Drident/High_Speed_Data/DAILY_REPPORT/TEST_FPGA_succes.jpeg

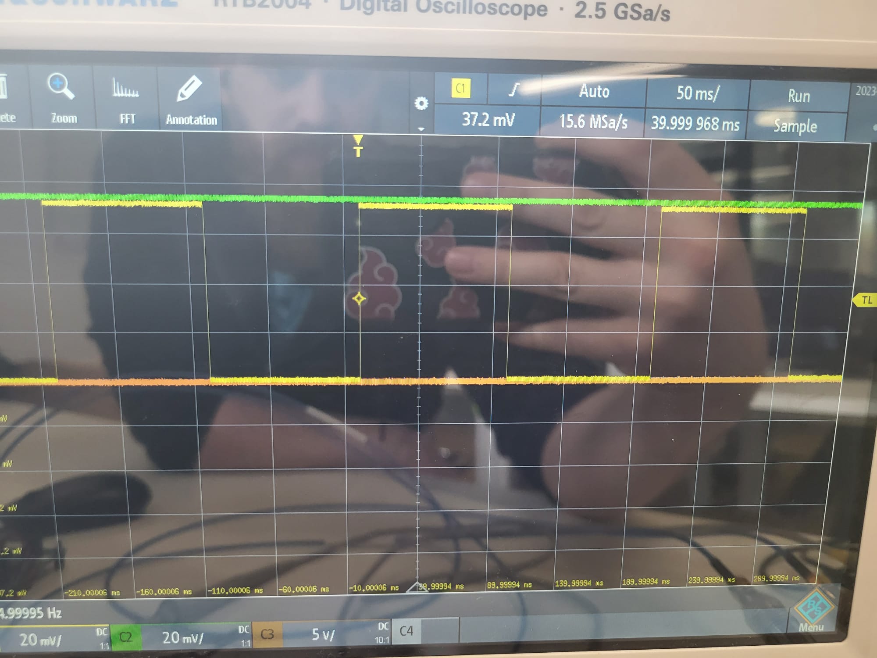
DAILY_REPPORT/TEST_FPGA_succes.jpeg
