Drident/High_Speed_Data/SD_card/README.txt

Channal trigg: put a value between 0 &3 (only in int)
Voltage Trigg(%): put a value between 0 &100 (double)
PreTrigg(%): put a value between 0 &100 (double)
