Drident/High_Speed_Data/TB_2023_Logger/LoggerBlockDiagram.pptx

µP: go_ACQ

64 MHz PCB osc.
Or External Input

FPGA

19-bit roll-over counter

Active?

Meas 1 MHz D=25%

1 MHz / 32MHz

1 MHz D=25%

32 MHz (16 periods)

µP: F-RAM address read-back

µP: SPI CLK

x6

F-RAM SCLK x4

µP: SPI sel

ADC SCLK

ADC: SPI SDO x4

meas SCLK

µP: SPI SDO

x4

F-RAM SDI x4
