Drident/High_Speed_Data/TB_2023_Logger/LoggerFunctionality.docx

## Power-up / idle ??

## Setup / readout

1. Processor read/write ADC registers
  - ADC_nCS control by proc, FRAM_x_nCS high, FPGA_nCS high
  - Proc_SPI ↔ ADC_SPI (SCLK, SDO_0, SDI, ADC_nCS)
2. Processor read/reset FPGA FRAM_ADDR_CNT and write FPGA ACQ_LEN (default 90% 2^19 )
  - ADC_nCS high, FRAM_x_nCS high, FPGA_nCS low
  - Proc_SPI ↔ FPGA_SPI (SCLK, SDO, SDI)
3. Processor read from one of four FRAM
  - ADC_nCS high, FRAM_x_nCS one low others high, FPGA_nCS high
  - Proc_SPI ↔ FRAM_SPI (SCLK, SDO, SDI)
4. Processor write to all four FRAM simultaneously (setup for acquisition)
  - ADC_nCS high, FRAM_x_nCS all low, FPGA_nCS high
  - Proc_SPI ↔ FRAM_SPI (SCLK, SDO, SDI)
  - FRAM_x_nCS stays low on transition to ACQ mode

## ACQ wait for trigger on external signal ACQ_trig

- Should happen after Setup point 4. FRAM_x_nCS must be continuously asserted low
- FPGA generates acquisition clock ACQ_CLK
  - Send to ADC_nCS
- FPGA generates acquisition SPI data clock ACQ_SCLK
  - Send to ADC_SCLK and FRAM_x_SCLK
- FPGA connects ADC_SDOx with FRAM_x_SDI
- FPGA increment FRAM_ADDR_CNT each ACQ_CLK rising edge
- Can only be interrupted by ACQ_trig (and global reset)

## ACQ trigger received on external signal ACQ_trig

- FPGA continues as above for ACQ_LEN additional ACQ_CLK rising edges
  - Then performs offset calibration
    - stops: ACQ_CLK, ACQ_SCLK
    - Change the analogue muxes to GND connection
    - Delay some time
    - starts: ACQ_CLK, ACQ_SCLK, records ~1000 samples
  - Then performs gain calibration
    - stops: ACQ_CLK, ACQ_SCLK
    - Change the analogue muxes to Reference DC voltage connection
    - Delay some time
    - starts: ACQ_CLK, ACQ_SCLK, records ~1000 samples
  - Then stops: ACQ_CLK, ACQ_SCLK, all four FRAM_x_nCS goes high
  - Signal ACQ_DONE to processor
  - Cannot be interrupted (except global reset)

FPGA external connections to other devices. → is input to FPGA, ← is output from FPGA
Proc. Connections | | ADC Connections | | FRAM_x Connections X 4 | | OTHER
→ | PROC_SCLK | ← | ADC_SCLK | ← | FRAM_x_SCLK | → | 64 MHz in
← | PROC_SDI | → | ADC_SDO_0 | → | FRAM_x_SDI | → | ACQ_trig
→ | PROC_SDO | → | ADC_SDO_1 | ← | FRAM_x_SDO? | → | Reset?
→ | PROC_nCS | → | ADC_SDO_2 | → | FRAM_x_nCS
→ | ACQ_pretrig | → | ADC_SDO_3
← | ACQ_DONE | ← | ADC_SDI?
| | ← | ADC_nCS
| 6 + mode control! | | 7 pins | | 16 pins | | 2 pins

- Could connect FRAM_x_SDO directly with PROC_SDI outside FPGA and tristate FPGA SPI bus.
- Could connect ADC_SDI directly with PROC_SDO outside FPGA and tristate FPGA SPI bus
- Can we reset from CRESET_B to redo configuration download from SRAM? Or power cycle reset?
