Drident/High_Speed_Data/TB_2023_Logger/forget_code/fram_h.pdf

1 /*
2 * fram_func.h
3 *
4 * Created on: 6 juil. 2023
5 | * Author: christop.grobety
6 */
7
8 #ifndef INC_FRAM_FUNC_H_
9 #define INC_FRAM_FUNC_H_ 10
11 #define MEMORY_SIZE 524288 12 #include "main.h"
13 #include <stdbool.h>
14 #include <stdio.h>
15
16 /**
17 * @brief Write one or more value in a FRAM
18 * @param State state_: FRAM where to send the value(s)
19 * @param TX_FRAM: Pointer of the table to send
20 * @param data_size: Number of values to send on the FRAM
21 * @param hspi_1 : SPI of the STM32 to use to send the value
22 */
23 void FRAM_write_one(enum State state_, uint8_t*TX_FRAM, uint8_t data_size, SPI_HandleTypeDef hspi_1);
24
25 /**
26 * @brief Write one or more value in all the FRAMs
27 * @param TX_FRAM: Pointer of the table to send
28 * @param data_size: Number of values to send on the FRAMs
29 * @param hspi_1 : SPI of the STM32 to use to send the value
30 */
31 void FRAM_write_all(SPI_HandleTypeDef hspi_1, uint8_t*TX_FRAM, uint8_t data_size); 32
33 /**
34 * @brief Write in all the FRAMs the instruction of receive datas from ADC DEVICE 35 * @param hspi_1 : SPI of the STM32 to use to send the value
36 */
37 void FRAM_write_ADC_to_FRAM(SPI_HandleTypeDef hspi_1);
38
39 /**
40 * @brief Write in all the FRAMs the instruction to set the register for write instruction
41 * @param hspi_1 : SPI of the STM32 to use to send the value
42 */
43 void FRAM_write_reg(SPI_HandleTypeDef hspi_1);
44
45 /**
46 * @brief Write in all the FRAMs the instruction to reset the register 47 * @param hspi_1 : SPI of the STM32 to use to send the value
48 */
49 void FRAM_reset_reg(SPI_HandleTypeDef hspi_1);
50
51 /**
52 * @brief Write in all the FRAMs the instruction to reset the register 53 * @param State state_: FRAM where to read the Register's values
54 * @param hspi_1 : SPI of the STM32 to use to send the value
55 */
56 void FRAM_read_reg(enum State state_, SPI_HandleTypeDef hspi_1); 57
58 /**
59 * @brief Read in a FRAM his Device's value
60 * @param hspi_1 : SPI of the STM32 to use to send the value 61 */
62 void FRAM_device(SPI_HandleTypeDef hspi_1);
63
64 /**
65 * @brief Read in a FRAM his Device's value
66 * @param State state_: FRAM where to read the Register's values
67 * @param add: Location of the first address to start read the value of a FRAM 68 * @param hspi_1 : SPI of the STM32 to use to send the value
69 * @param data_size : size of the address where to read value
70 * @return a pointer of a table with the FRAM's values
71 */

### 72 uint8_t* FRAM_read(enum State state_, uint32_t add,SPI_HandleTypeDef hspi_1, uint8_t

data_size);
73
74 /**
75 * @brief Reset the values of the Selector's pins to send in the FPGA 76 */
77 void PIN_reset();
78
79 /**
80 * @brief Send the value of pretrigger to the FPGA
81 * @param hspi_1 : SPI of the STM32 to use to send the value 82 * @param pretrig : pretrig's value to send to the FPGA
83 */
84 void setPreTrigg(SPI_HandleTypeDef hspi_1, uint8_t pretrig); 85
86 /**
87 * @brief Selection of the channel to trigg
88 * @param chan: value of the channel to use 89 */
90 void setTriggChannel(enum trig_channel chan); 91
92 /**
93 * @brief To turn on a Led
94 * @param color: color of the Led to turn on 95 */
96 void LED_on(enum color_Led color);
97
98 /**
99 * @brief To turn off a Led
100 */
101 void LED_off();
102
103
104 #endif /* INC_FRAM_FUNC_H_ */ 105
