Drident/High_Speed_Data/Bachelor/Board/icecube2/test/test_Implmnt/syntmp/statusReport.html

Project Settings
Project Name | test_syn | Implementation Name | test_Implmnt
Top Module | [auto] | Pipelining | 1
Retiming | 0 | Resource Sharing | 1
Fanout Guide | 10000 | Disable I/O Insertion | 0
Disable Sequential Optimizations | 0 | Clock Conversion | 1

Run Status
Job Name | Status | | | | CPU Time | Real Time | Memory | Date/Time
(compiler) | Complete | 34 | 75 | 0 | - | 00m:00s | - | 28.07.2023 14:09:21
(premap) | Complete | 5 | 2 | 0 | 0m:00s | 0m:00s | 134MB | 28.07.2023 14:09:23
(fpga_mapper) | Complete | 41 | 78 | 0 | 0m:01s | 0m:01s | 137MB | 28.07.2023 14:09:24
Multi-srs Generator | Complete | | | | | | | 28.07.2023 14:09:22

Area Summary
PADS | 35 | FLOPS | 151
RAMS (v_ram) | 0 | CARRYS | 60
LUTS (total_luts) | 212

Timing Summary
Clock Name | Req Freq | Est Freq | Slack
EC5LP|iGCK_clk | 112.8 MHz | 95.9 MHz | -1.564
System | 344.2 MHz | 507.3 MHz | 0.934

Optimizations Summary
Combined Clock Conversion | 1 / 0
