Drident/High_Speed_Data/TB_2023_Logger/forget_code/isrs_c.pdf

1 /*
2 * isrs.c
3 *
4 * Created on: Jun 30, 2023
5 | * Author: christop.grobety
6 */
7
8 #include "stm32l4xx_hal.h"
9 #include "main.h"
10 #include "fram_func.h"
11
12 void HAL_GPIO_EXTI_Callback(uint16_t GPIO_Pin)
13 {
14 if(GPIO_Pin == FPGA_DONE_Pin){
15 //---------------------------------------------------RECEIVE ADD------------------------------------------16 LED_on(BLUE);
17 start = true;
18 HAL_ResumeTick();
19 acqu = false;
20 //sleep_ = 1;
21 }
22 else if(GPIO_Pin == WAKE_UP_Pin ){
23 //---------------------------------------------------START ACQU------------------------------------------24 if(start){
25 HAL_ResumeTick();
26 start = false;
27 }
28 }
29 else if(GPIO_Pin == ARM_BUTTON_Pin){
30 //---------------------------------------------------RESET SYSTEM------------------------------------------31 if(reset){
32 reset = false;
33 HAL_NVIC_SystemReset(); 34 }
35 }
36 }
37
