Drident/High_Speed_Data/TB_2023_Logger/Lattice/iCE40UltraUltraPlusSG48Pinout.xlsx

# SG48 Pin Out For iCE5LP-1K, -2K, -4K & iCE40UP-5K
# Revision 0.3 - Add in UltraPlus Devices
# Revision 1.1 - Fix RGB pins, swapped pins 39 & 41
# Updated March 16, 2018
# Revision 2.0 - IOB_35b_SPI_CSN to IOB_35b_SPI_SS
# Updated Aug 4, 2020
 |  |  |  | iCE5LP-1K | iCE5LP-2K | iCE5LP-4K | iCE40UP-5K
FNC | Pin Type | BANK | Differential Pair | SG48 | SG48 | SG48 | SG48
IOB_0a | DPIO | 2 | TRUE_of_IOB_1b | 46 | 46 | 46 | 46
IOB_2a | DPIO | 2 | TRUE_of_IOB_3b | 47 | 47 | 47 | 47
IOB_3b_G6 | DPIO / GBIN | 2 | COMP_of_IOB_2a | 44 | 44 | 44 | 44
IOB_4a | DPIO | 2 | TRUE_of_IOB_5b | 48 | 48 | 48 | 48
IOB_5b | DPIO | 2 | COMP_of_IOB_4a | 45 | 45 | 45 | 45
IOB_6a | DPIO | 2 | TRUE_of_IOB_7b | 2 | 2 | 2 | 2
IOB_8a | PIO | 2 | TRUE_of_IOB_9b | 4 | 4 | 4 | 4
IOB_9b | PIO | 2 | COMP_of_IOB_8a | 3 | 3 | 3 | 3
creset_b | CONFIG | 1 |  | 8 | 8 | 8 | 8
IOB_13b | PIO | 1 |  | 6 | 6 | 6 | 6
CDONE | CONFIG | 1 |  | 7 | 7 | 7 | 7
IOB_16a | PIO | 1 |  | 9 | 9 | 9 | 9
IOB_18a | PIO | 1 |  | 10 | 10 | 10 | 10
IOB_20a | PIO | 1 |  | 11 | 11 | 11 | 11
IOB_22a | PIO | 1 | TRUE_of_IOB_23b | 12 | 12 | 12 | 12
IOB_23b | PIO | 1 | COMP_of_IOB_22a | 21 | 21 | 21 | 21
IOB_24a | PIO | 1 |  | 13 | 13 | 13 | 13
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
