Drident/High_Speed_Data/DAILY_REPPORT/Board.jpeg

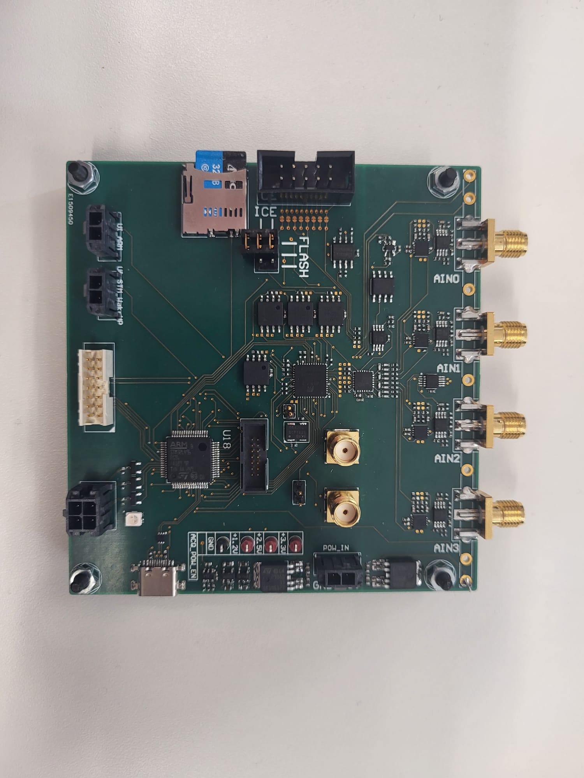
DAILY_REPPORT/Board.jpeg
