Drident/High_Speed_Data/DAILY_REPPORT/FPGA/adc_fram.png

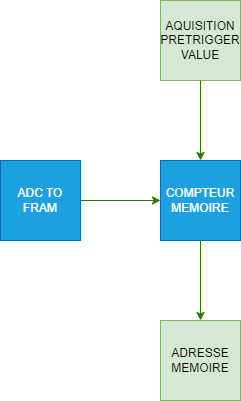
DAILY_REPPORT/FPGA/adc_fram.png
