Drident/High_Speed_Data/DAILY_REPPORT/FPGA/blocks.png

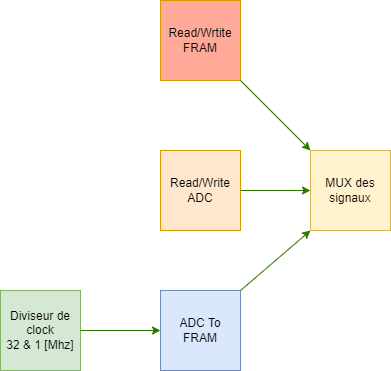
DAILY_REPPORT/FPGA/blocks.png
