Drident/High_Speed_Data/DAILY_REPPORT/FPGA/clock_1_2.png

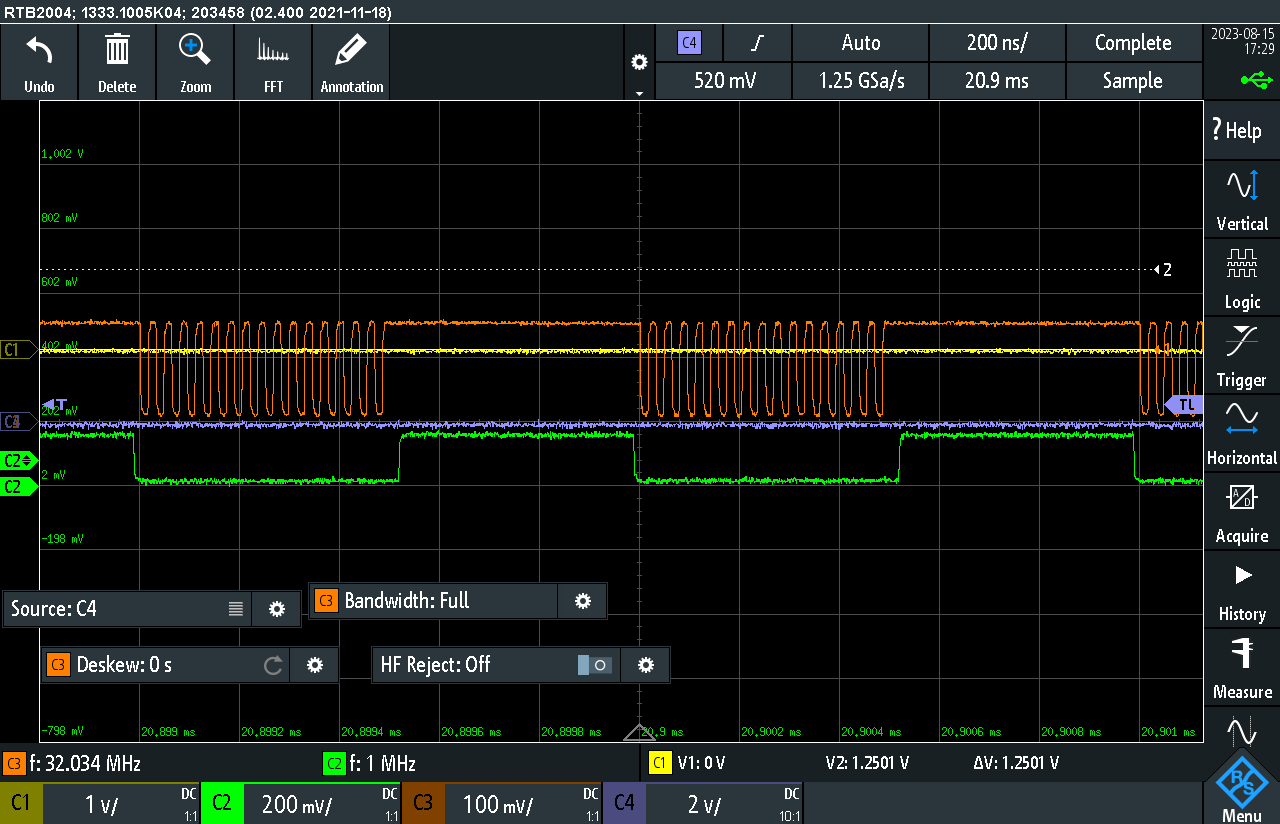
DAILY_REPPORT/FPGA/clock_1_2.png
