Drident/High_Speed_Data/DAILY_REPPORT/FPGA/CRAM.png

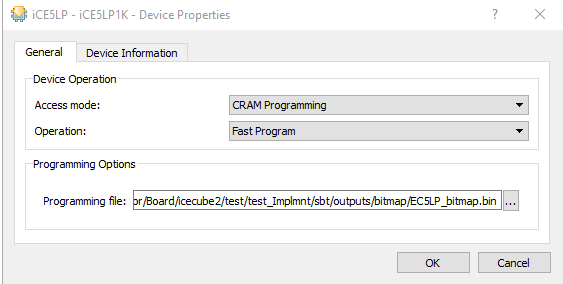
DAILY_REPPORT/FPGA/CRAM.png
