Drident/High_Speed_Data/DAILY_REPPORT/FPGA/delta_t.png

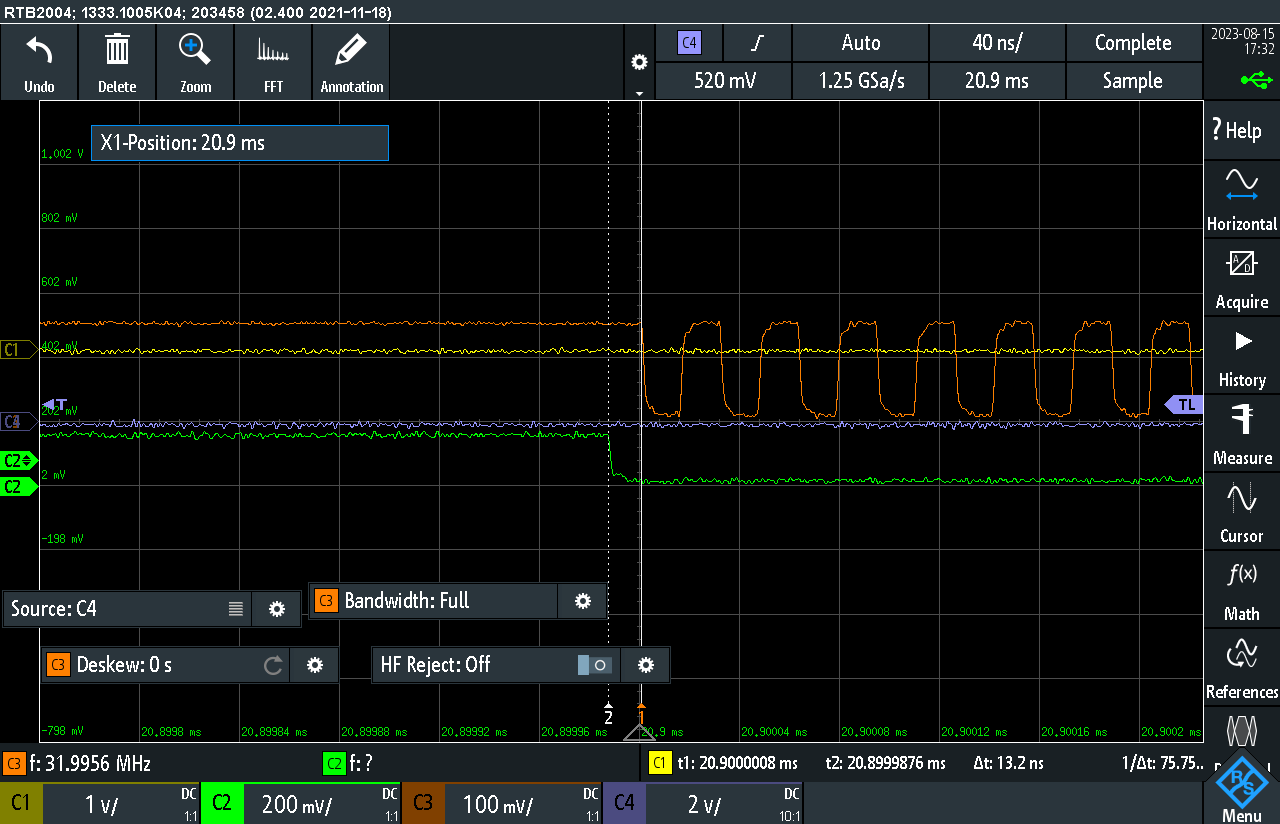
DAILY_REPPORT/FPGA/delta_t.png
