Drident/High_Speed_Data/DAILY_REPPORT/FPGA/file.png

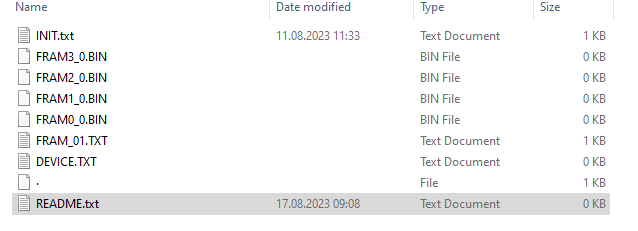
DAILY_REPPORT/FPGA/file.png
