Drident/High_Speed_Data/DAILY_REPPORT/FPGA/PRINCIPAL_BLOC.png

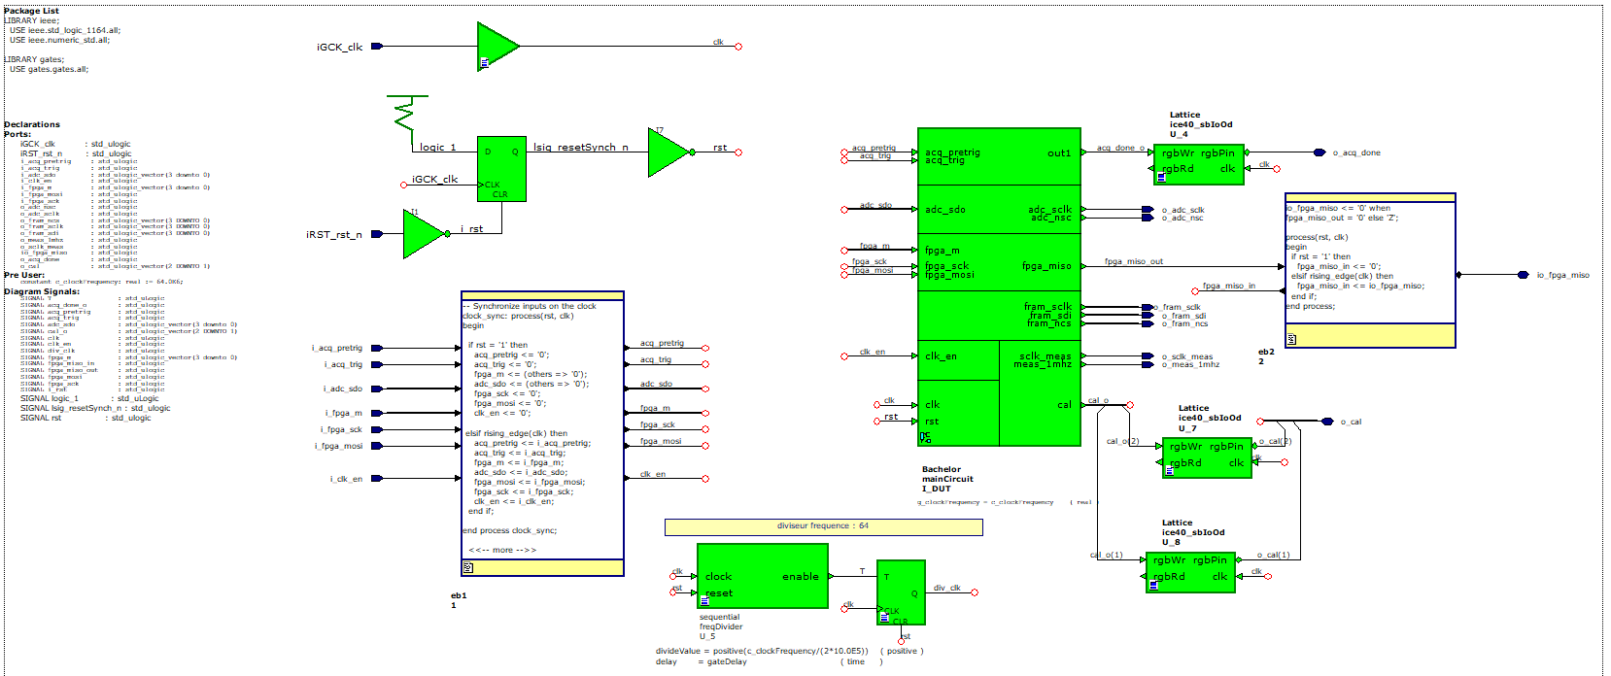
DAILY_REPPORT/FPGA/PRINCIPAL_BLOC.png
