Drident/High_Speed_Data/DAILY_REPPORT/FPGA/SD_CARD.png

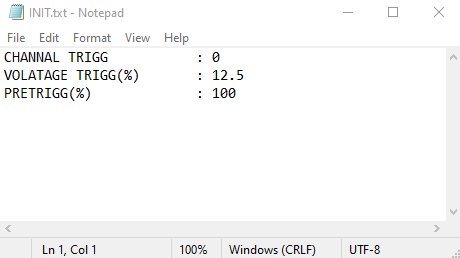
DAILY_REPPORT/FPGA/SD_CARD.png
