Drident/High_Speed_Data/DAILY_REPPORT/FPGA/SECOND_BLOC.png

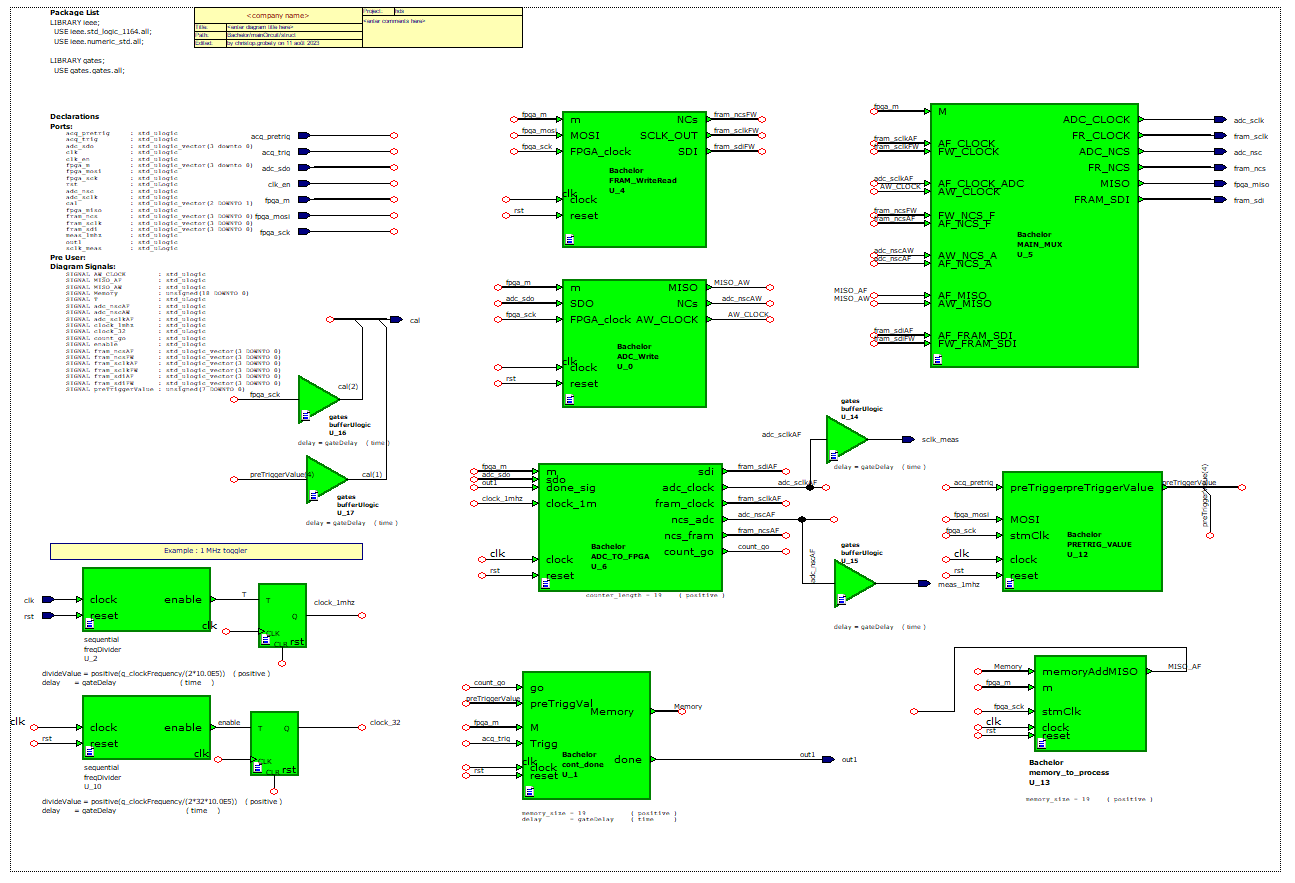
DAILY_REPPORT/FPGA/SECOND_BLOC.png
