Drident/High_Speed_Data/DAILY_REPPORT/FPGA/selector.png

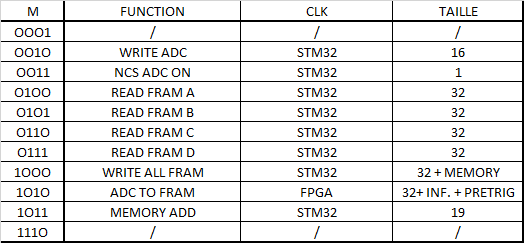
DAILY_REPPORT/FPGA/selector.png
