Drident/High_Speed_Data/DAILY_REPPORT/FPGA/SPI.png

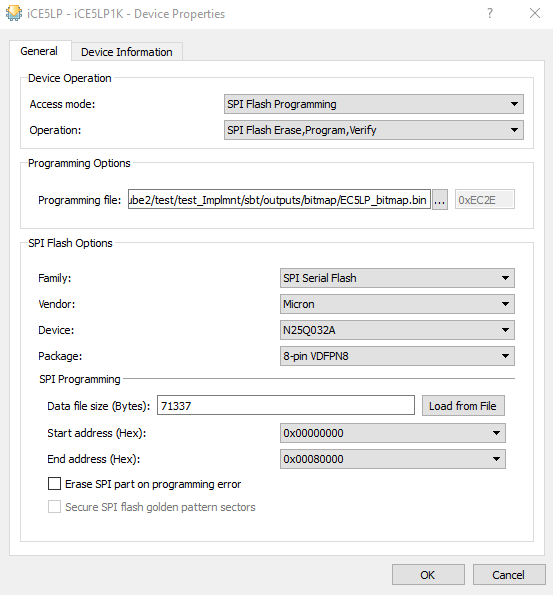
DAILY_REPPORT/FPGA/SPI.png
