Drident/High_Speed_Data/DAILY_REPPORT/FPGA/SPI_SHEMA.png

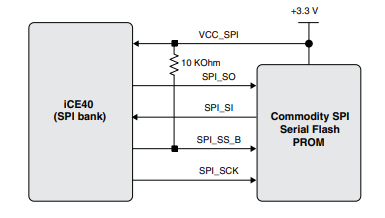
DAILY_REPPORT/FPGA/SPI_SHEMA.png
