Drident/High_Speed_Data/DAILY_REPPORT/image_dataSheet/ADC_TIMING.png

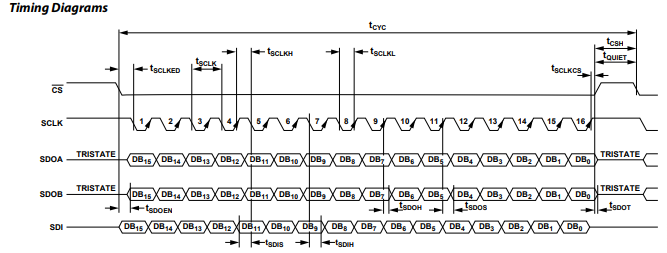
DAILY_REPPORT/image_dataSheet/ADC_TIMING.png
