Drident/High_Speed_Data/DAILY_REPPORT/image_dataSheet/bruit.png

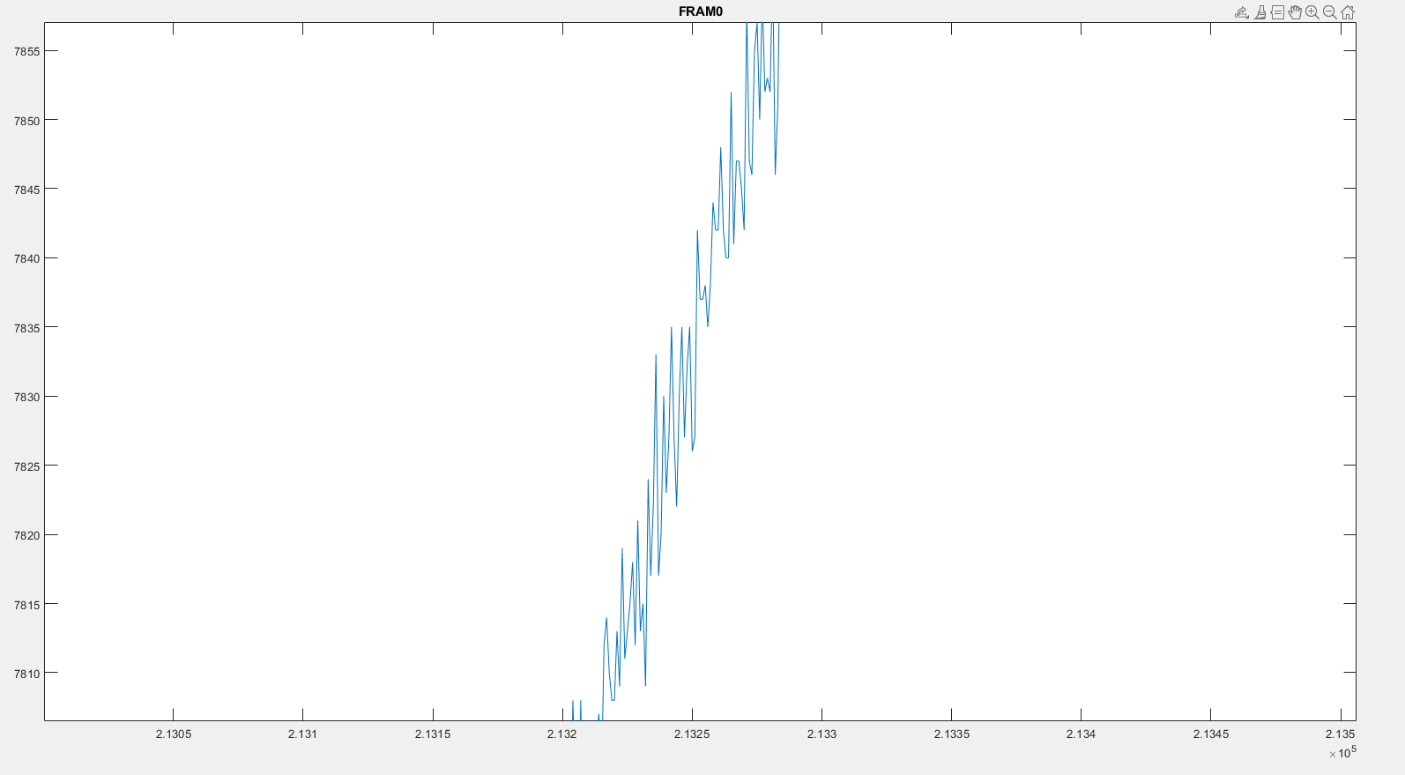
DAILY_REPPORT/image_dataSheet/bruit.png
