Drident/High_Speed_Data/DAILY_REPPORT/image_dataSheet/Capture d’écran 2023-08-11 172444.png

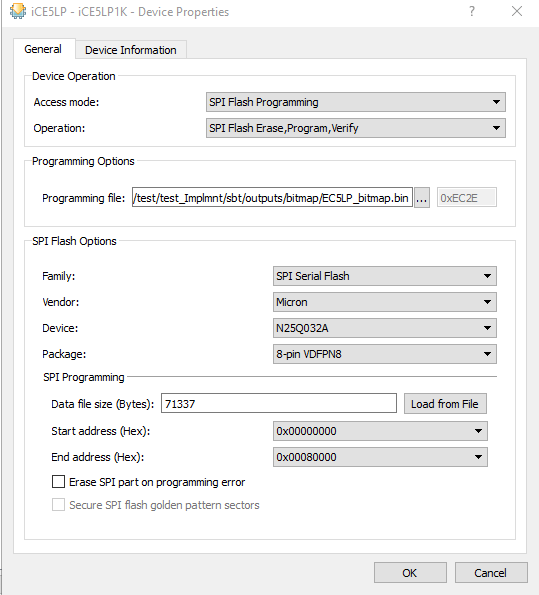
DAILY_REPPORT/image_dataSheet/Capture d’écran 2023-08-11 172444.png
