Drident/High_Speed_Data/DAILY_REPPORT/image_dataSheet/FRAM0_10HZ.png

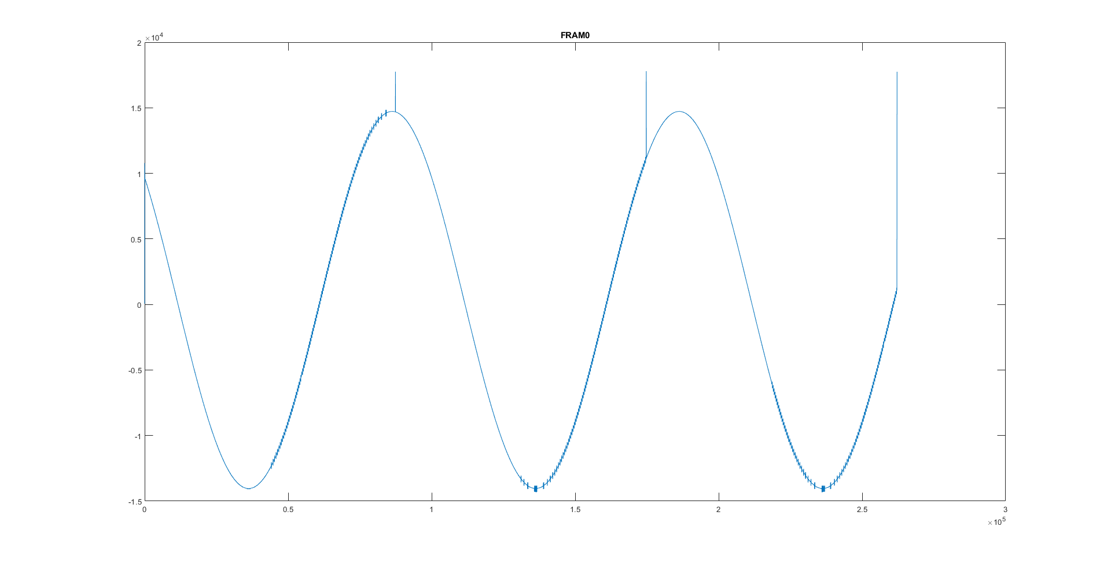
DAILY_REPPORT/image_dataSheet/FRAM0_10HZ.png
