Drident/High_Speed_Data/DAILY_REPPORT/image_dataSheet/FRAM0_70hz_1V_125OFF.png

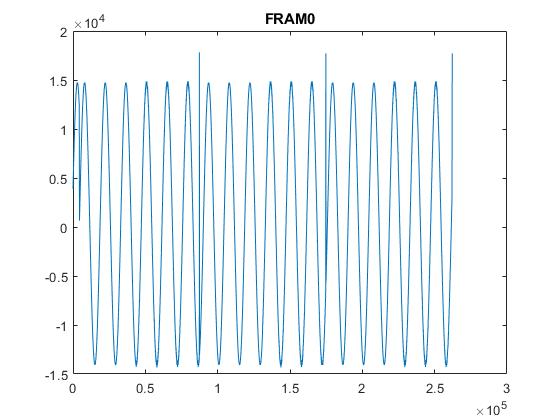
DAILY_REPPORT/image_dataSheet/FRAM0_70hz_1V_125OFF.png
