Drident/High_Speed_Data/DAILY_REPPORT/image_dataSheet/FRAM1_NULL.png

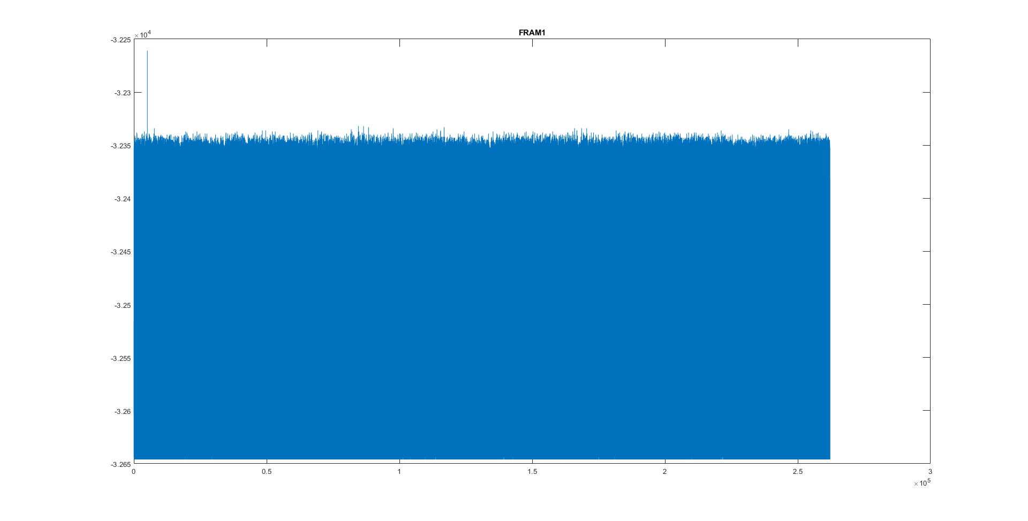
DAILY_REPPORT/image_dataSheet/FRAM1_NULL.png
