Drident/High_Speed_Data/DAILY_REPPORT/image_dataSheet/fram2_60HZ.png

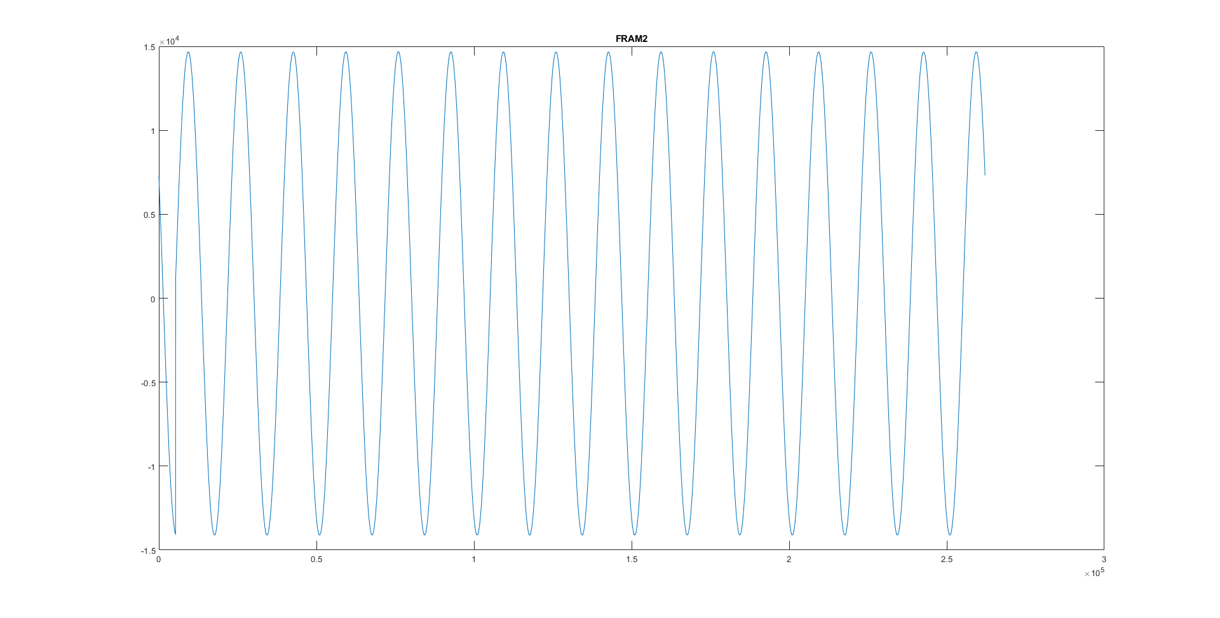
DAILY_REPPORT/image_dataSheet/fram2_60HZ.png
