Drident/High_Speed_Data/DAILY_REPPORT/image_dataSheet/FRAM_READ.png

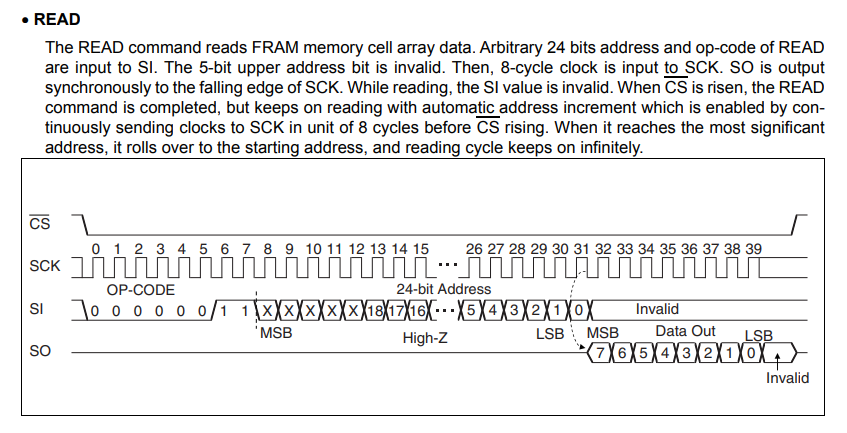
DAILY_REPPORT/image_dataSheet/FRAM_READ.png
