Drident/High_Speed_Data/DAILY_REPPORT/image_dataSheet/perturbation1.png

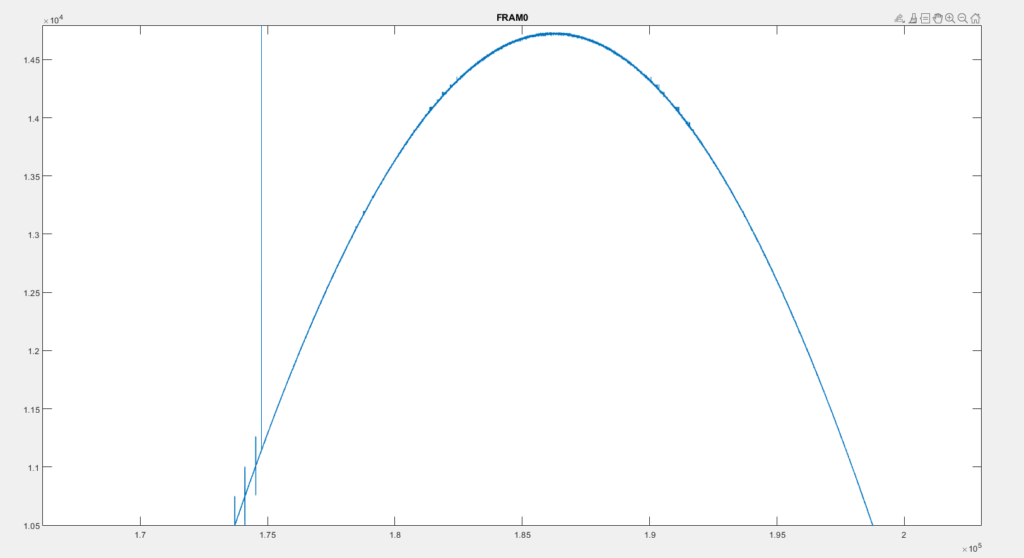
DAILY_REPPORT/image_dataSheet/perturbation1.png
