Drident/High_Speed_Data/DAILY_REPPORT/image_dataSheet/perturbation.png

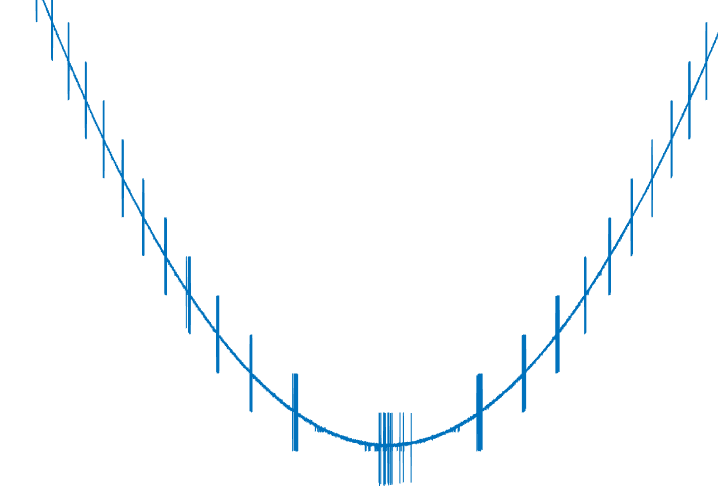
DAILY_REPPORT/image_dataSheet/perturbation.png
