Drident/High_Speed_Data/DAILY_REPPORT/image_dataSheet/perturbation_0.png

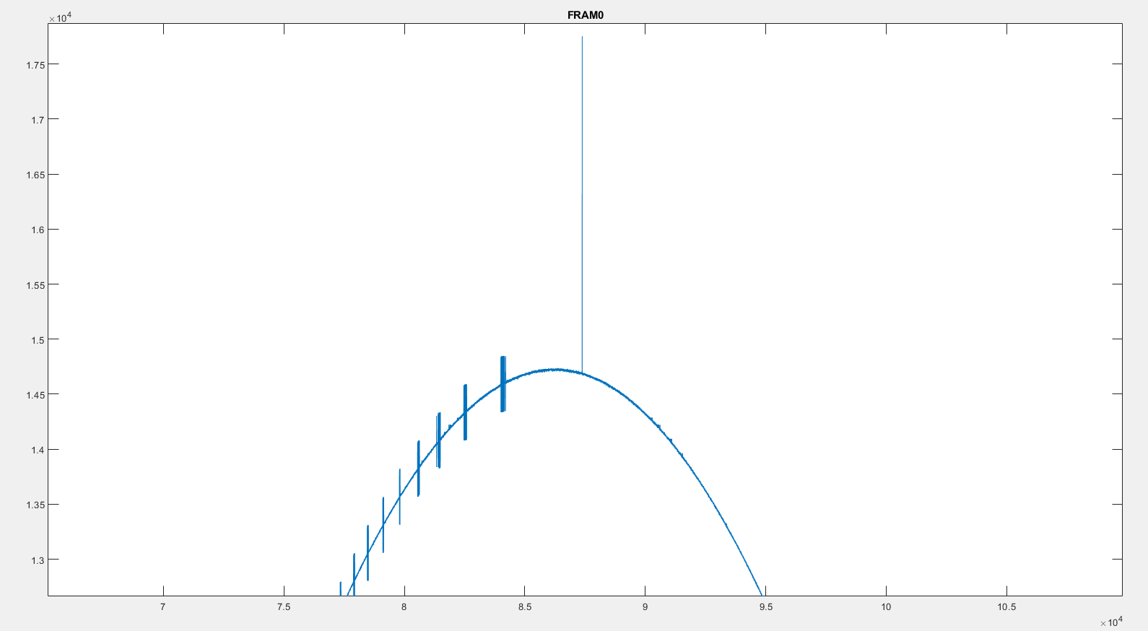
DAILY_REPPORT/image_dataSheet/perturbation_0.png
