Drident/High_Speed_Data/DAILY_REPPORT/image_dataSheet/untitled3.png

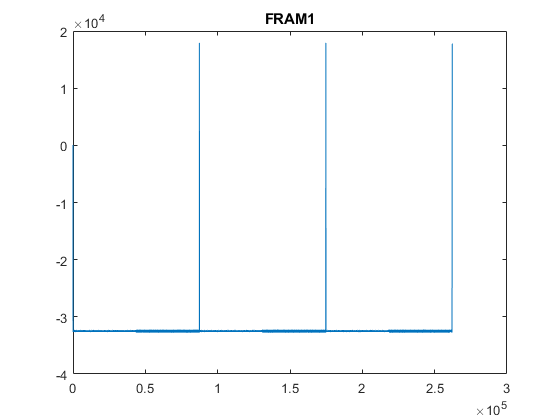
DAILY_REPPORT/image_dataSheet/untitled3.png
