Drident/High_Speed_Data/DAILY_REPPORT/image_simu_fpga/ADC_INIT.png

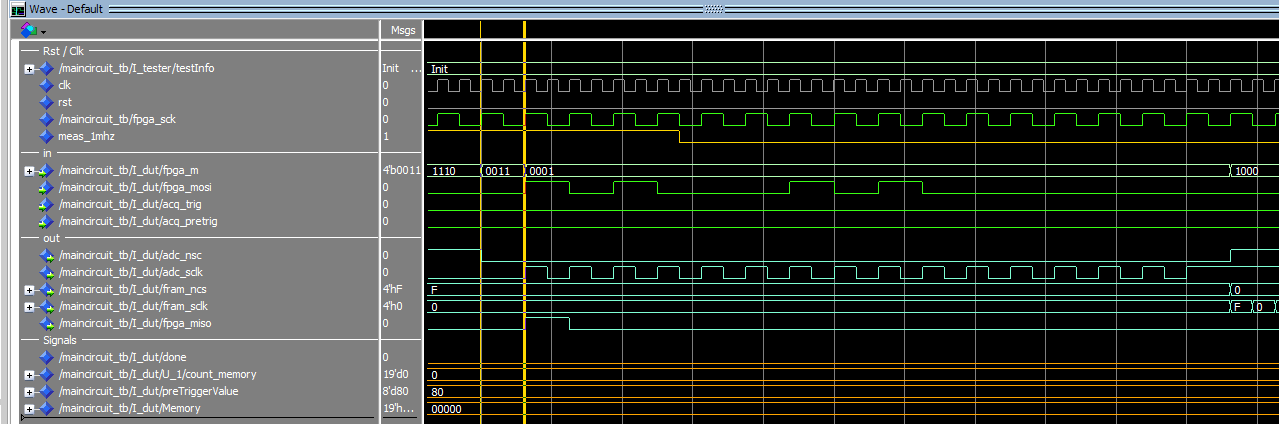
DAILY_REPPORT/image_simu_fpga/ADC_INIT.png
