Drident/High_Speed_Data/DAILY_REPPORT/image_simu_fpga/ADC_TOFRAM_BLOCKS.png

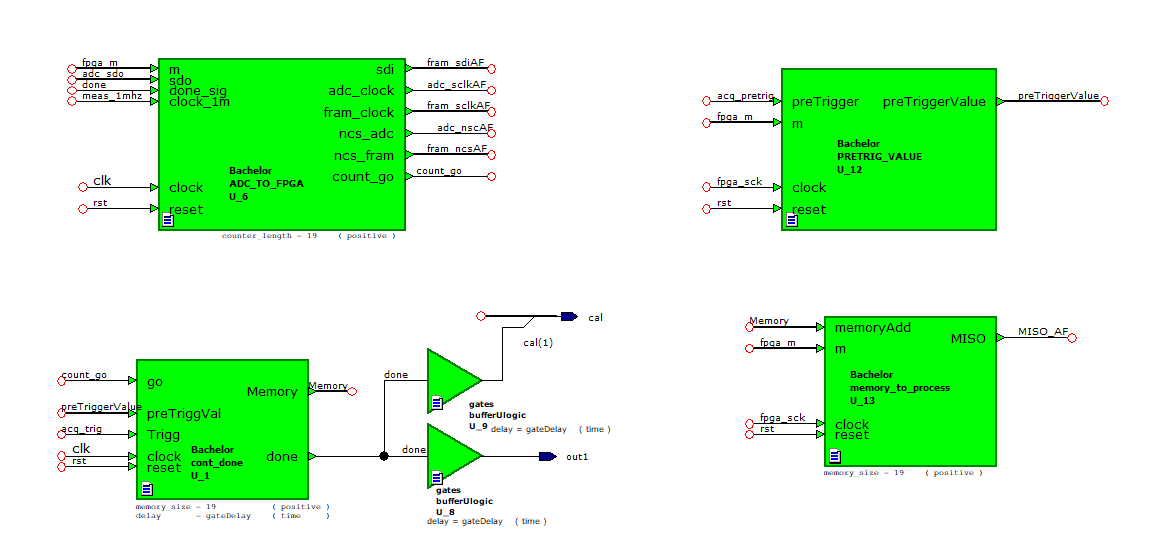
DAILY_REPPORT/image_simu_fpga/ADC_TOFRAM_BLOCKS.png
