Drident/High_Speed_Data/DAILY_REPPORT/image_simu_fpga/DELAY_aDC.png

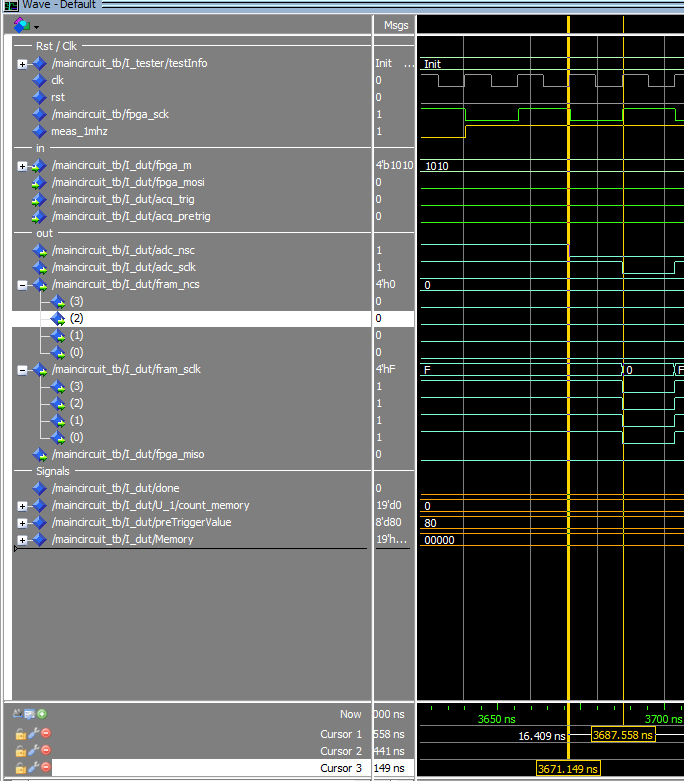
DAILY_REPPORT/image_simu_fpga/DELAY_aDC.png
