Drident/High_Speed_Data/DAILY_REPPORT/image_simu_fpga/FRAM_INIT_WRITE.png

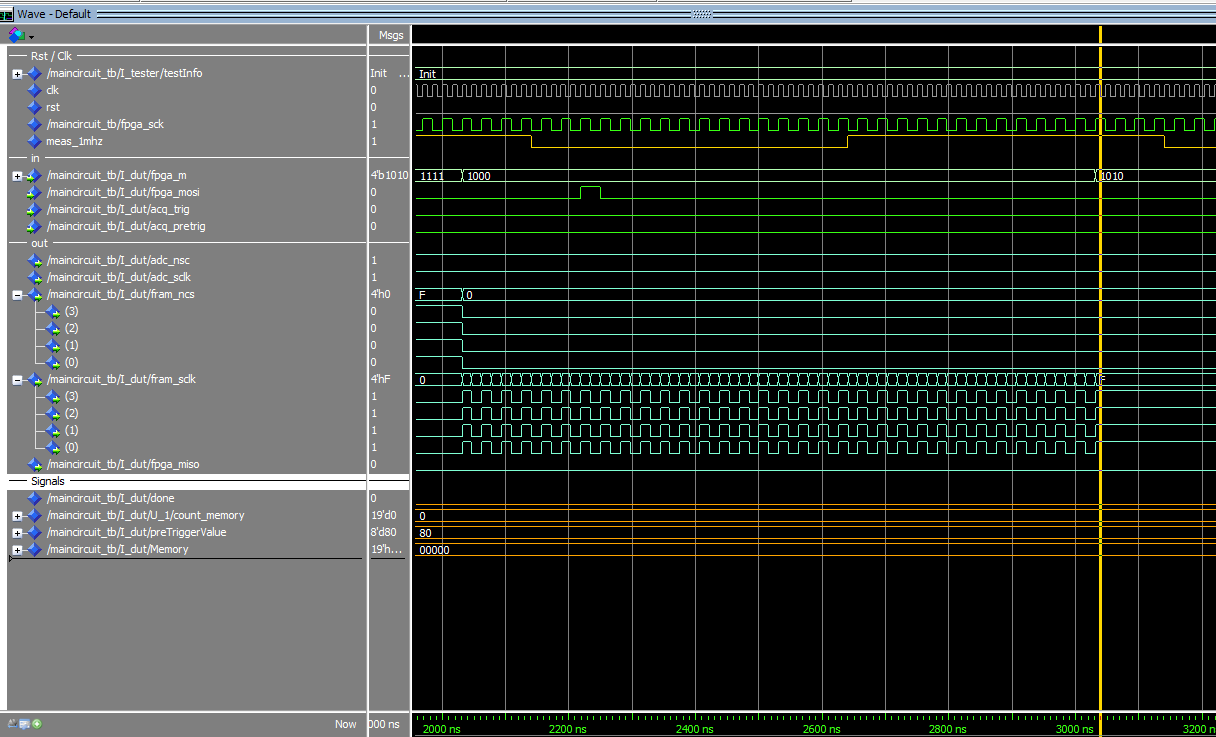
DAILY_REPPORT/image_simu_fpga/FRAM_INIT_WRITE.png
