Drident/High_Speed_Data/DAILY_REPPORT/image_simu_fpga/FRAM_READ_INIT.png

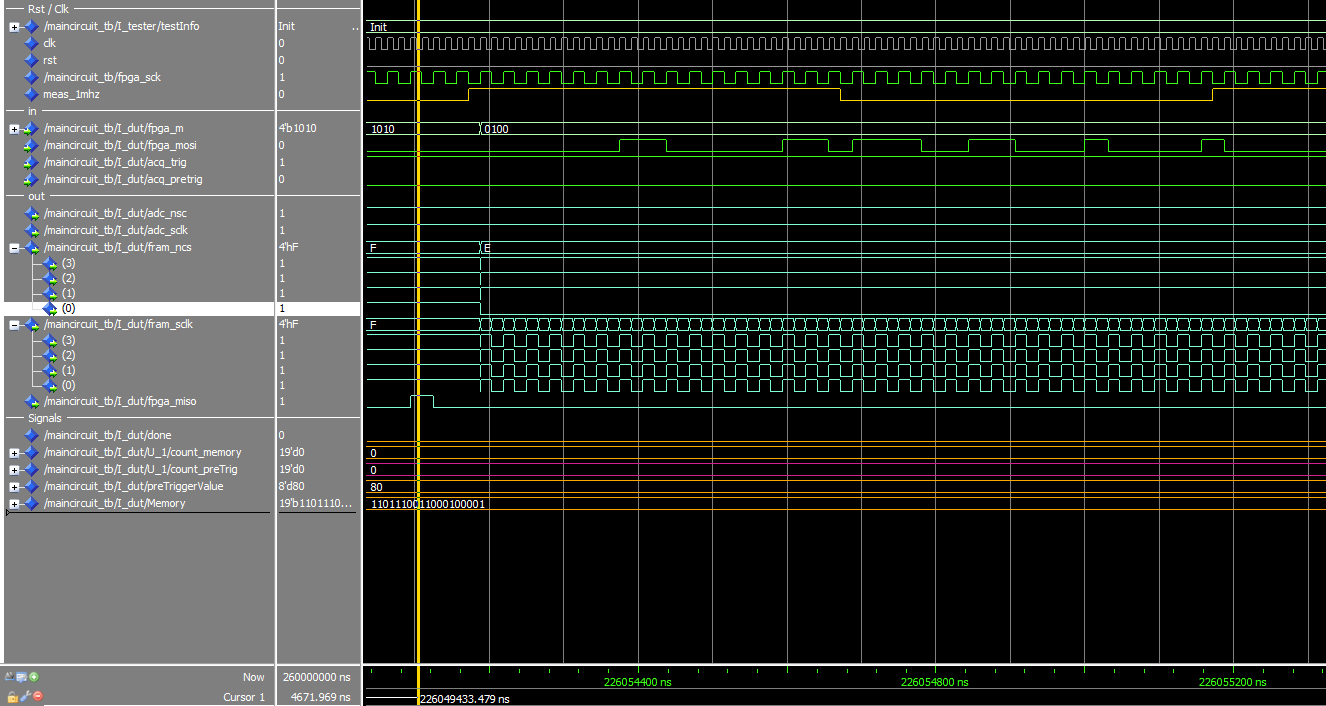
DAILY_REPPORT/image_simu_fpga/FRAM_READ_INIT.png
