Drident/High_Speed_Data/DAILY_REPPORT/image_simu_fpga/FRAM_WRITE_BLOCK.png

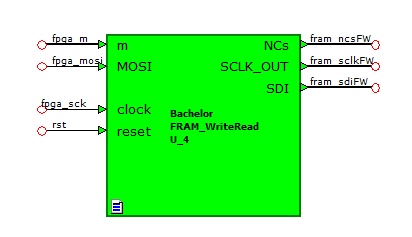
DAILY_REPPORT/image_simu_fpga/FRAM_WRITE_BLOCK.png
