Drident/High_Speed_Data/DAILY_REPPORT/image_simu_fpga/MEMORY_ADD.png

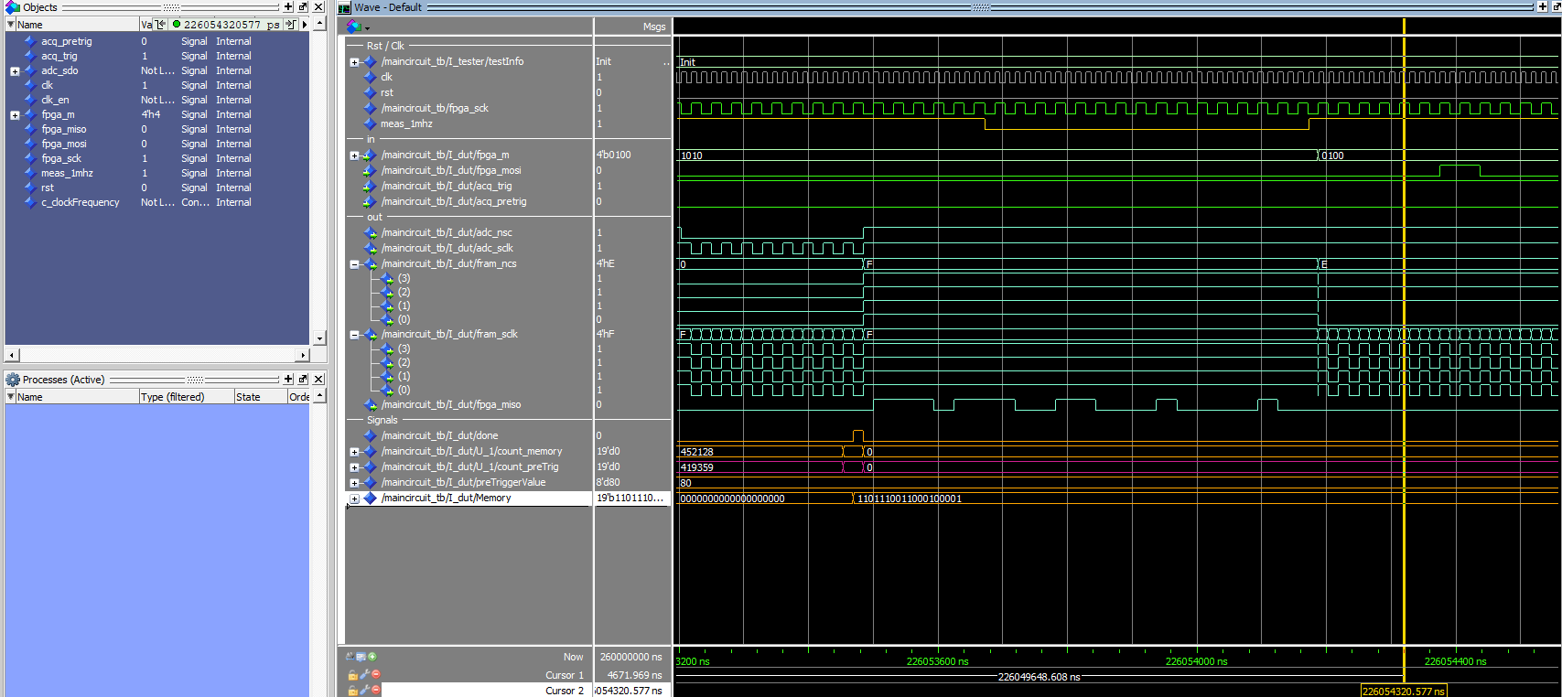
DAILY_REPPORT/image_simu_fpga/MEMORY_ADD.png
