Drident/High_Speed_Data/DAILY_REPPORT/image_simu_fpga/preTrig_INIT2.png

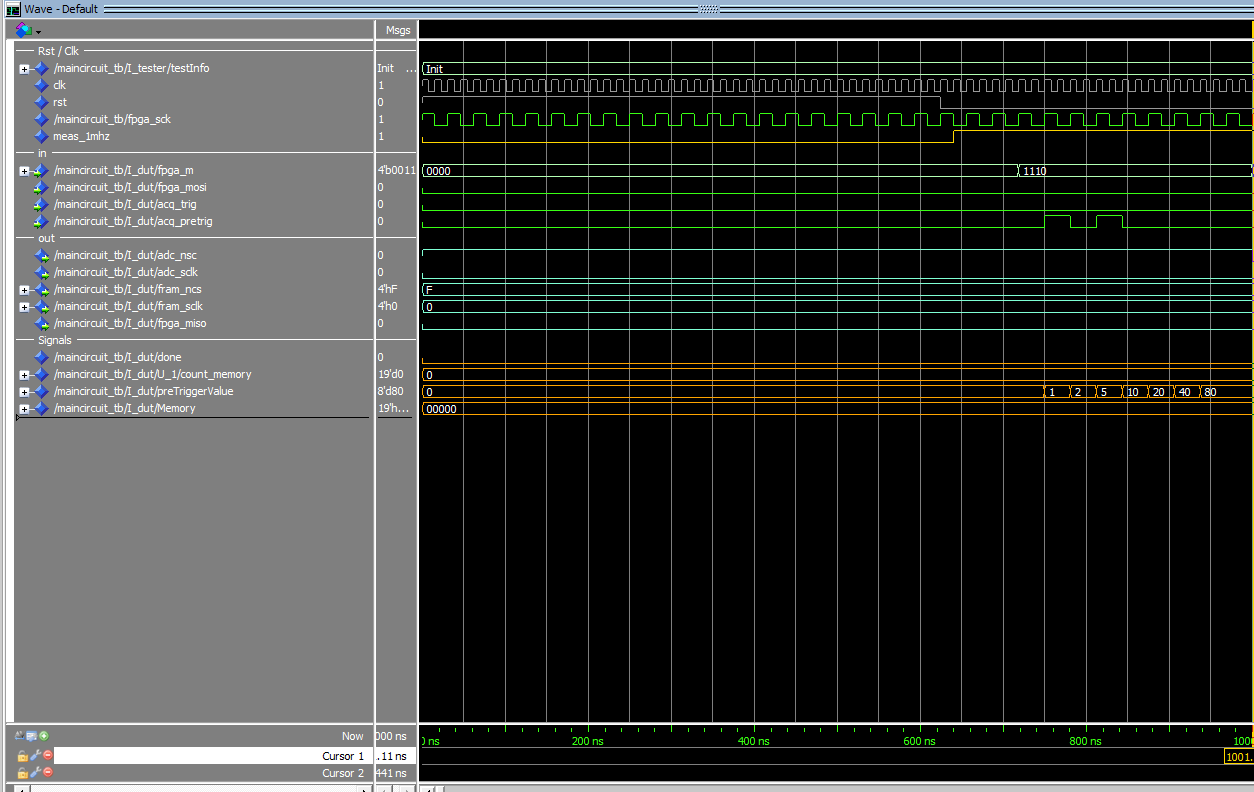
DAILY_REPPORT/image_simu_fpga/preTrig_INIT2.png
