Drident/High_Speed_Data/DAILY_REPPORT/image_simu_fpga/TRIGGER_DONE.png

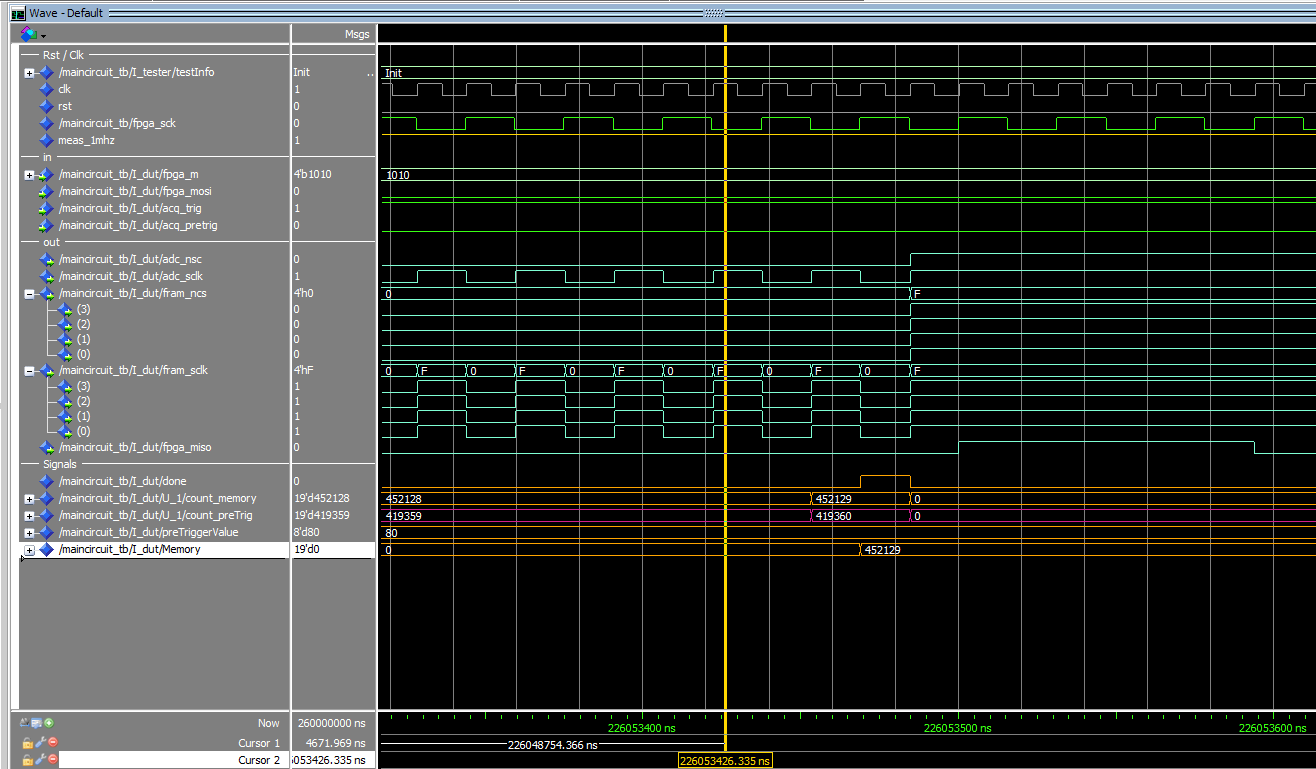
DAILY_REPPORT/image_simu_fpga/TRIGGER_DONE.png
