Drident/High_Speed_Data/DAILY_REPPORT/image_simu_fpga/TRIGGER_START.png

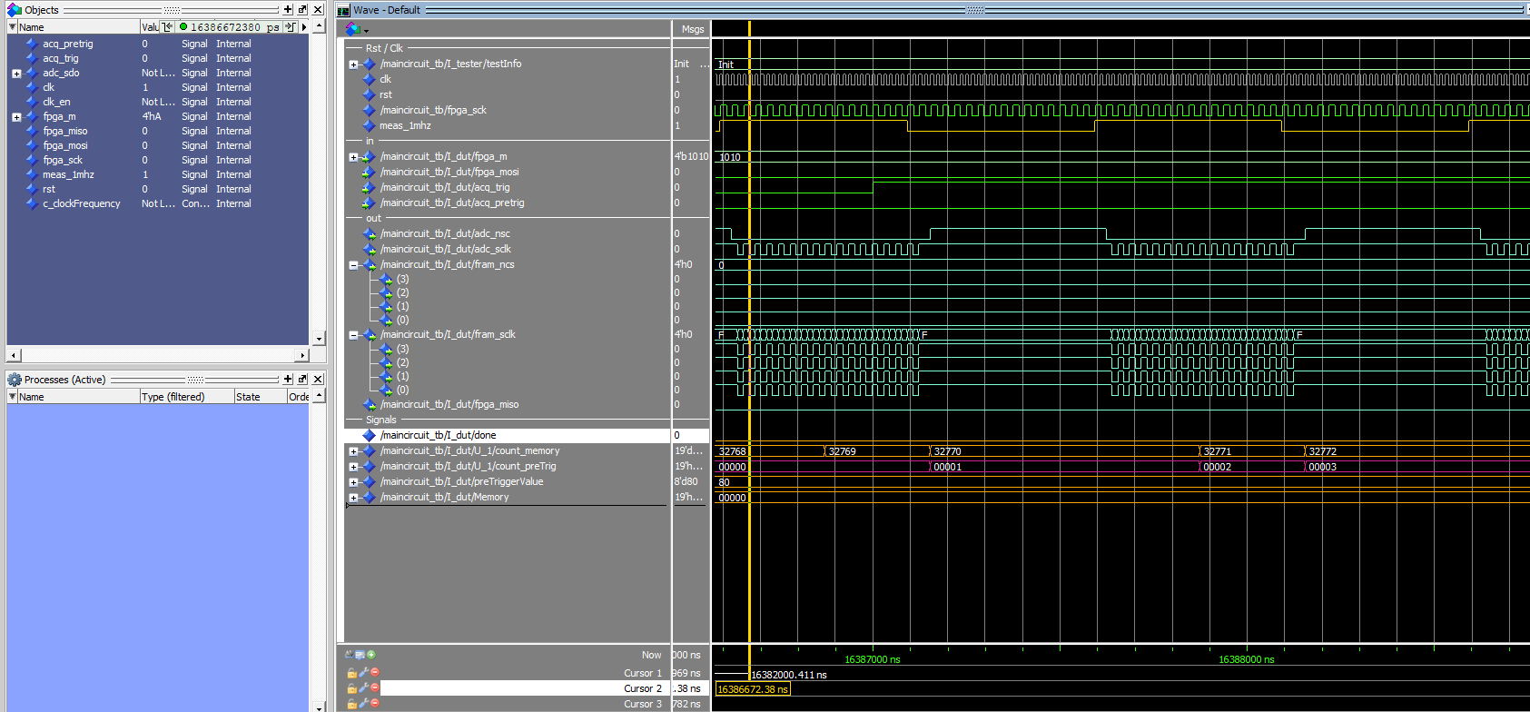
DAILY_REPPORT/image_simu_fpga/TRIGGER_START.png
