Drident/High_Speed_Data/DAILY_REPPORT/LATTICE_connector.jpeg

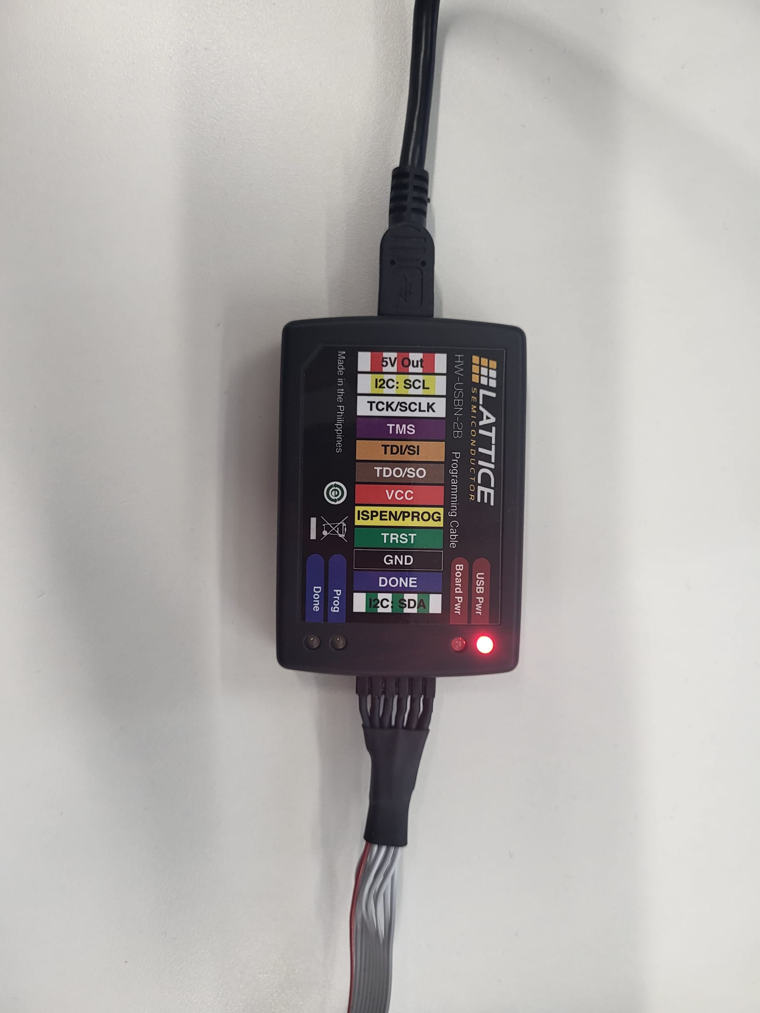
DAILY_REPPORT/LATTICE_connector.jpeg
