Drident/High_Speed_Data/DAILY_REPPORT/SHEMAS_DESIGN_IMAGE/VISUAL SHEMA.png

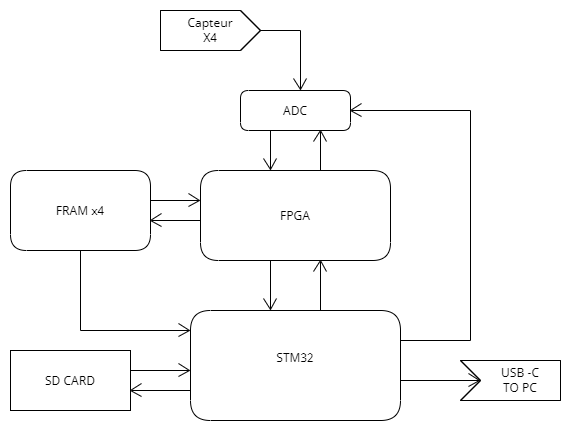
DAILY_REPPORT/SHEMAS_DESIGN_IMAGE/VISUAL SHEMA.png
