Drident/High_Speed_Data/DAILY_REPPORT/stm32/configuration.png

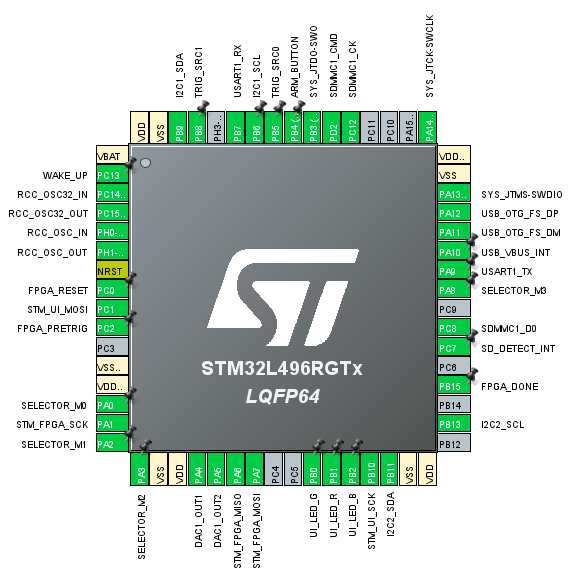
DAILY_REPPORT/stm32/configuration.png
