Drident/High_Speed_Data/DAILY_REPPORT/stm32/NVIC.png

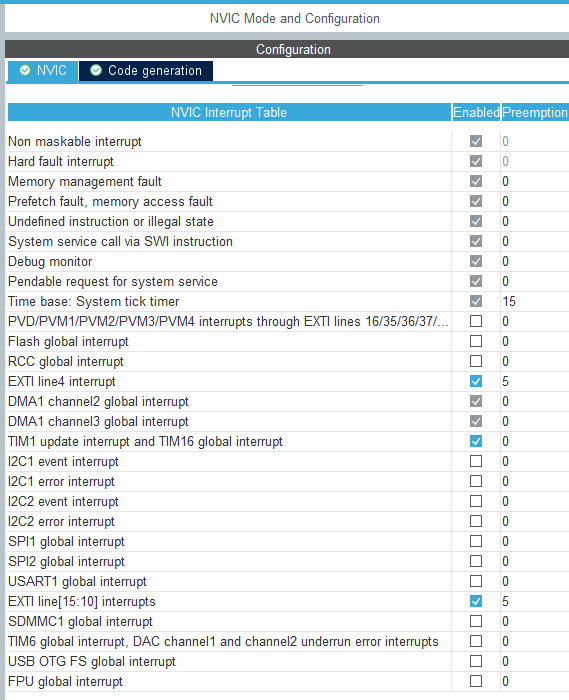
DAILY_REPPORT/stm32/NVIC.png
