Drident/High_Speed_Data/DAILY_REPPORT/stm32/SDMMC1.png

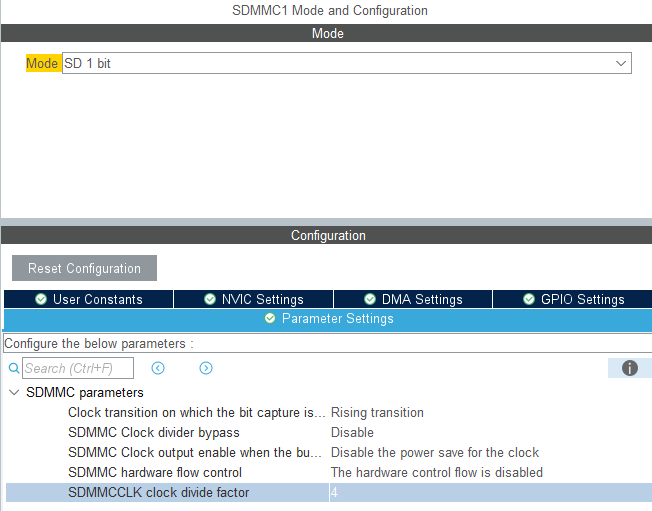
DAILY_REPPORT/stm32/SDMMC1.png
