Drident/High_Speed_Data/DAILY_REPPORT/stm32/SPI.png

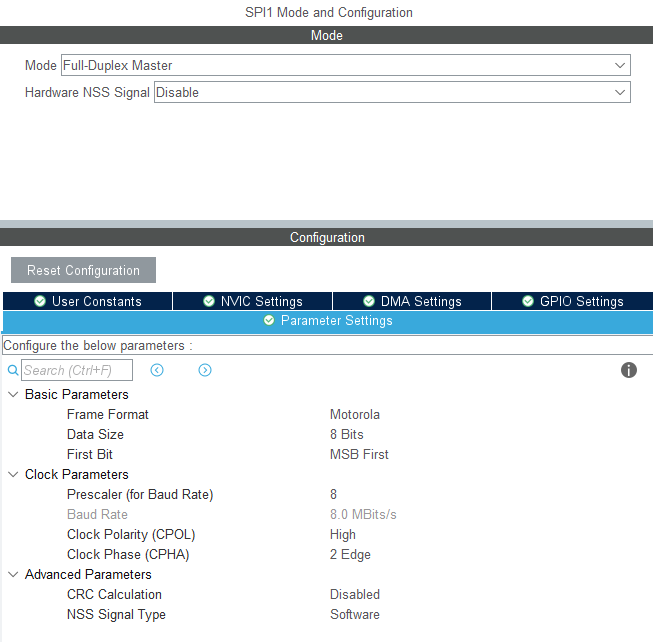
DAILY_REPPORT/stm32/SPI.png
