Drident/High_Speed_Data/DAILY_REPPORT/stm32/Timer.png

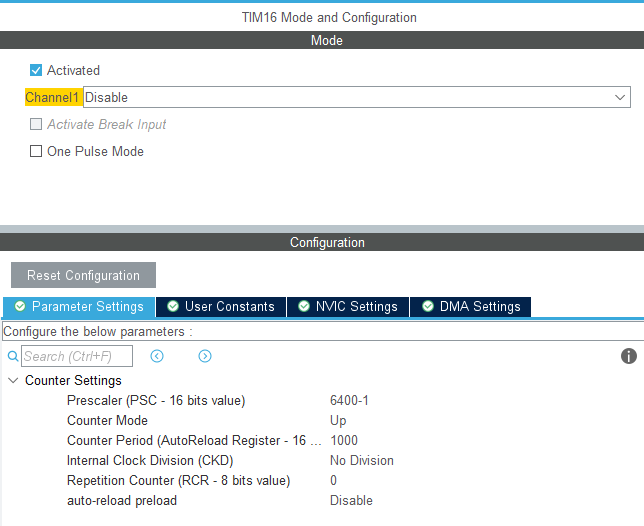
DAILY_REPPORT/stm32/Timer.png
