Drident/High_Speed_Data/DAILY_REPPORT/WhatsApp Image 2023-05-17 at 11.05.38 (1).jpeg

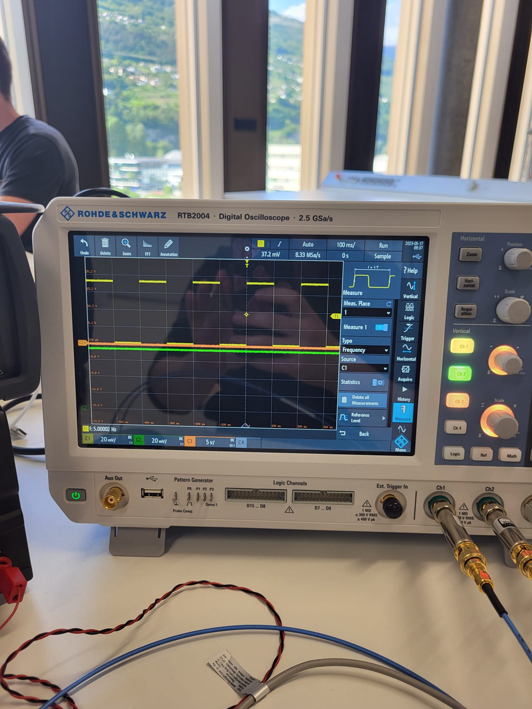
DAILY_REPPORT/WhatsApp Image 2023-05-17 at 11.05.38 (1).jpeg
