Drident/High_Speed_Data/divers/Capture d’écran 2023-05-30 125516.png

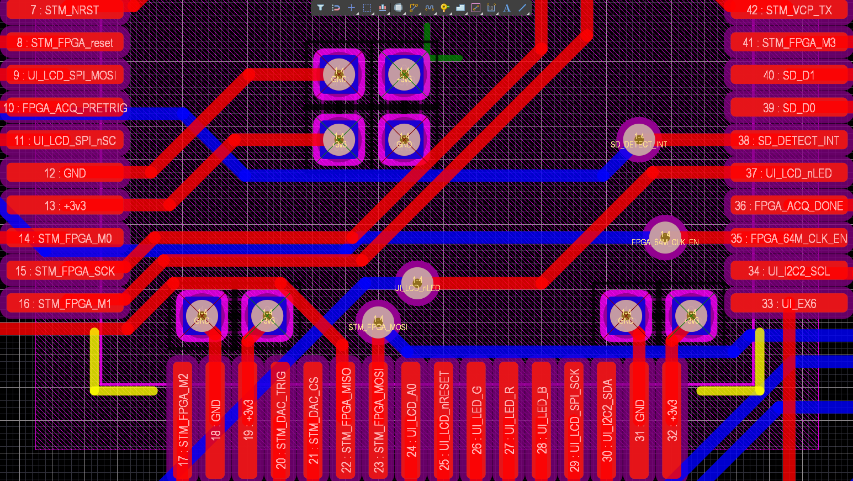
divers/Capture d’écran 2023-05-30 125516.png
