Drident/High_Speed_Data/divers/clock_config.PNG

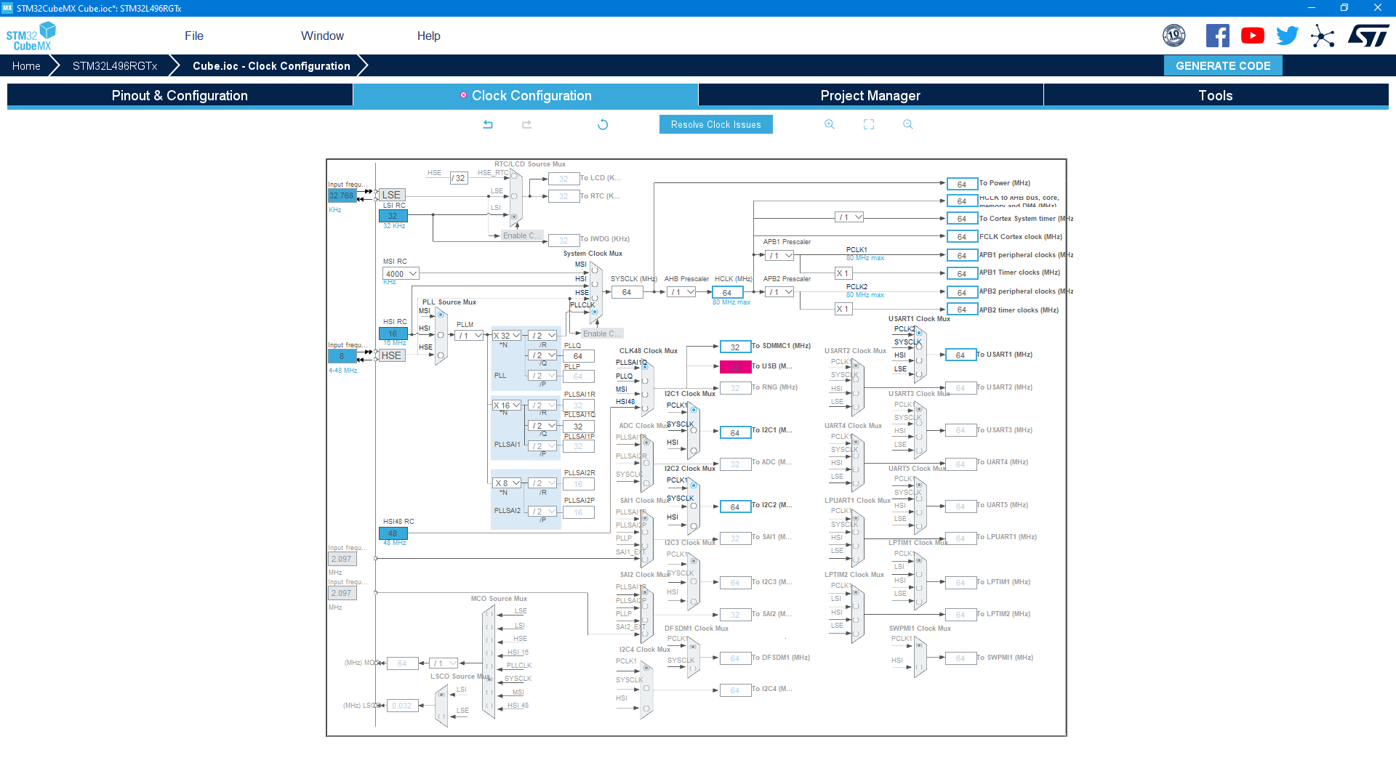
divers/clock_config.PNG
