Drident/High_Speed_Data/divers/Clock_config_2.png

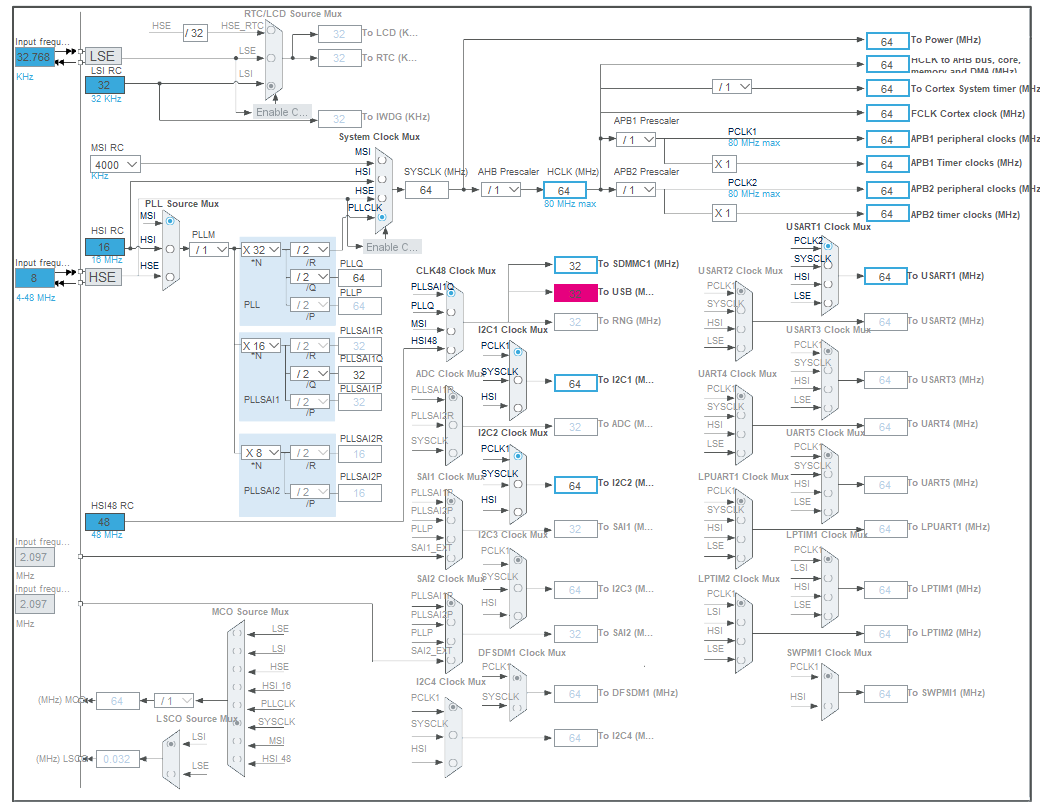
divers/Clock_config_2.png
