Drident/High_Speed_Data/TB_2023_Logger/datasheets/CPOL_CPHA.png

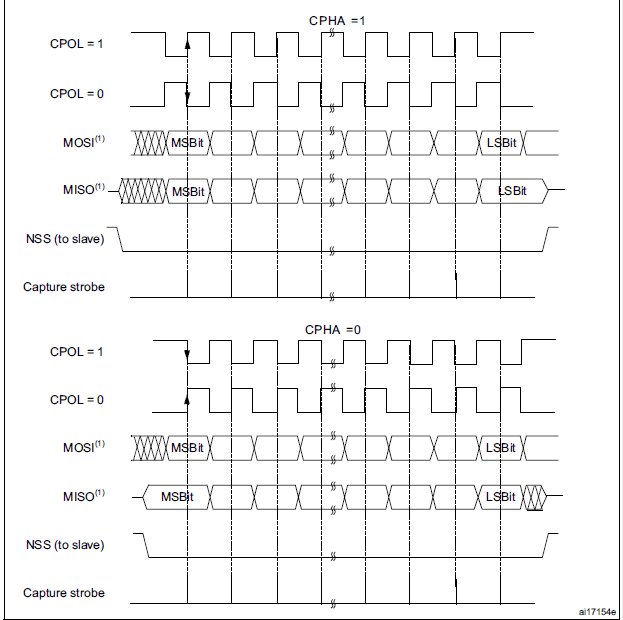
TB_2023_Logger/datasheets/CPOL_CPHA.png
