Drident/High_Speed_Data/TB_2023_Logger/Cube/work/docs/tests/RTOsc-TestCases.xlsx

Realtime Oscilloscpe Test Cases
# | Group | Title |  | Description
 | Signal Aquisition
A1 |  | Check if ADC Signal acquisition is working |  | Is buffer continuously feed with new ADC measures?
A2 |  | Check TIM1 continously trigger the ADC |  | Not software trigger, nor ADC continous conversion mode
A3 |  | Check TIM1 trigger frequency |  | Is TIM1 trigger frequency as expected?
 | Signal Frequencies
 |  | Check Sinus wave can be correctly measured
B1 |  |  | 50 Hz Signal | Is the signal visible
B2 |  |  | 370 Hz Signal | What is your sampling rate
B3 |  |  | 500 Hz Signal | How can you proove the that the frequency of the signal is right
B4 |  |  | 700 Hz Signal | Could you sample sinus with still higher frequencies
 | Maximum Sampling Rate
 |  | Check maximum sampling rate |  | Inidcate if tests were made with or without DMA
C1 |  |  | Sample singnal with 10 k samples/s | Signal sampling with 10 k samples/s working?
C2 |  |  | Sample singnal with 100 k samples/s | Signal sampling with 100 k samples/s working?
C3 |  |  | Sample singnal with 1 M samples/s | Signal sampling with 1 M samples/s working?
 | Signal Display |  |  | Take for every test a picture of the LCD display
 |  | Check if Sinus wave can be correclty visualised |  | Which sample frequency was used?
D1 |  |  | 50 Hz Signal with 500 us/div time base | Is sampling frequency high enough? Are there enough point?
D2 |  |  | 50 Hz Signal with 10 ms/div time base | "
D3 |  |  | 1 kHz Signal with 500 us/div time base | "
D4 |  |  | 1 kHz Signal with 10 ms/div time base | "
 | Display Refresh Rate
 |  | Check maximum display refresh rate
E1 |  |  | Display refresh rate: 50 Hz | Discribe the effects seen on the display
E2 |  |  | Display refresh rate: 66 Hz | "
E3 |  |  | Display refresh rate: 100 Hz | "
 | Time Divisions Display |  |  | Take a 1kHz frequency as input signal
 |  | Check if changes of x-axis scaling take effect on signal view
F1 |  |  | From 500 us/div to 1 ms/div | Does signal view change accordingly?
F2 |  |  | From 1 ms/div to 2 ms/div | "
F3 |  |  | From 2 ms/div to 5 ms/div | "
F4 |  |  | From 5 ms/div to 10 ms/div | "
F5 |  |  | From 10 ms/div back to 5 ms/div | "
F6 |  |  | From 5 ms/div back to 2 ms/div | "
F7 |  |  | From 2 ms/div to 1 ms/div | "
F8 |  |  | From 1 ms/div to 500 us/div | "
 |  |  | OPTIONAL
 | Trigger Signal Display
 |  | Check if when enabling signal triggering, the periodic signal stays still on the display
G1 |  |  | 50 Hz rectangulary signal with 500 us/div time base
G2 |  |  | 50 Hz rectangulary signal with 1 ms/div time base
G3 |  |  | 50 Hz rectangulary signal with 2 ms/div time base
G4 |  |  | 50 Hz rectangulary signal with 5 ms/div time base
G5 |  |  | 50 Hz rectangulary signal with 10 ms/div time base
G6 - G10 |  |  | Same with a triangle signal arround 1kHz on all time bases
G11 - G15 |  |  | Same with a sinusoidal signal arround 1kHz on all time bases
 | Sampling with DMA
 |  | Analyse effects on system when using DMA on the ADC
H1 |  |  | Check the maximum sampling frequency with DMA | Can the sampling frequency now be higher?
H2 |  |  | Check maximum display refresh rate of display | Can the display refresh rate now by higher?
 | Long-Term Tests |  |  | Indicate if tests were made with or without RTOS
 |  | Does the software hang after a while?
L1 |  |  | Check if the system is running without user interaction for about 5 minutes
L2 |  |  | Check if system is running with continuous user interaction for about 5 minutes
L3 |  |  | Check if system is running for more then 6 hours
