Drident/High_Speed_Data/AltiumLibs/SMS-107-02-G-S.stp

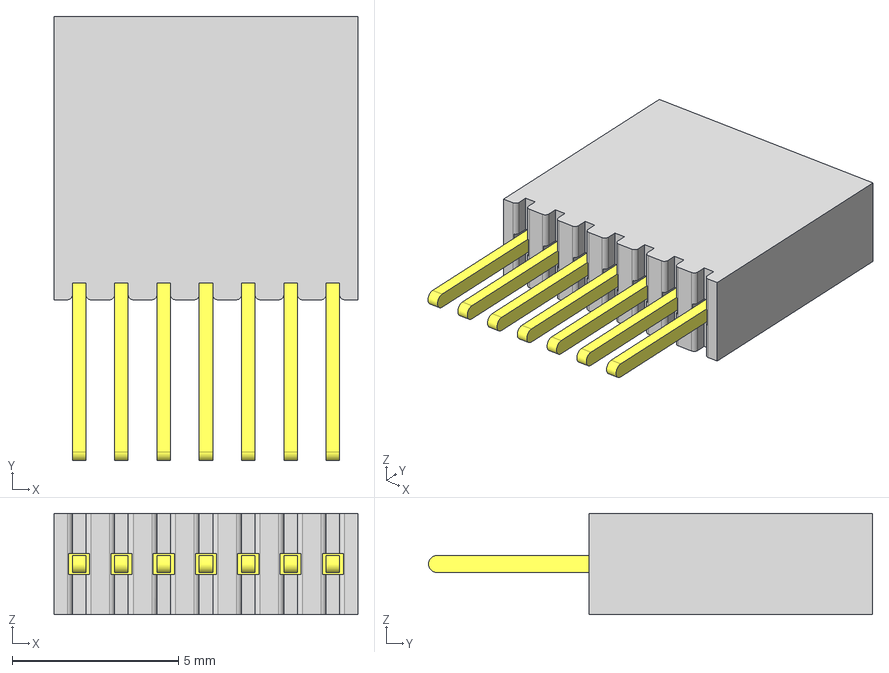
[picture p88: CAD file, 2023-08-17]
AltiumLibs/SMS-107-02-G-S.stp
9.12 x 13.3 x 3.05 mm
C-16-02-07-S
SMS-107-01-S_socket
