Drident/High_Speed_Data/AltiumLibs/SHF-107-01-L-D-TH.stp

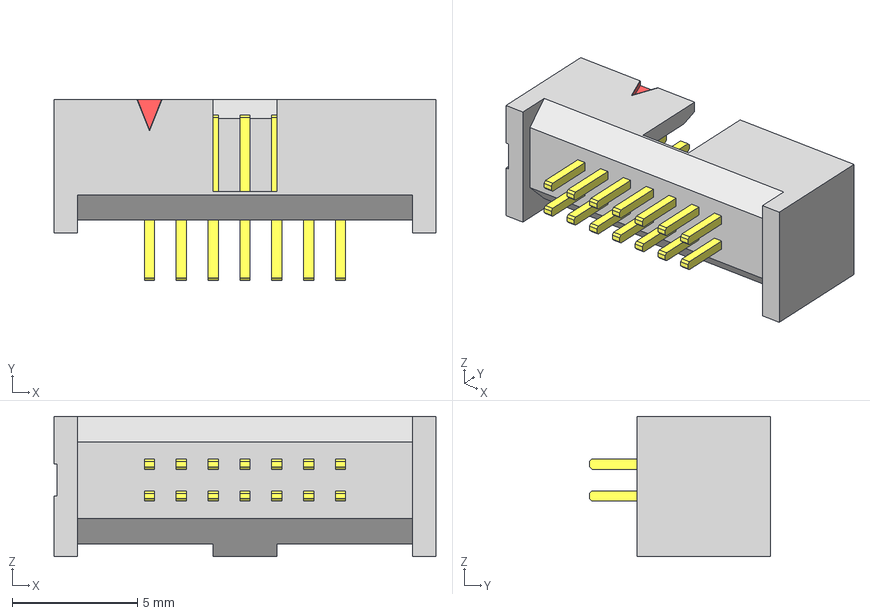
[picture p89: CAD file, 2023-08-17]
AltiumLibs/SHF-107-01-L-D-TH.stp
15.2 x 7.24 x 5.59 mm
T-1S71-02-07-D-TH
SHF-First_Position_Indicator
SHF-107-01-D_header
