Drident/High_Speed_Data/AltiumLibs/MOLEX_430450409.stp

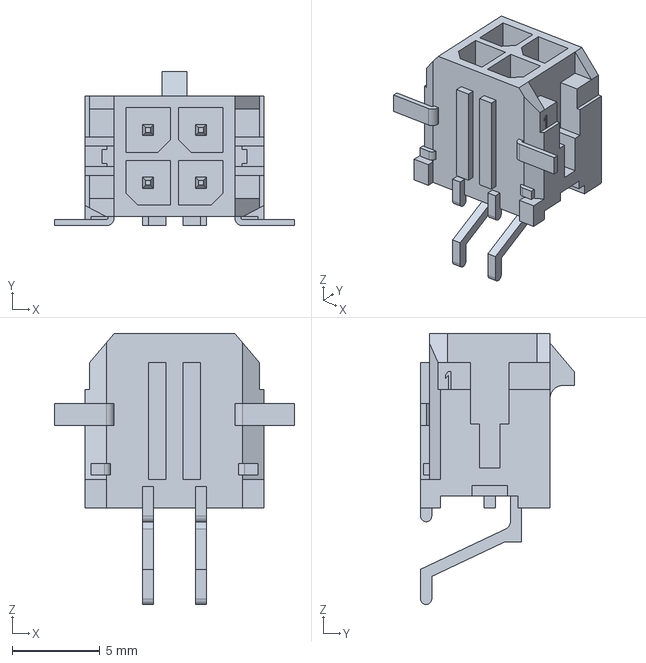
[picture p90: CAD file, 2023-08-17]
AltiumLibs/MOLEX_430450409.stp
13.7 x 8.77 x 15.4 mm
