Drident/High_Speed_Data/AltiumLibs/TMS-107-01-L-S.stp

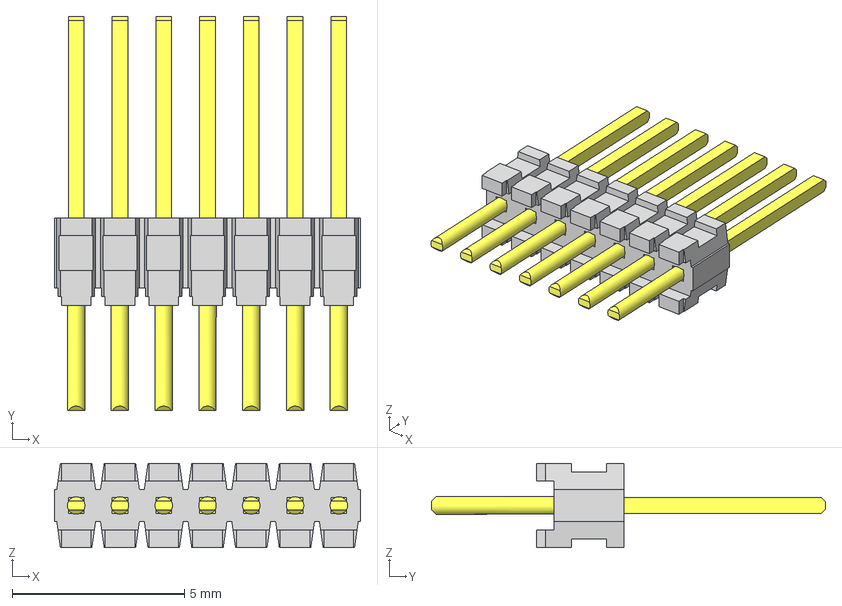
[picture p91: CAD file, 2023-08-17]
AltiumLibs/TMS-107-01-L-S.stp
8.89 x 11.4 x 2.44 mm
T-1M6-07-01-S
TMS-107-S_header
