Drident/High_Speed_Data/AltiumLibs/FTSH-107-01-S-D-K.stp

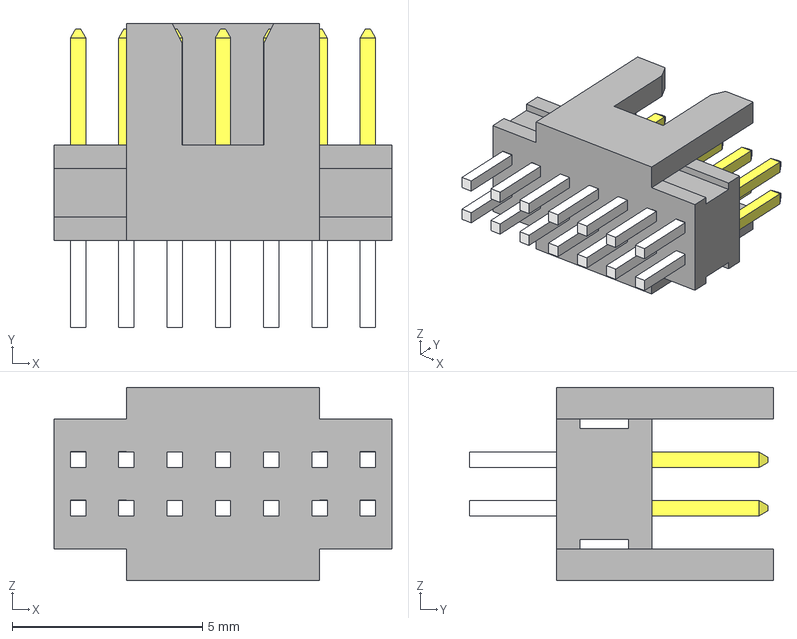
[picture p92: CAD file, 2023-08-17]
AltiumLibs/FTSH-107-01-S-D-K.stp
8.89 x 8.00 x 5.08 mm
FTSH-107-01-S-D-K_pins2
FTSH-107-01-S-D-K_pins1
FTSH-107-01-S-D-K_body
