Drident/High_Speed_Data/AltiumLibs/ELN1_diffamp_MAT14.step

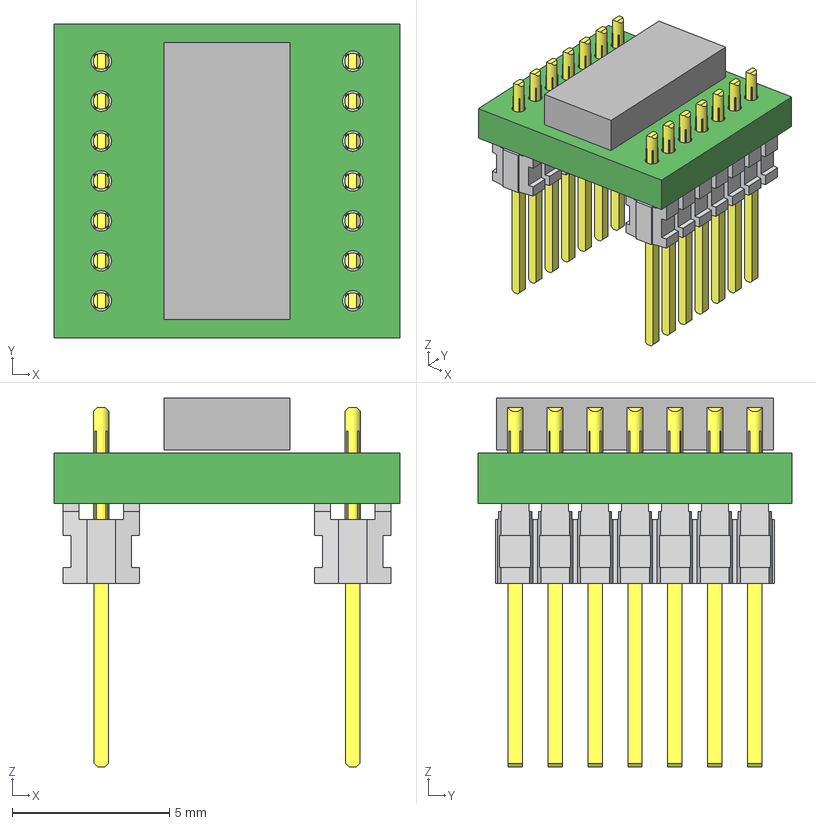
[picture p93: CAD file, 2023-08-17]
AltiumLibs/ELN1_diffamp_MAT14.step
11.0 x 10.0 x 11.7 mm
Extruded x 15
T-1M6-07-01-S x 2
TMS-107-S_header x 2
