Drident/High_Speed_Data/AltiumLibs/SLM-107-01-G-S.stp

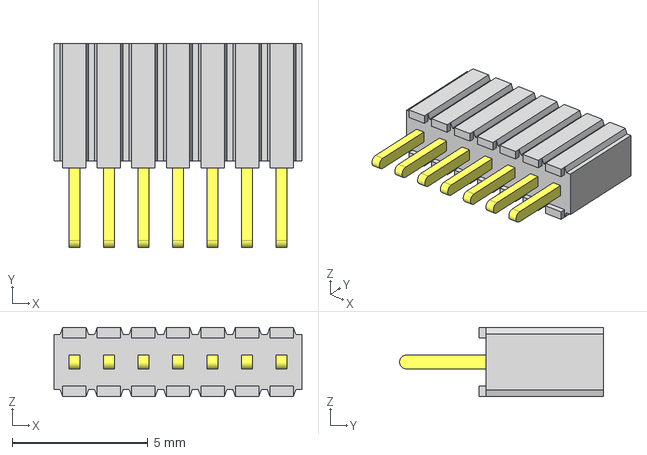
[picture p94: CAD file, 2023-08-17]
AltiumLibs/SLM-107-01-G-S.stp
9.12 x 7.49 x 2.54 mm
C-29-01-07-S
SLM-107-01-S_socket
