Drident/High_Speed_Data/AltiumLibs/10078991-Gx2-08.stp

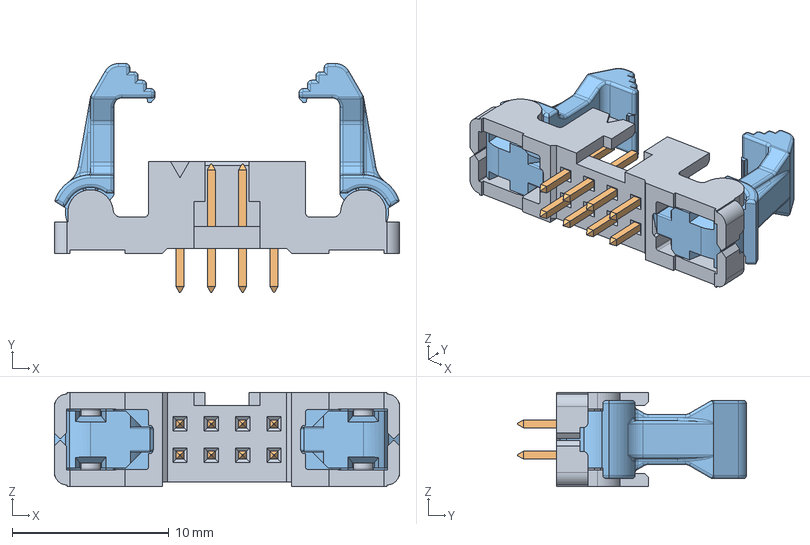
[picture p95: CAD file, 2023-08-17]
AltiumLibs/10078991-Gx2-08.stp
22.0 x 14.6 x 6.00 mm
CONTACT-HEADER_TMT x 8
