Drident/High_Speed_Data/AltiumLibs/89947-708LFc.stp

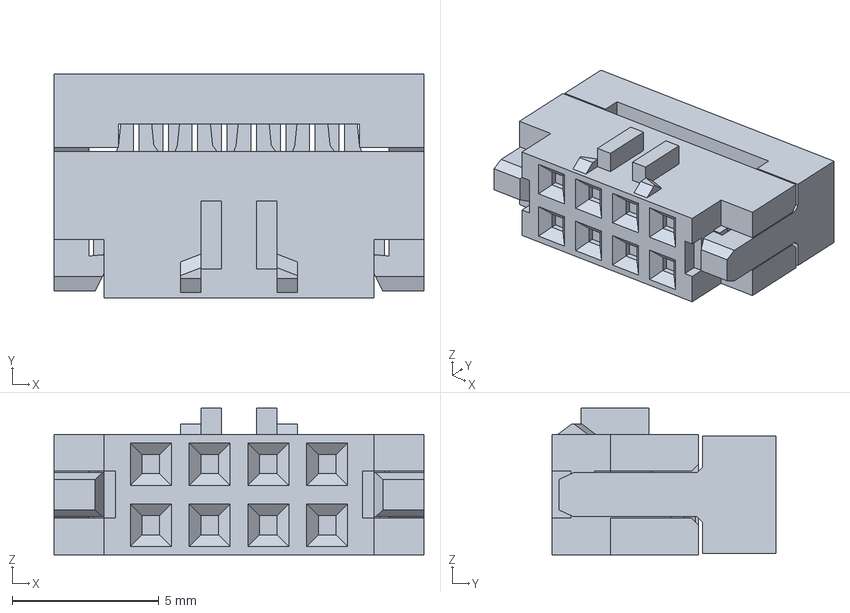
[picture p96: CAD file, 2023-08-17]
AltiumLibs/89947-708LFc.stp
12.6 x 7.64 x 5.00 mm
