Drident/High_Speed_Data/AltiumLibs/s98414-x06-08LF.stp

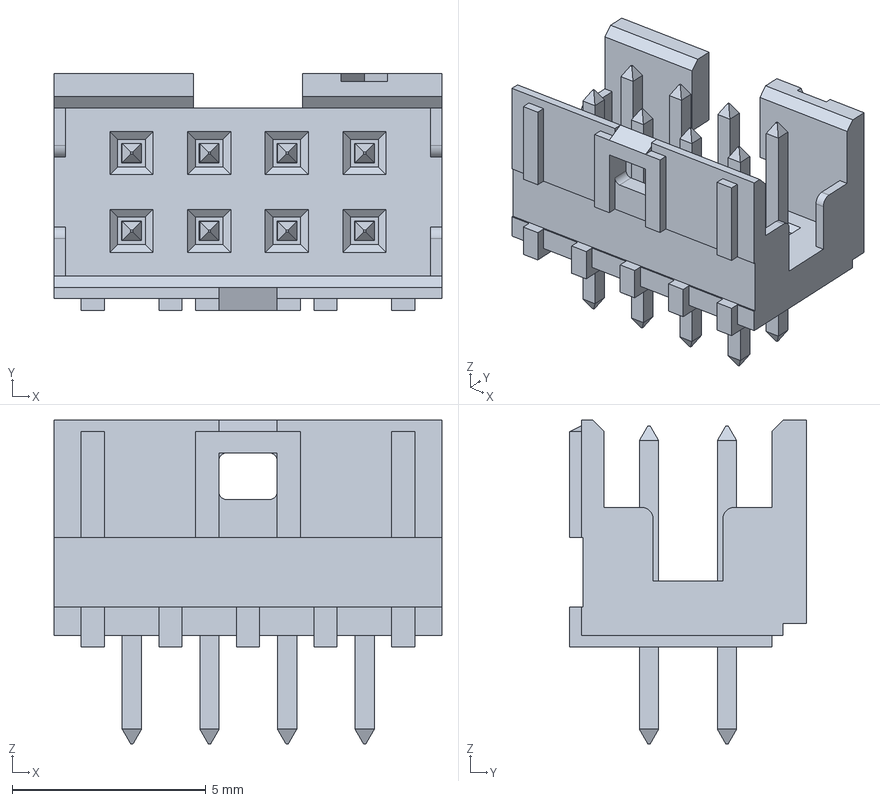
[picture p97: CAD file, 2023-08-17]
AltiumLibs/s98414-x06-08LF.stp
10.0 x 6.10 x 8.35 mm
