Drident/High_Speed_Data/lattice_userGuide/lien_user_guide.txt

file:///C:/lscc/Programmer/diamond/3.12/docs/webhelp/eng/index.htm#page/Programmer/Device%20Programming/programming_a_device_using_the_programmer.htm#ww1752017
cf : voir rapport
