Drident/High_Speed_Data/Bachelor/Board/icecube2/test/test_Implmnt/synlog/report/test_compiler_warnings.txt

@W: CD266 :"C:\Users\christop.grobety\Bachelor\Bachelor\Board\concat\bachelor.vhd":570:47:570:50|done is not readable.  This may cause a simulation mismatch.
@W: CD266 :"C:\Users\christop.grobety\Bachelor\Bachelor\Board\concat\bachelor.vhd":574:12:574:15|done is not readable.  This may cause a simulation mismatch.
@W: CD266 :"C:\Users\christop.grobety\Bachelor\Bachelor\Board\concat\bachelor.vhd":1229:23:1229:30|count_go is not readable.  This may cause a simulation mismatch.
@W: CD266 :"C:\Users\christop.grobety\Bachelor\Bachelor\Board\concat\bachelor.vhd":1233:8:1233:16|adc_clock is not readable.  This may cause a simulation mismatch.
@W: CL167 :"C:\Users\christop.grobety\Bachelor\Bachelor\Board\concat\bachelor.vhd":1719:2:1719:7|Input dout1 of instance ODInst is floating
@W: CL190 :"C:\Users\christop.grobety\Bachelor\Bachelor\Board\concat\bachelor.vhd":647:4:647:5|Optimizing register bit count(0) to a constant 0. To keep the instance, apply constraint syn_preserve=1 on the instance.
@W: CL169 :"C:\Users\christop.grobety\Bachelor\Bachelor\Board\concat\bachelor.vhd":647:4:647:5|Pruning unused register count(0). Make sure that there are no unused intermediate registers.
@W: CG296 :"C:\Users\christop.grobety\Bachelor\Bachelor\Board\concat\bachelor.vhd":850:11:850:17|Incomplete sensitivity list; assuming completeness. Make sure all referenced variables in message CG290 are included in the sensitivity list.
@W: CG290 :"C:\Users\christop.grobety\Bachelor\Bachelor\Board\concat\bachelor.vhd":855:17:855:22|Referenced variable stmclk is not in sensitivity list.
@W: CD638 :"C:\Users\christop.grobety\Bachelor\Bachelor\Board\concat\bachelor.vhd":848:8:848:15|Signal done_int is undriven. Either assign the signal a value or remove the signal declaration.
@W: CL169 :"C:\Users\christop.grobety\Bachelor\Bachelor\Board\concat\bachelor.vhd":852:2:852:3|Pruning unused register count_2(18 downto 0). Make sure that there are no unused intermediate registers.
@W: CL169 :"C:\Users\christop.grobety\Bachelor\Bachelor\Board\concat\bachelor.vhd":852:2:852:3|Pruning unused register start_bit_2. Make sure that there are no unused intermediate registers.
@W: CG296 :"C:\Users\christop.grobety\Bachelor\Bachelor\Board\concat\bachelor.vhd":586:11:586:17|Incomplete sensitivity list; assuming completeness. Make sure all referenced variables in message CG290 are included in the sensitivity list.
@W: CG290 :"C:\Users\christop.grobety\Bachelor\Bachelor\Board\concat\bachelor.vhd":591:45:591:55|Referenced variable pretriggval is not in sensitivity list.
@W: CG290 :"C:\Users\christop.grobety\Bachelor\Bachelor\Board\concat\bachelor.vhd":590:32:590:41|Referenced variable memorytrig is not in sensitivity list.
@W: CL117 :"C:\Users\christop.grobety\Bachelor\Bachelor\Board\concat\bachelor.vhd":588:4:588:5|Latch generated from process for signal Trigg_in; possible missing assignment in an if or case statement.
@W: CL117 :"C:\Users\christop.grobety\Bachelor\Bachelor\Board\concat\bachelor.vhd":588:4:588:5|Latch generated from process for signal memoryTrigTest(18 downto 0); possible missing assignment in an if or case statement.
@W: CL111 :"C:\Users\christop.grobety\Bachelor\Bachelor\Board\concat\bachelor.vhd":554:4:554:5|All reachable assignments to memoryTrig(0) are '1'; removing register. To preserve a constant register, use the syn_preserve attribute.
@W: CL111 :"C:\Users\christop.grobety\Bachelor\Bachelor\Board\concat\bachelor.vhd":554:4:554:5|All reachable assignments to memoryTrig(1) are '1'; removing register. To preserve a constant register, use the syn_preserve attribute.
@W: CL111 :"C:\Users\christop.grobety\Bachelor\Bachelor\Board\concat\bachelor.vhd":554:4:554:5|All reachable assignments to memoryTrig(2) are '1'; removing register. To preserve a constant register, use the syn_preserve attribute.
@W: CL111 :"C:\Users\christop.grobety\Bachelor\Bachelor\Board\concat\bachelor.vhd":554:4:554:5|All reachable assignments to memoryTrig(3) are '1'; removing register. To preserve a constant register, use the syn_preserve attribute.
@W: CL111 :"C:\Users\christop.grobety\Bachelor\Bachelor\Board\concat\bachelor.vhd":554:4:554:5|All reachable assignments to memoryTrig(4) are '1'; removing register. To preserve a constant register, use the syn_preserve attribute.
@W: CL111 :"C:\Users\christop.grobety\Bachelor\Bachelor\Board\concat\bachelor.vhd":554:4:554:5|All reachable assignments to memoryTrig(5) are '1'; removing register. To preserve a constant register, use the syn_preserve attribute.
@W: CL111 :"C:\Users\christop.grobety\Bachelor\Bachelor\Board\concat\bachelor.vhd":554:4:554:5|All reachable assignments to memoryTrig(6) are '1'; removing register. To preserve a constant register, use the syn_preserve attribute.
@W: CL111 :"C:\Users\christop.grobety\Bachelor\Bachelor\Board\concat\bachelor.vhd":554:4:554:5|All reachable assignments to memoryTrig(7) are '1'; removing register. To preserve a constant register, use the syn_preserve attribute.
@W: CL111 :"C:\Users\christop.grobety\Bachelor\Bachelor\Board\concat\bachelor.vhd":554:4:554:5|All reachable assignments to memoryTrig(8) are '1'; removing register. To preserve a constant register, use the syn_preserve attribute.
@W: CL111 :"C:\Users\christop.grobety\Bachelor\Bachelor\Board\concat\bachelor.vhd":554:4:554:5|All reachable assignments to memoryTrig(9) are '1'; removing register. To preserve a constant register, use the syn_preserve attribute.
@W: CL111 :"C:\Users\christop.grobety\Bachelor\Bachelor\Board\concat\bachelor.vhd":554:4:554:5|All reachable assignments to memoryTrig(10) are '1'; removing register. To preserve a constant register, use the syn_preserve attribute.
@W: CL111 :"C:\Users\christop.grobety\Bachelor\Bachelor\Board\concat\bachelor.vhd":554:4:554:5|All reachable assignments to memoryTrig(11) are '1'; removing register. To preserve a constant register, use the syn_preserve attribute.
@W: CL111 :"C:\Users\christop.grobety\Bachelor\Bachelor\Board\concat\bachelor.vhd":554:4:554:5|All reachable assignments to memoryTrig(12) are '1'; removing register. To preserve a constant register, use the syn_preserve attribute.
@W: CL111 :"C:\Users\christop.grobety\Bachelor\Bachelor\Board\concat\bachelor.vhd":554:4:554:5|All reachable assignments to memoryTrig(13) are '1'; removing register. To preserve a constant register, use the syn_preserve attribute.
@W: CL111 :"C:\Users\christop.grobety\Bachelor\Bachelor\Board\concat\bachelor.vhd":554:4:554:5|All reachable assignments to memoryTrig(14) are '1'; removing register. To preserve a constant register, use the syn_preserve attribute.
@W: CL111 :"C:\Users\christop.grobety\Bachelor\Bachelor\Board\concat\bachelor.vhd":554:4:554:5|All reachable assignments to memoryTrig(15) are '1'; removing register. To preserve a constant register, use the syn_preserve attribute.
@W: CL111 :"C:\Users\christop.grobety\Bachelor\Bachelor\Board\concat\bachelor.vhd":554:4:554:5|All reachable assignments to memoryTrig(16) are '1'; removing register. To preserve a constant register, use the syn_preserve attribute.
@W: CL111 :"C:\Users\christop.grobety\Bachelor\Bachelor\Board\concat\bachelor.vhd":554:4:554:5|All reachable assignments to memoryTrig(17) are '1'; removing register. To preserve a constant register, use the syn_preserve attribute.
@W: CL111 :"C:\Users\christop.grobety\Bachelor\Bachelor\Board\concat\bachelor.vhd":554:4:554:5|All reachable assignments to memoryTrig(18) are '1'; removing register. To preserve a constant register, use the syn_preserve attribute.
@W: CG296 :"C:\Users\christop.grobety\Bachelor\Bachelor\Board\concat\bachelor.vhd":768:20:768:26|Incomplete sensitivity list; assuming completeness. Make sure all referenced variables in message CG290 are included in the sensitivity list.
@W: CG290 :"C:\Users\christop.grobety\Bachelor\Bachelor\Board\concat\bachelor.vhd":773:20:773:25|Referenced variable stmclk is not in sensitivity list.
@W: CD638 :"C:\Users\christop.grobety\Bachelor\Bachelor\Board\concat\bachelor.vhd":765:9:765:20|Signal valuepretrig is undriven. Either assign the signal a value or remove the signal declaration.
@W: CL169 :"C:\Users\christop.grobety\Bachelor\Bachelor\Board\concat\bachelor.vhd":770:4:770:5|Pruning unused register count_pre_2(3 downto 0). Make sure that there are no unused intermediate registers.
@W: CG296 :"C:\Users\christop.grobety\Bachelor\Bachelor\Board\concat\bachelor.vhd":1076:6:1076:12|Incomplete sensitivity list; assuming completeness. Make sure all referenced variables in message CG290 are included in the sensitivity list.
@W: CG290 :"C:\Users\christop.grobety\Bachelor\Bachelor\Board\concat\bachelor.vhd":1104:16:1104:26|Referenced variable af_fram_sdi is not in sensitivity list.
@W: CG290 :"C:\Users\christop.grobety\Bachelor\Bachelor\Board\concat\bachelor.vhd":1124:17:1124:27|Referenced variable fw_fram_sdi is not in sensitivity list.
@W: CG290 :"C:\Users\christop.grobety\Bachelor\Bachelor\Board\concat\bachelor.vhd":1103:14:1103:21|Referenced variable af_ncs_f is not in sensitivity list.
@W: CL117 :"C:\Users\christop.grobety\Bachelor\Bachelor\Board\concat\bachelor.vhd":1080:2:1080:5|Latch generated from process for signal FRAM_SDI(3 downto 0); possible missing assignment in an if or case statement.
@W: CL117 :"C:\Users\christop.grobety\Bachelor\Bachelor\Board\concat\bachelor.vhd":1080:2:1080:5|Latch generated from process for signal ADC_CLOCK; possible missing assignment in an if or case statement.
@W: CL117 :"C:\Users\christop.grobety\Bachelor\Bachelor\Board\concat\bachelor.vhd":1080:2:1080:5|Latch generated from process for signal FR_NCS(3 downto 0); possible missing assignment in an if or case statement.
@W: CG296 :"C:\Users\christop.grobety\Bachelor\Bachelor\Board\concat\bachelor.vhd":1000:14:1000:20|Incomplete sensitivity list; assuming completeness. Make sure all referenced variables in message CG290 are included in the sensitivity list.
@W: CG290 :"C:\Users\christop.grobety\Bachelor\Bachelor\Board\concat\bachelor.vhd":1002:15:1002:15|Referenced variable m is not in sensitivity list.
@W: CD638 :"C:\Users\christop.grobety\Bachelor\Bachelor\Board\concat\bachelor.vhd":967:8:967:9|Signal go is undriven. Either assign the signal a value or remove the signal declaration.
@W: CD638 :"C:\Users\christop.grobety\Bachelor\Bachelor\Board\concat\bachelor.vhd":968:8:968:12|Signal count is undriven. Either assign the signal a value or remove the signal declaration.
@W: CD638 :"C:\Users\christop.grobety\Bachelor\Bachelor\Board\concat\bachelor.vhd":969:8:969:17|Signal countvalue is undriven. Either assign the signal a value or remove the signal declaration.
@W: CL117 :"C:\Users\christop.grobety\Bachelor\Bachelor\Board\concat\bachelor.vhd":976:4:976:5|Latch generated from process for signal SDI(2); possible missing assignment in an if or case statement.
@W: CL117 :"C:\Users\christop.grobety\Bachelor\Bachelor\Board\concat\bachelor.vhd":976:4:976:5|Latch generated from process for signal SDI(1); possible missing assignment in an if or case statement.
@W: CL117 :"C:\Users\christop.grobety\Bachelor\Bachelor\Board\concat\bachelor.vhd":976:4:976:5|Latch generated from process for signal SDI(0); possible missing assignment in an if or case statement.
@W: CL117 :"C:\Users\christop.grobety\Bachelor\Bachelor\Board\concat\bachelor.vhd":976:4:976:5|Latch generated from process for signal SDI(3); possible missing assignment in an if or case statement.
@W: CL117 :"C:\Users\christop.grobety\Bachelor\Bachelor\Board\concat\bachelor.vhd":976:4:976:5|Latch generated from process for signal NCs(3 downto 0); possible missing assignment in an if or case statement.
@W: CD434 :"C:\Users\christop.grobety\Bachelor\Bachelor\Board\concat\bachelor.vhd":283:19:283:21|Signal sdo in the sensitivity list is not used in the process. Make sure all variables in the sensitivity list are referenced in the process.
@W: CG296 :"C:\Users\christop.grobety\Bachelor\Bachelor\Board\concat\bachelor.vhd":294:14:294:20|Incomplete sensitivity list; assuming completeness. Make sure all referenced variables in message CG290 are included in the sensitivity list.
@W: CG290 :"C:\Users\christop.grobety\Bachelor\Bachelor\Board\concat\bachelor.vhd":296:15:296:15|Referenced variable m is not in sensitivity list.
@W: CD638 :"C:\Users\christop.grobety\Bachelor\Bachelor\Board\concat\bachelor.vhd":277:8:277:12|Signal count is undriven. Either assign the signal a value or remove the signal declaration.
@W: CD638 :"C:\Users\christop.grobety\Bachelor\Bachelor\Board\concat\bachelor.vhd":278:8:278:9|Signal go is undriven. Either assign the signal a value or remove the signal declaration.
@W: CD638 :"C:\Users\christop.grobety\Bachelor\Bachelor\Board\concat\bachelor.vhd":279:8:279:14|Signal miso_in is undriven. Either assign the signal a value or remove the signal declaration.
@W: CD638 :"C:\Users\christop.grobety\Bachelor\Bachelor\Board\concat\bachelor.vhd":281:8:281:14|Signal clockgo is undriven. Either assign the signal a value or remove the signal declaration.
@W: CL240 :"C:\Users\christop.grobety\Bachelor\Bachelor\Board\concat\bachelor.vhd":255:8:255:11|Signal MISO is floating; a simulation mismatch is possible.
@W: CL169 :"C:\Users\christop.grobety\Bachelor\Bachelor\Board\concat\bachelor.vhd":1206:2:1206:3|Pruning unused register done16_1. Make sure that there are no unused intermediate registers.
@W: CL168 :"C:\Users\christop.grobety\Bachelor\Bachelor\Board\concat\bachelor.vhd":1662:4:1662:7|Removing instance U_10 because it does not drive other instances. To preserve this instance, use the syn_noprune synthesis directive.
@W: CL168 :"C:\Users\christop.grobety\Bachelor\Bachelor\Board\concat\bachelor.vhd":1642:4:1642:7|Removing instance U_11 because it does not drive other instances. To preserve this instance, use the syn_noprune synthesis directive.
@W: CL168 :"C:\Users\christop.grobety\Bachelor\Bachelor\Board\concat\bachelor.vhd":2033:4:2033:6|Removing instance U_5 because it does not drive other instances. To preserve this instance, use the syn_noprune synthesis directive.
@W: CL168 :"C:\Users\christop.grobety\Bachelor\Bachelor\Board\concat\bachelor.vhd":2023:4:2023:6|Removing instance U_6 because it does not drive other instances. To preserve this instance, use the syn_noprune synthesis directive.
@W: CL169 :"C:\Users\christop.grobety\Bachelor\Bachelor\Board\concat\bachelor.vhd":1930:6:1930:7|Pruning unused register fpga_miso_in_2. Make sure that there are no unused intermediate registers.
@W: CL279 :"C:\Users\christop.grobety\Bachelor\Bachelor\Board\concat\bachelor.vhd":1206:2:1206:3|Pruning register bits 3 to 1 of fram_clock(3 downto 0). If this is not the intended behavior, drive the inputs with valid values, or inputs from the top level.
@W: CL279 :"C:\Users\christop.grobety\Bachelor\Bachelor\Board\concat\bachelor.vhd":1206:2:1206:3|Pruning register bits 3 to 1 of ncs_fram(3 downto 0). If this is not the intended behavior, drive the inputs with valid values, or inputs from the top level.
@W: CL190 :"C:\Users\christop.grobety\Bachelor\Bachelor\Board\concat\bachelor.vhd":647:4:647:5|Optimizing register bit count(5) to a constant 0. To keep the instance, apply constraint syn_preserve=1 on the instance.
@W: CL260 :"C:\Users\christop.grobety\Bachelor\Bachelor\Board\concat\bachelor.vhd":647:4:647:5|Pruning register bit 5 of count(5 downto 0). If this is not the intended behavior, drive the input with valid values, or an input from the top level.
