Drident/High_Speed_Data/Bachelor/Board/icecube2/test/test_Implmnt/syntmp/test_toc.htm

- test_syn (test_Implmnt)
  - Synthesis -
    - Compiler Report
    - Compiler Constraint Applicator
    - Pre-mapping Report
      - Clock Summary
    - Mapper Report
      - Clock Conversion
      - Timing Report
        - Performance Summary
        - Clock Relationships
        - Interface Information
        - Detailed Report for Clocks
          - Clock: EC5LP|iGCK_clk
            - Starting Points with Worst Slack
            - Ending Points with Worst Slack
            - Worst Path Information
          - Clock: System
            - Starting Points with Worst Slack
            - Ending Points with Worst Slack
            - Worst Path Information
      - Resource Utilization
    - Constraint Checker Report (14:09 28-Jul)
  - Session Log (14:09 28-Jul)
