Drident/High_Speed_Data/DAILY_REPPORT/FPGA/bloc_test.pdf

## Package List

LIBRARY ieee;
USE ieee.std_logic_1164.all; USE ieee.numeric_std.all;
LIBRARY gates;
USE gates.gates.all;

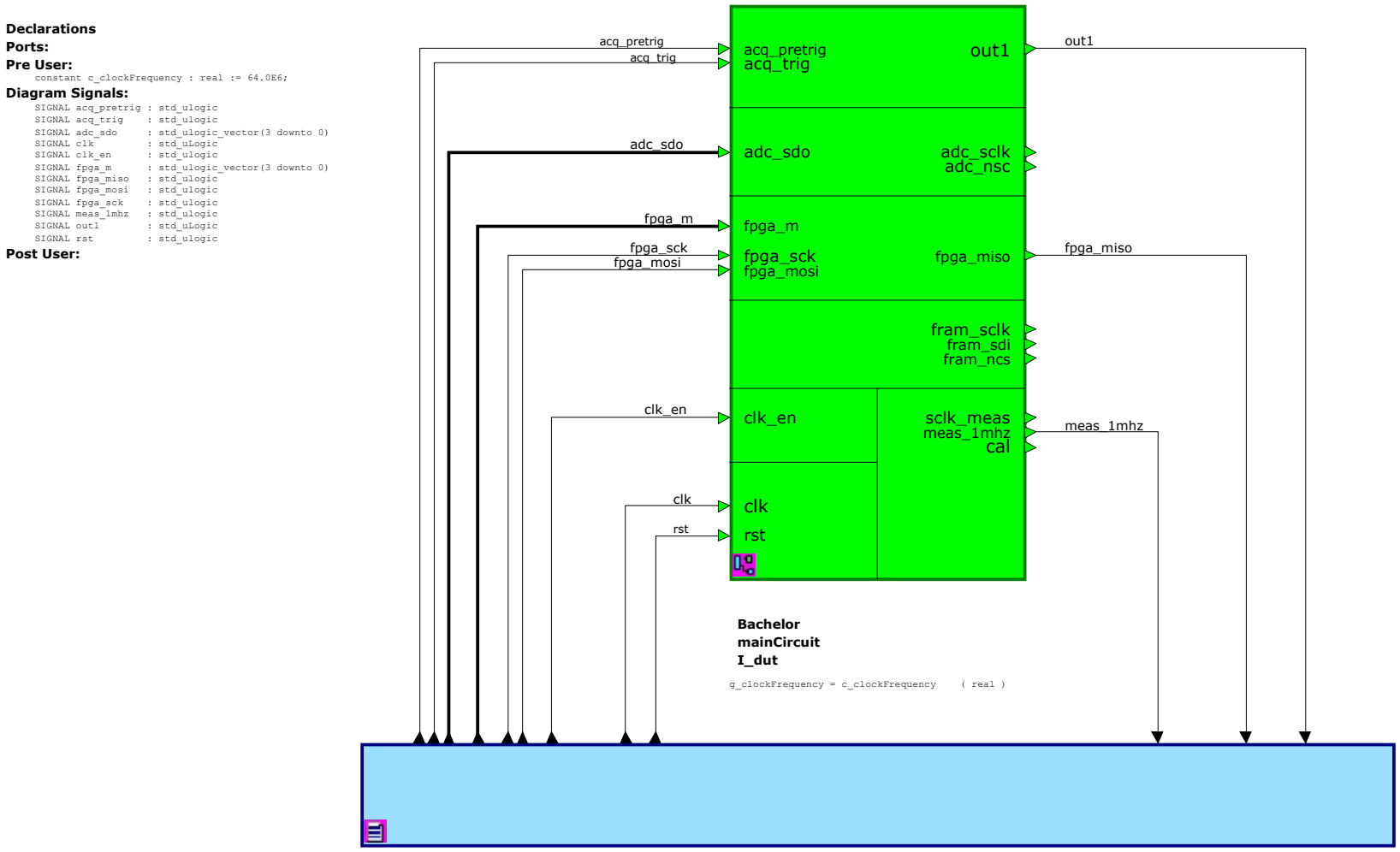
[picture p98: figure]
meas_1mhz; fpga_miso; Declarations Ports: Pre User:; Diagram Signals:; Post User:; SIGNAL rst; : std_ulogic; SIGNAL clk; : std_uLogic; SIGNAL meas_1mhz; SIGNAL clk_en; SIGNAL fpga_mosi; SIGNAL fpga_sck; SIGNAL fpga_m; : std_ulogic_vector(3 downto 0); SIGNAL adc_sdo; SIGNAL acq_trig; SIGNAL acq_pretrig : std_ulogic; SIGNAL fpga_miso; SIGNAL out1; acq_pretrig acq_trig; adc_sdo; fpga_m; fpga_mosi; fpga_sck; adc_nsc; adc_sclk; out1; acq_trig; acq_pretrig; Bachelor mainCircuit I_dut; g_clockFrequency = c_clockFrequency; ( real ); clk; clk_en; cal; fram_ncs; fram_sclk fram_sdi; sclk_meas; rst rst

constant c_clockFrequency : real := 64.0E6;

### Project:

Title: | <enter diagram title here>
Path: | Bachelor_test/mainCircuit_tb/struct
Edited: | by christop.grobety on 13 juin 2023

### <enter comments here>

## hds <company name>

## Bachelor_test mainCircuit_tester I_tester

g_clockFrequency = c_clockFrequency ( real )

## Bachelor_test/mainCircuit_tb/struct

Printed by christop.grobety on 17.08.2023 at 16:08:06 | Page 1 of 1
