Drident/High_Speed_Data/DAILY_REPPORT/FPGA/TEST_1.png

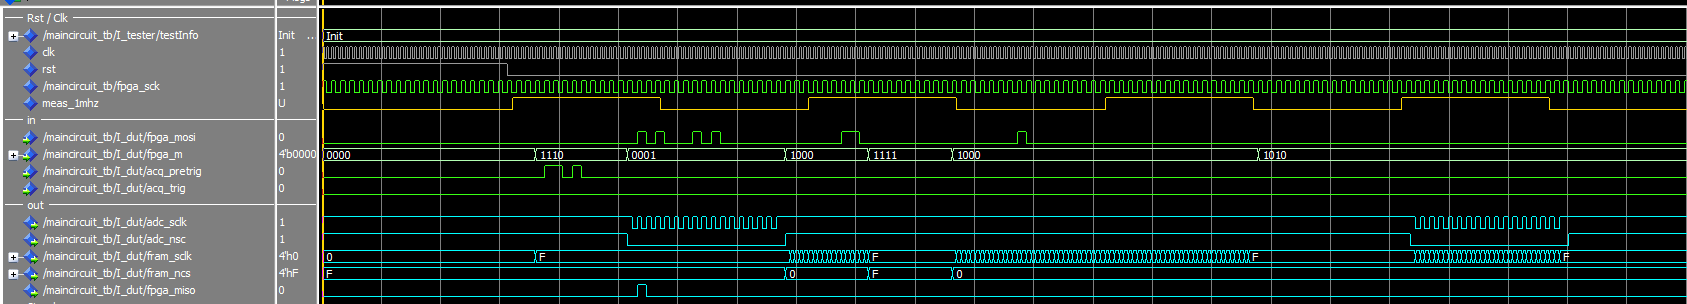
DAILY_REPPORT/FPGA/TEST_1.png
