Drident/High_Speed_Data/DAILY_REPPORT/image_simu_fpga/BLOCK_TEST.png

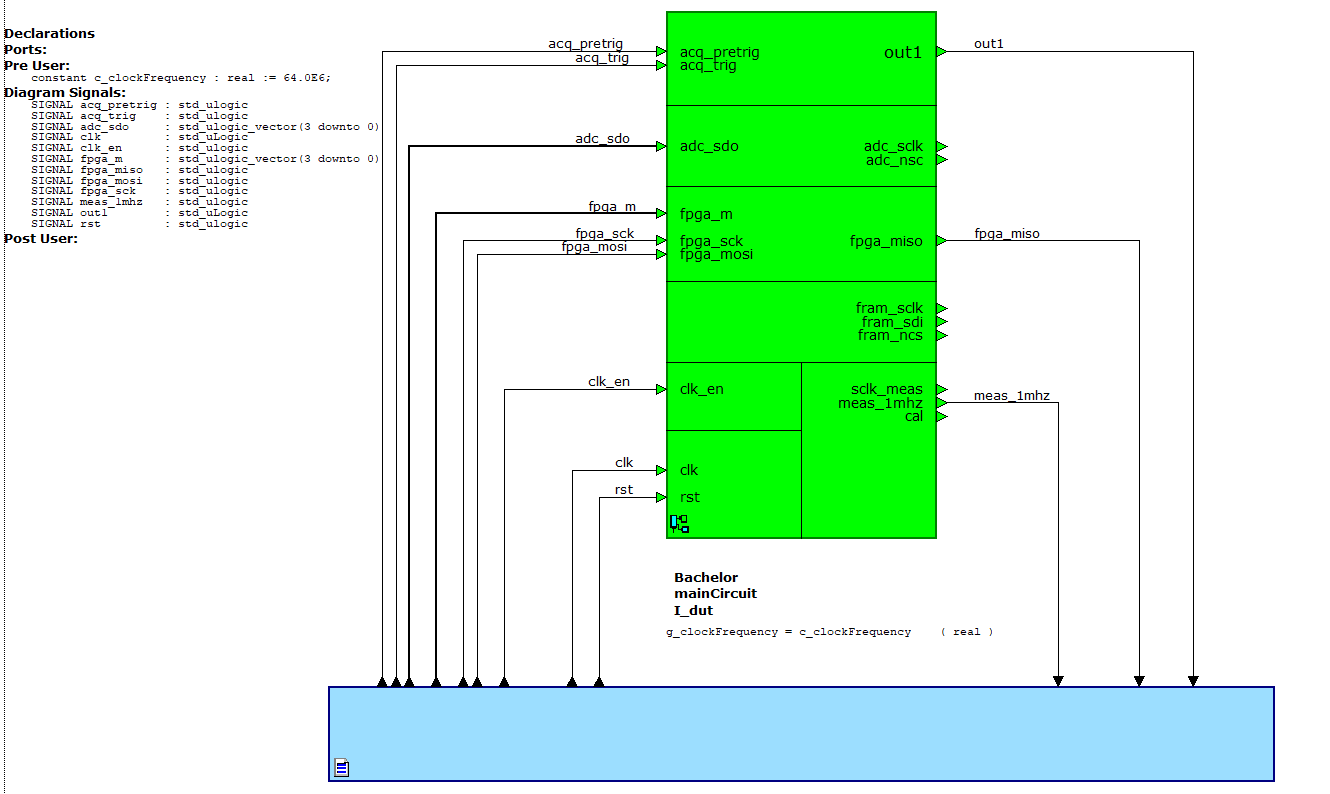
DAILY_REPPORT/image_simu_fpga/BLOCK_TEST.png
