Drident/High_Speed_Data/DAILY_REPPORT/image_simu_fpga/TEST_4.png

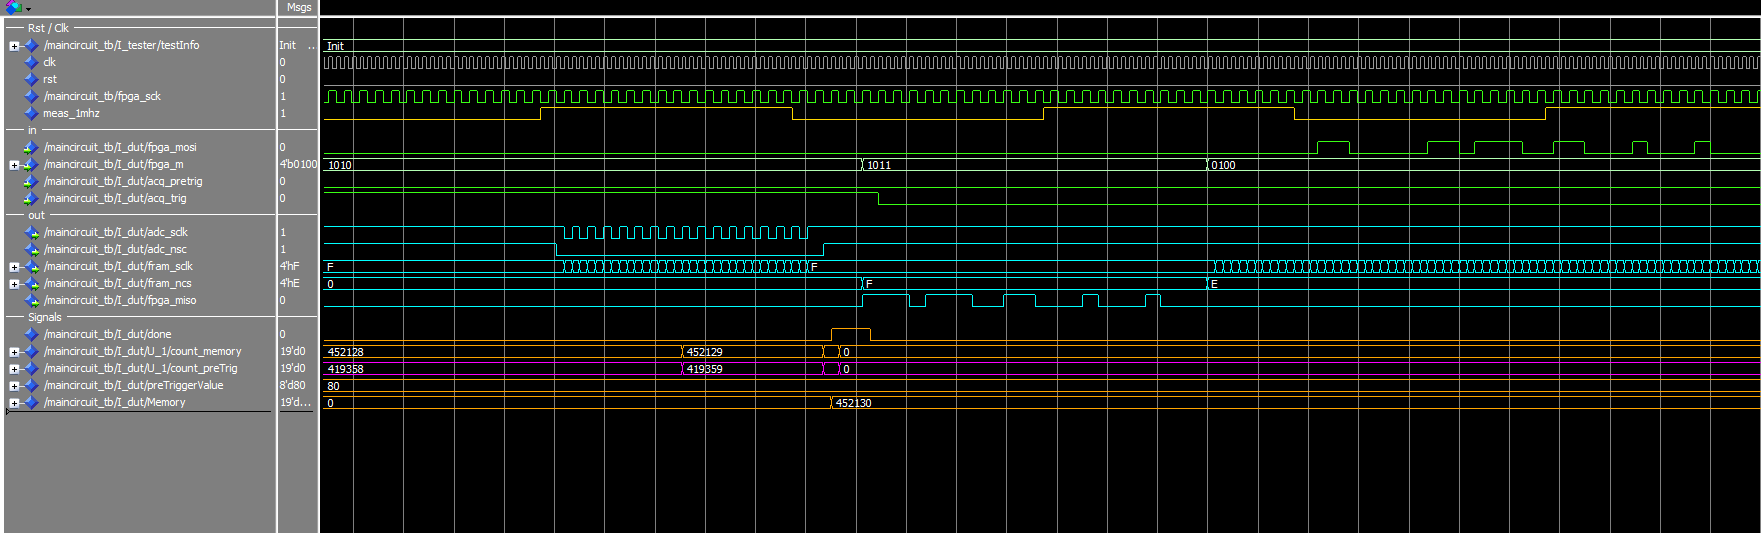
DAILY_REPPORT/image_simu_fpga/TEST_4.png
