Drident/High_Speed_Data/AltiumLibs/shemas.pdf

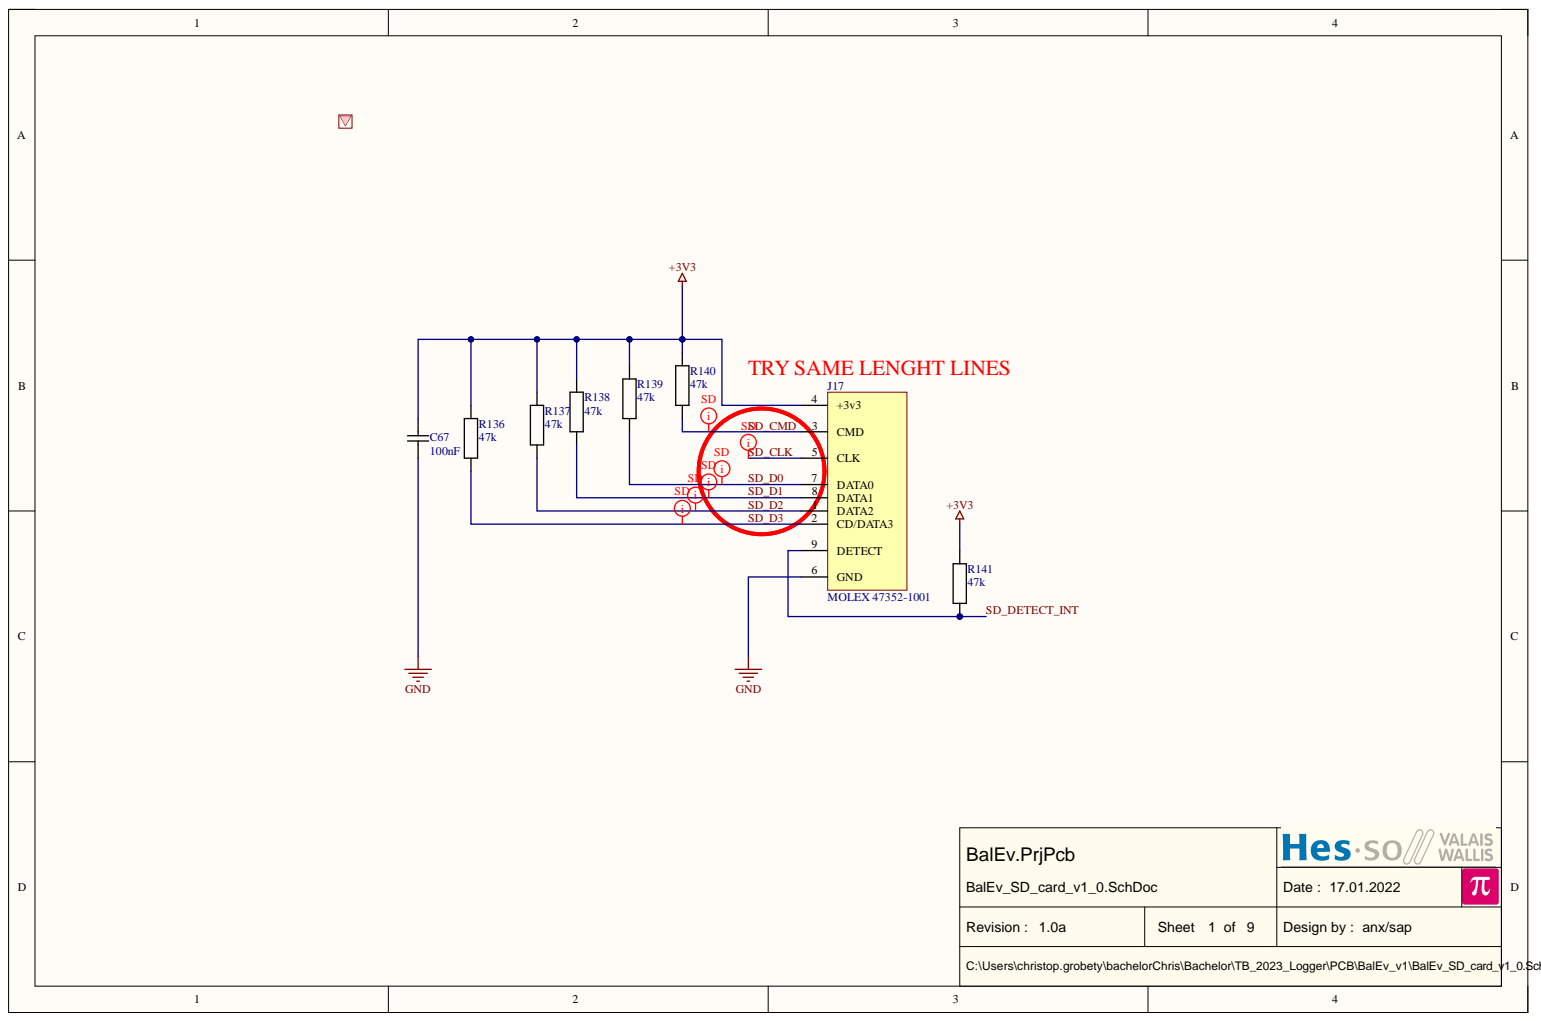
[picture p105: page 1]

SD SD _CM D

SD i | 7
SD | SD _D 0

BalEv.Prj P c b BalEv_SD_card_v1_0.SchDoc

Date : 17.01.2022

Revision : 1.0a | Sheet 1 of 9 | Design by : anx/sap

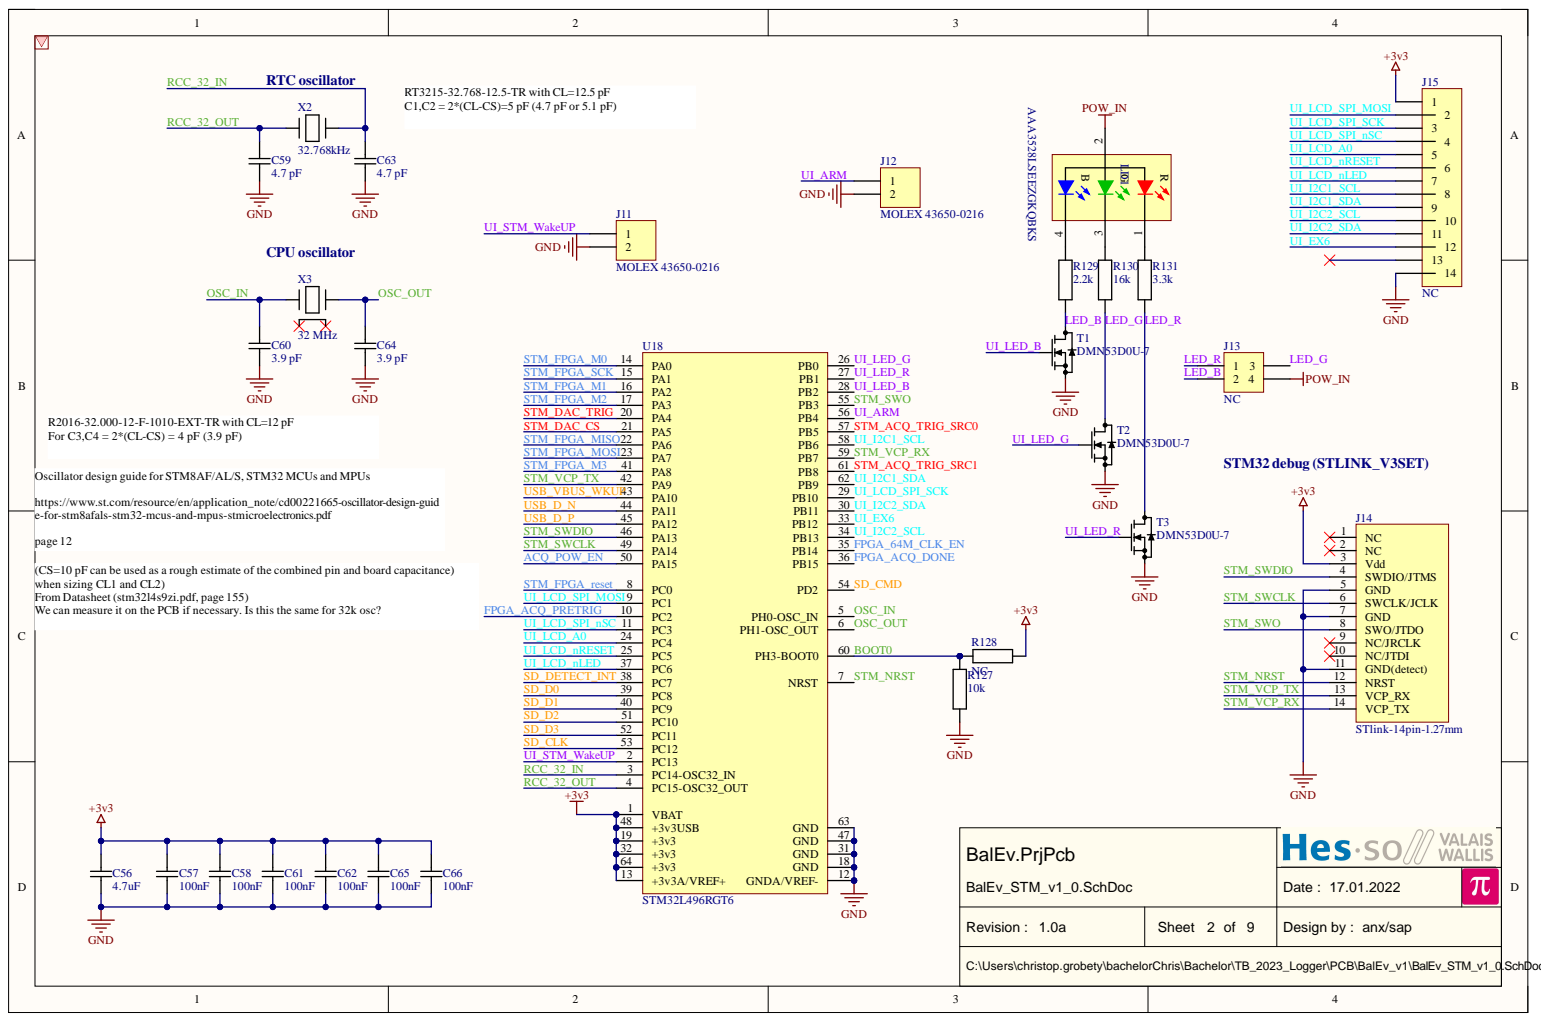
[picture p106: page 2]

3 2 | 3
6 4 | 1 8

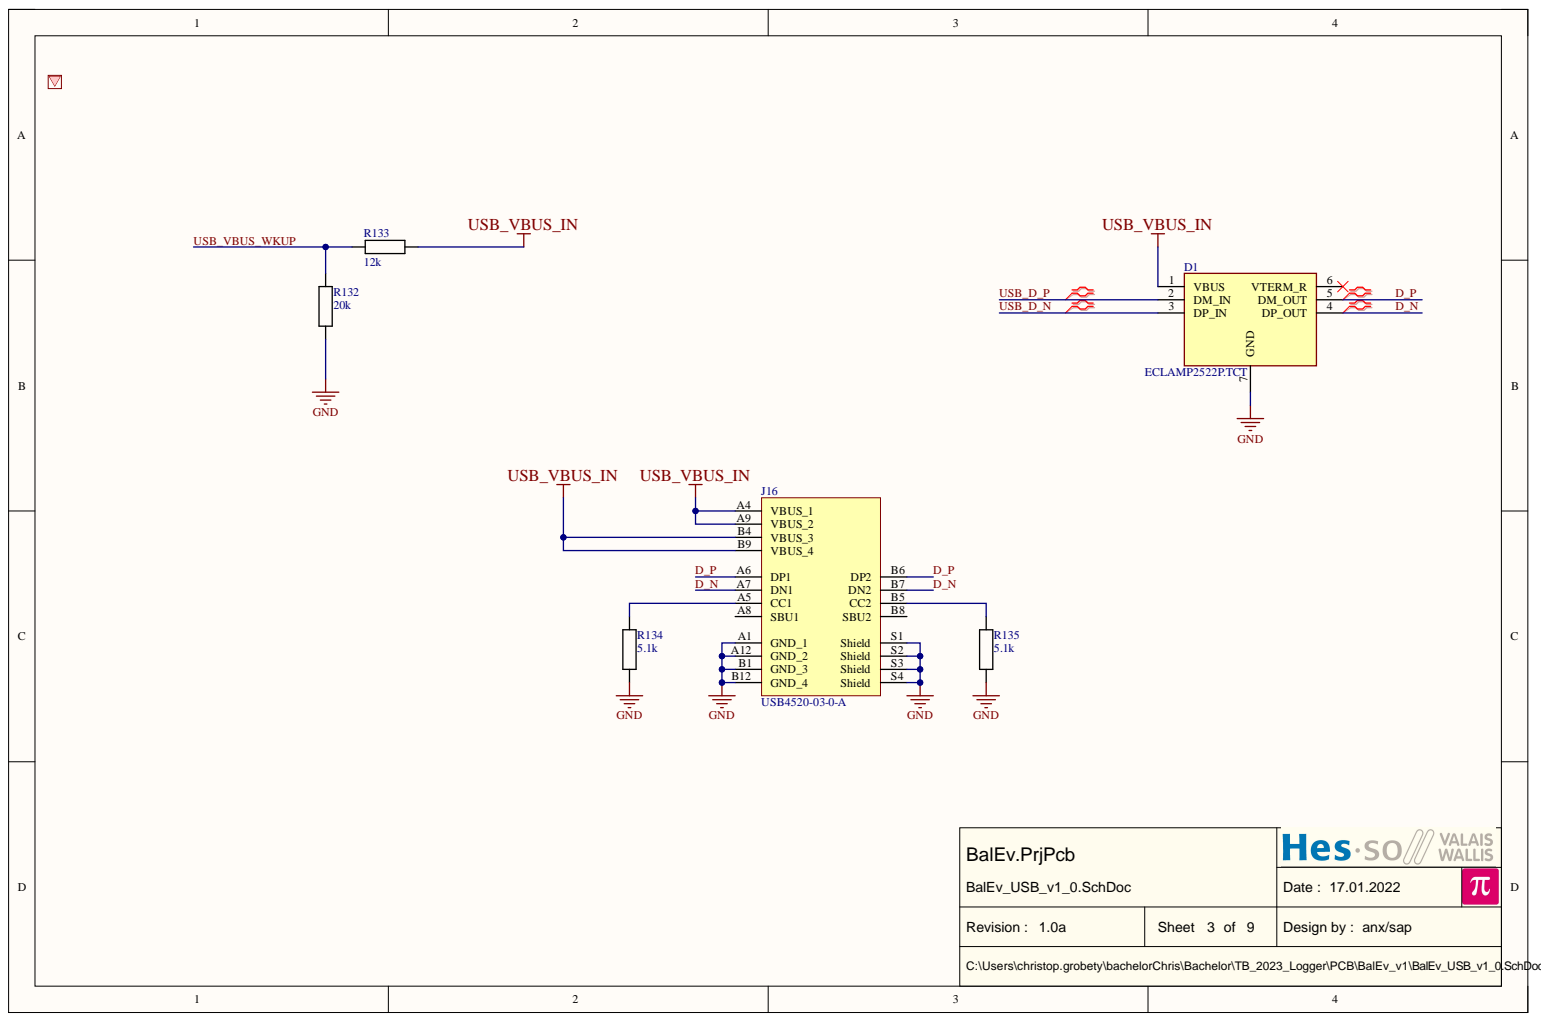
[picture p107: page 3]

BalEv.Prj P c b BalEv_US B_v1_0.SchDoc

Date : 17.01.2022

Revision : 1.0a | Sheet 3 of 9 | Design by : anx/sap

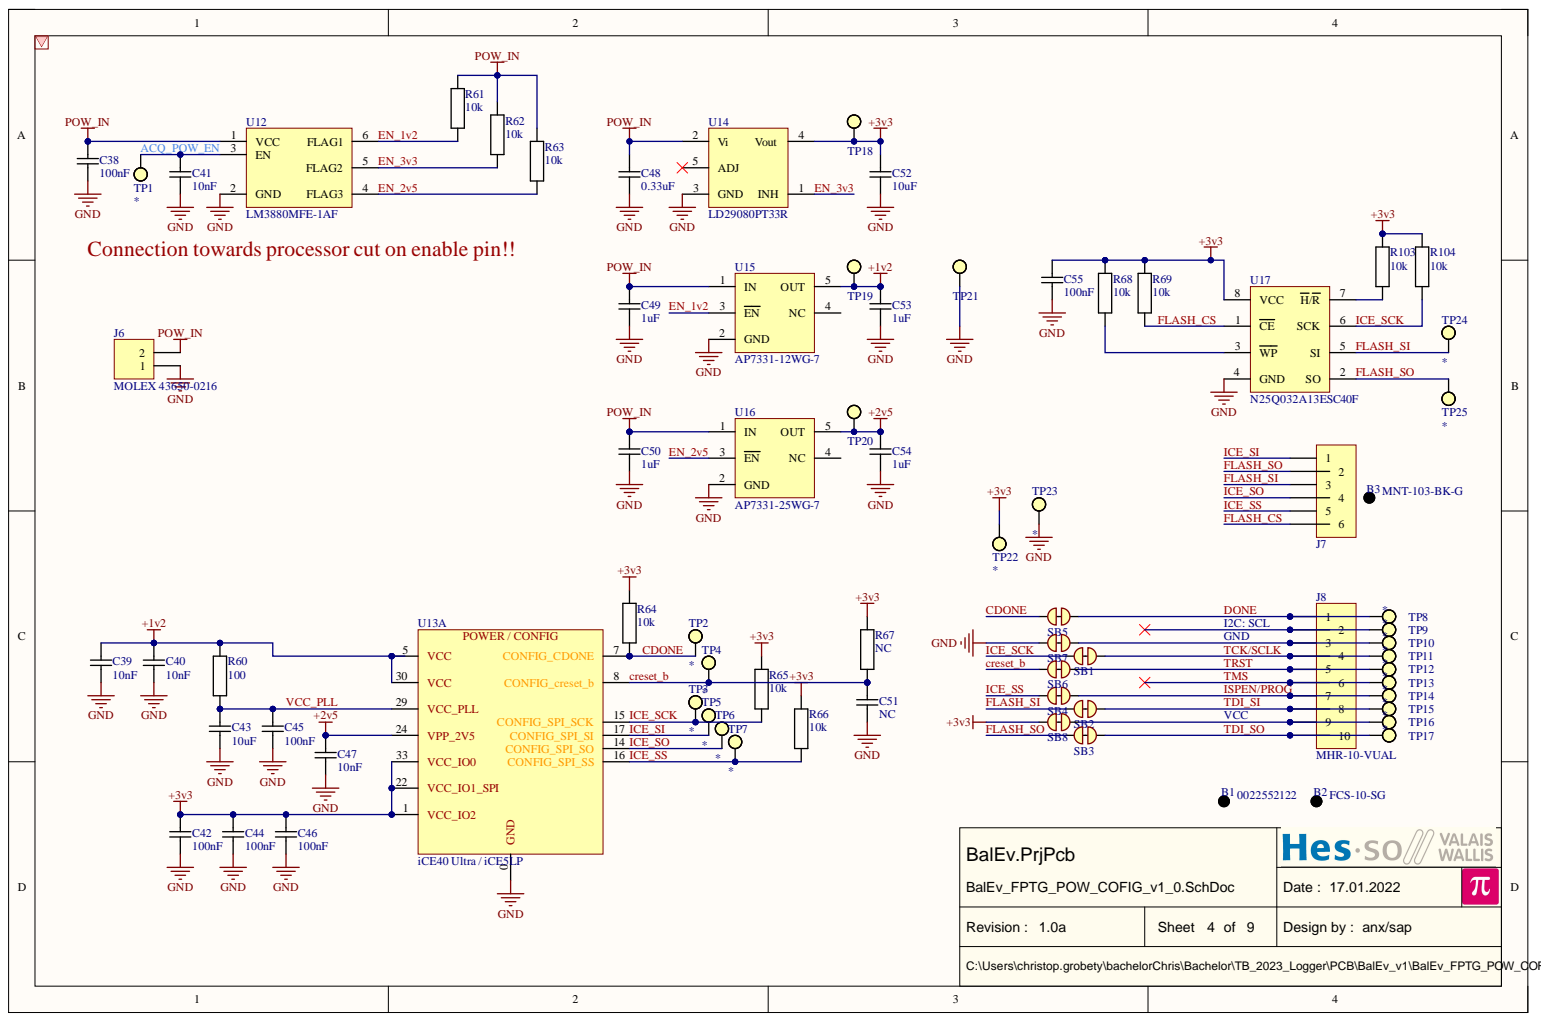
[picture p108: page 4]

GND
Connection towards processor cut on enable pin!!

CE 1 | ICE_SCK

BalEv.PrjPcb BalEv_FPTG_POW_COFIG_v1_0.SchDoc

Date : 17.01.2022

Revision : 1.0a | Sheet 4 of 9 | Design by : anx/sap

C:\Users\christop.grobety\bachelorChris\Bachelor\TB_2023_Logger\PCB\BalEv_v1\BalEv_FPTG_POW_COFIG_v1_0.SchDoc

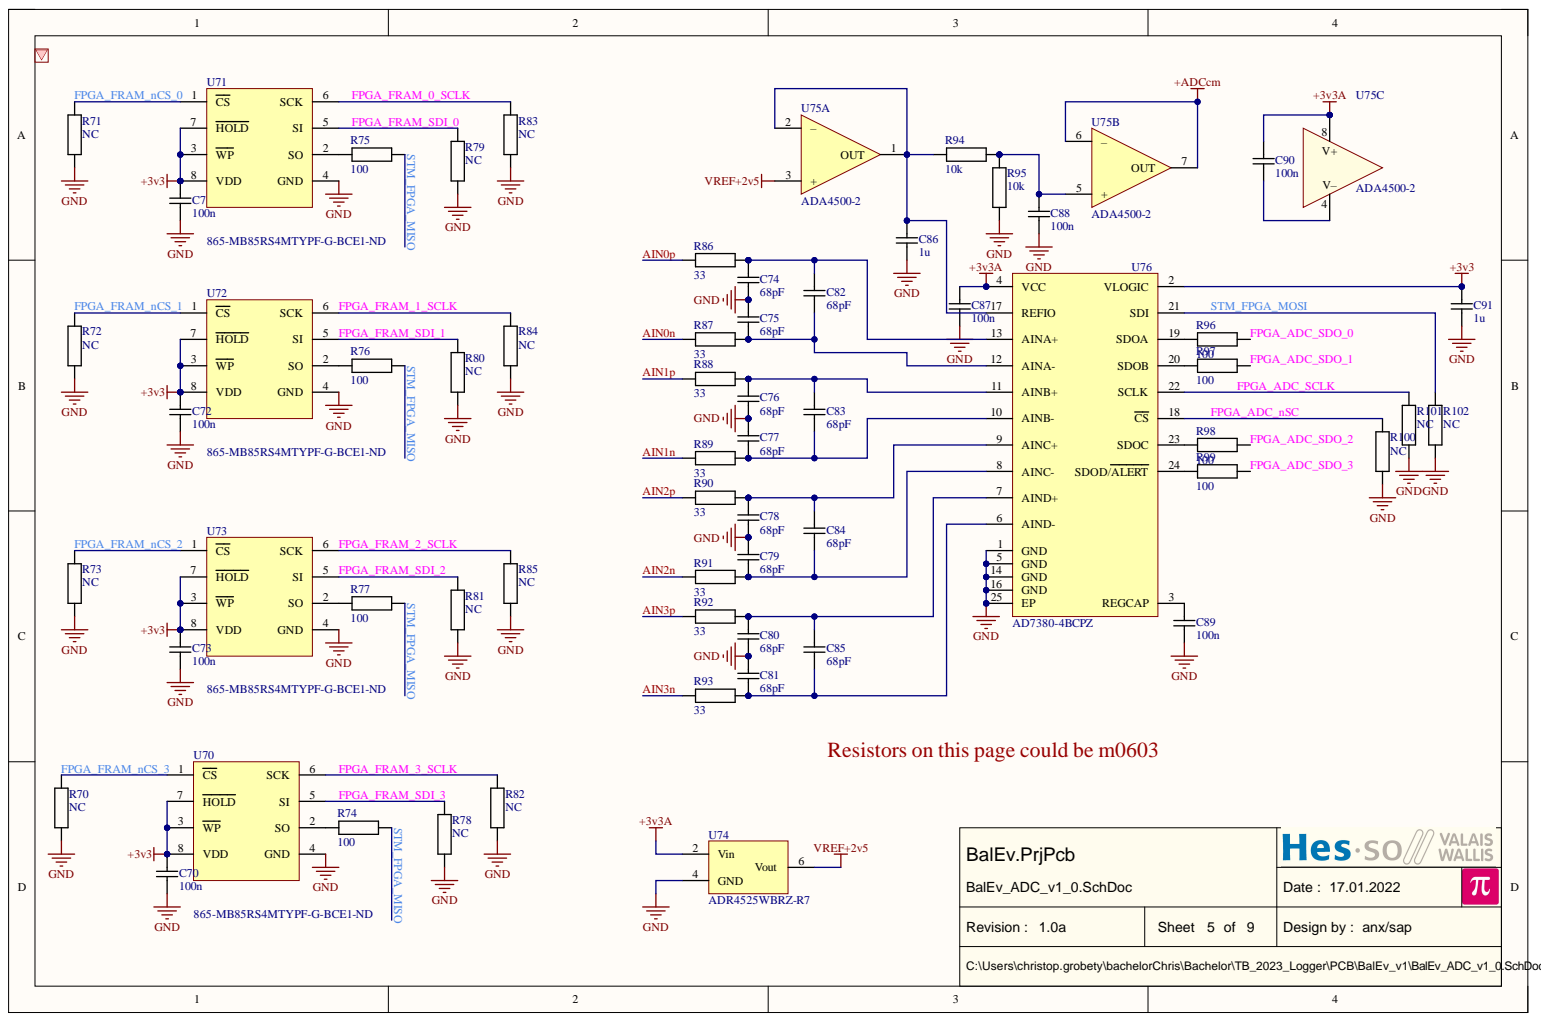
[picture p109: page 5]

Date : 17.01.2022

Revision : 1.0a | Sheet 5 of 9 | Design by : anx/sap

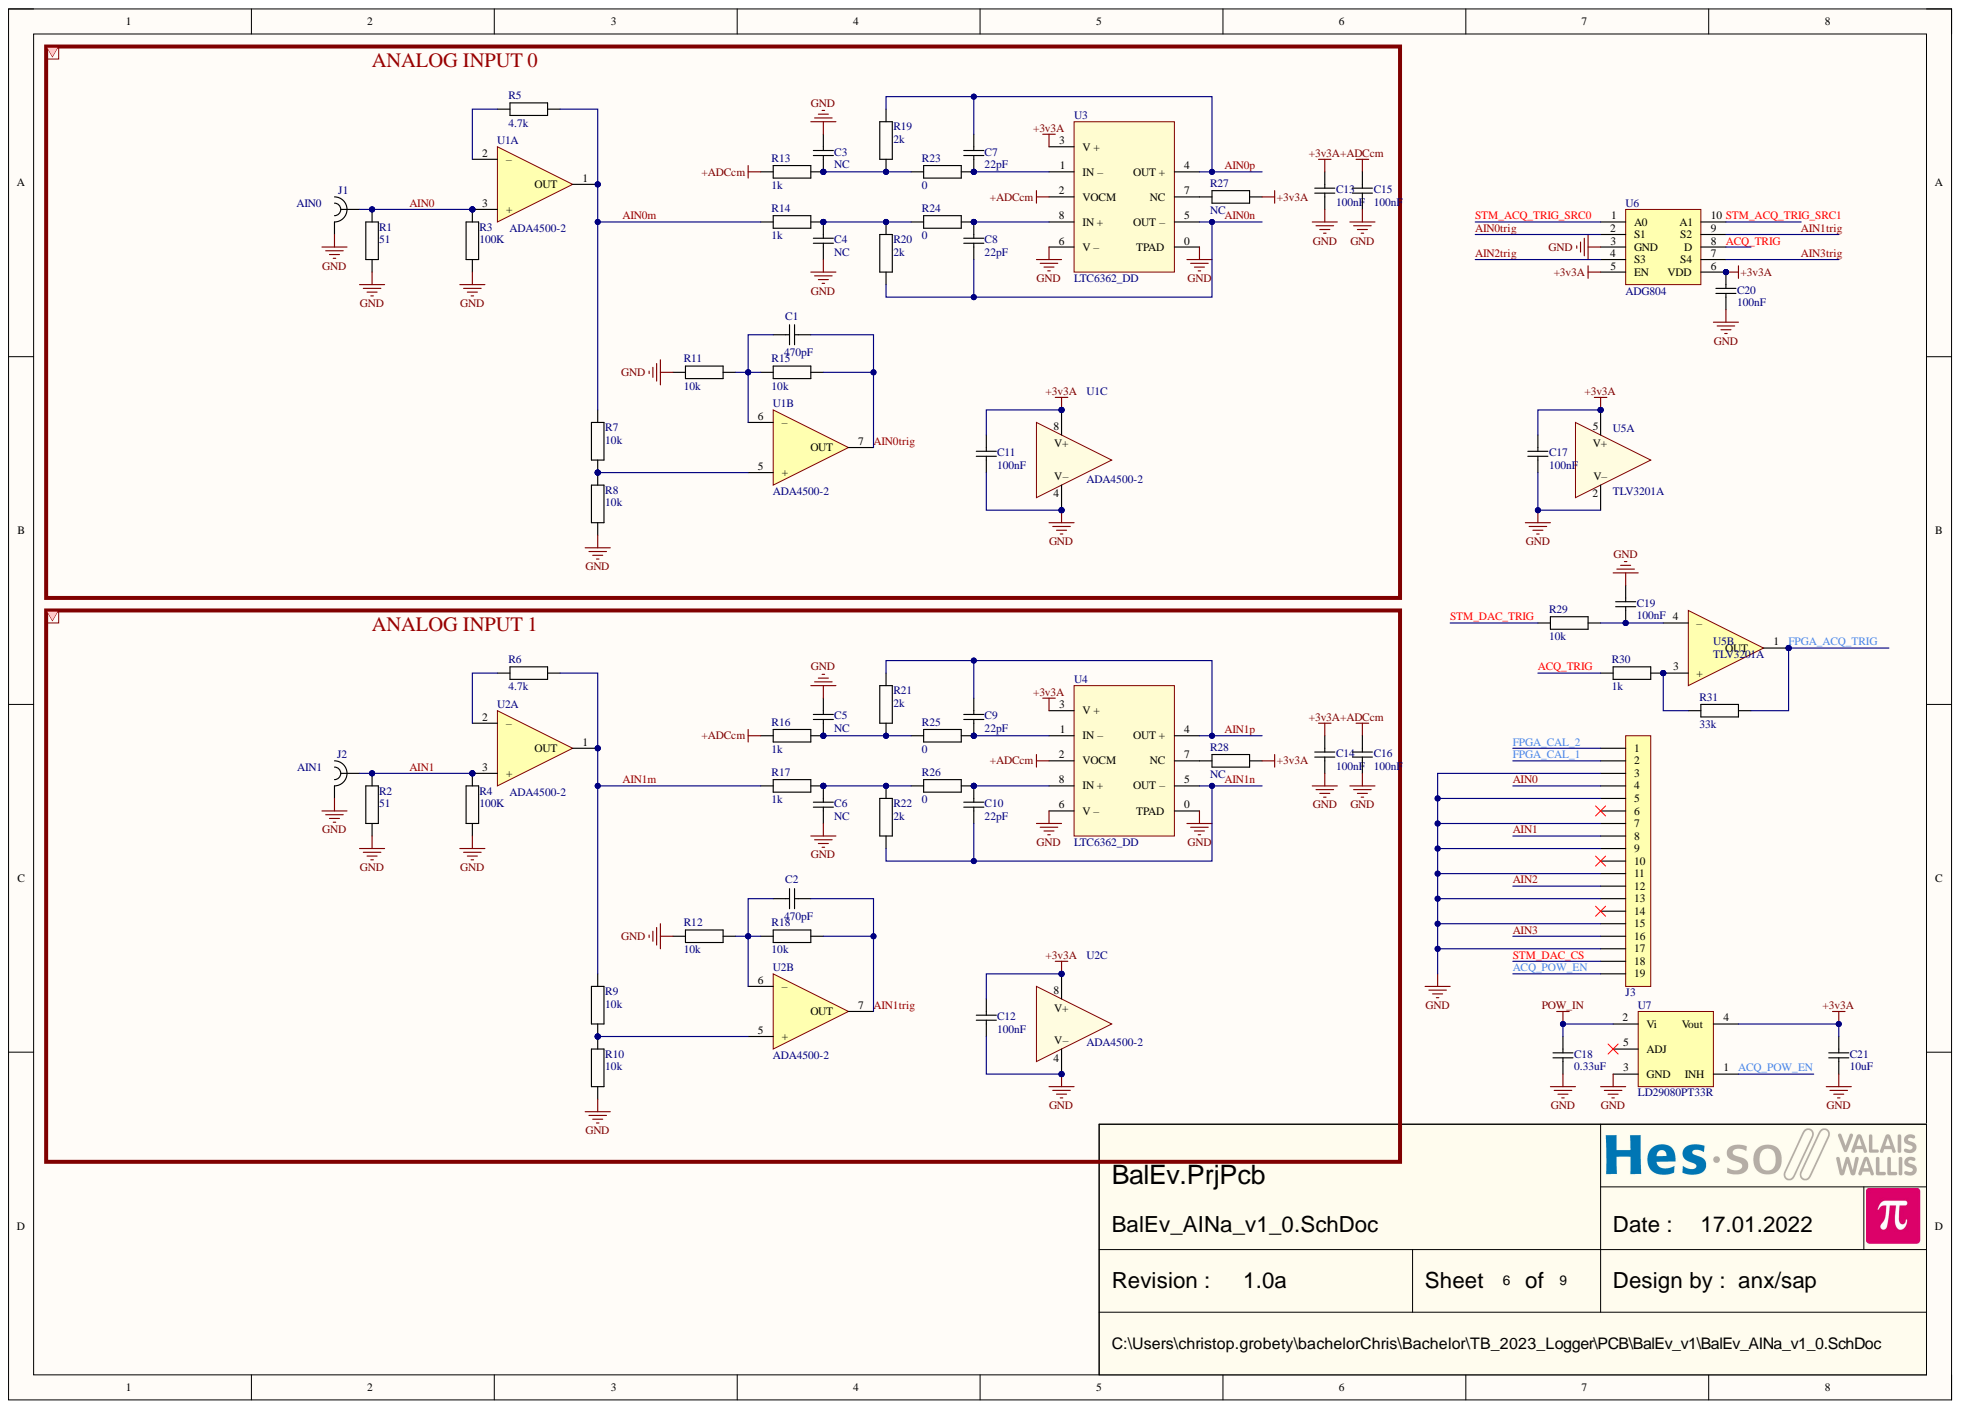
[picture p110: page 6]

Date : 17.01.2022

Revision : 1.0a | Sheet 6 of 9 | Design by : anx/sap

C:\Users\christop.grobety\bachelorChris\Bachelor\TB_2023_Logger\PCB\BalEv_v1\BalEv_AINa_v1_0.SchDoc

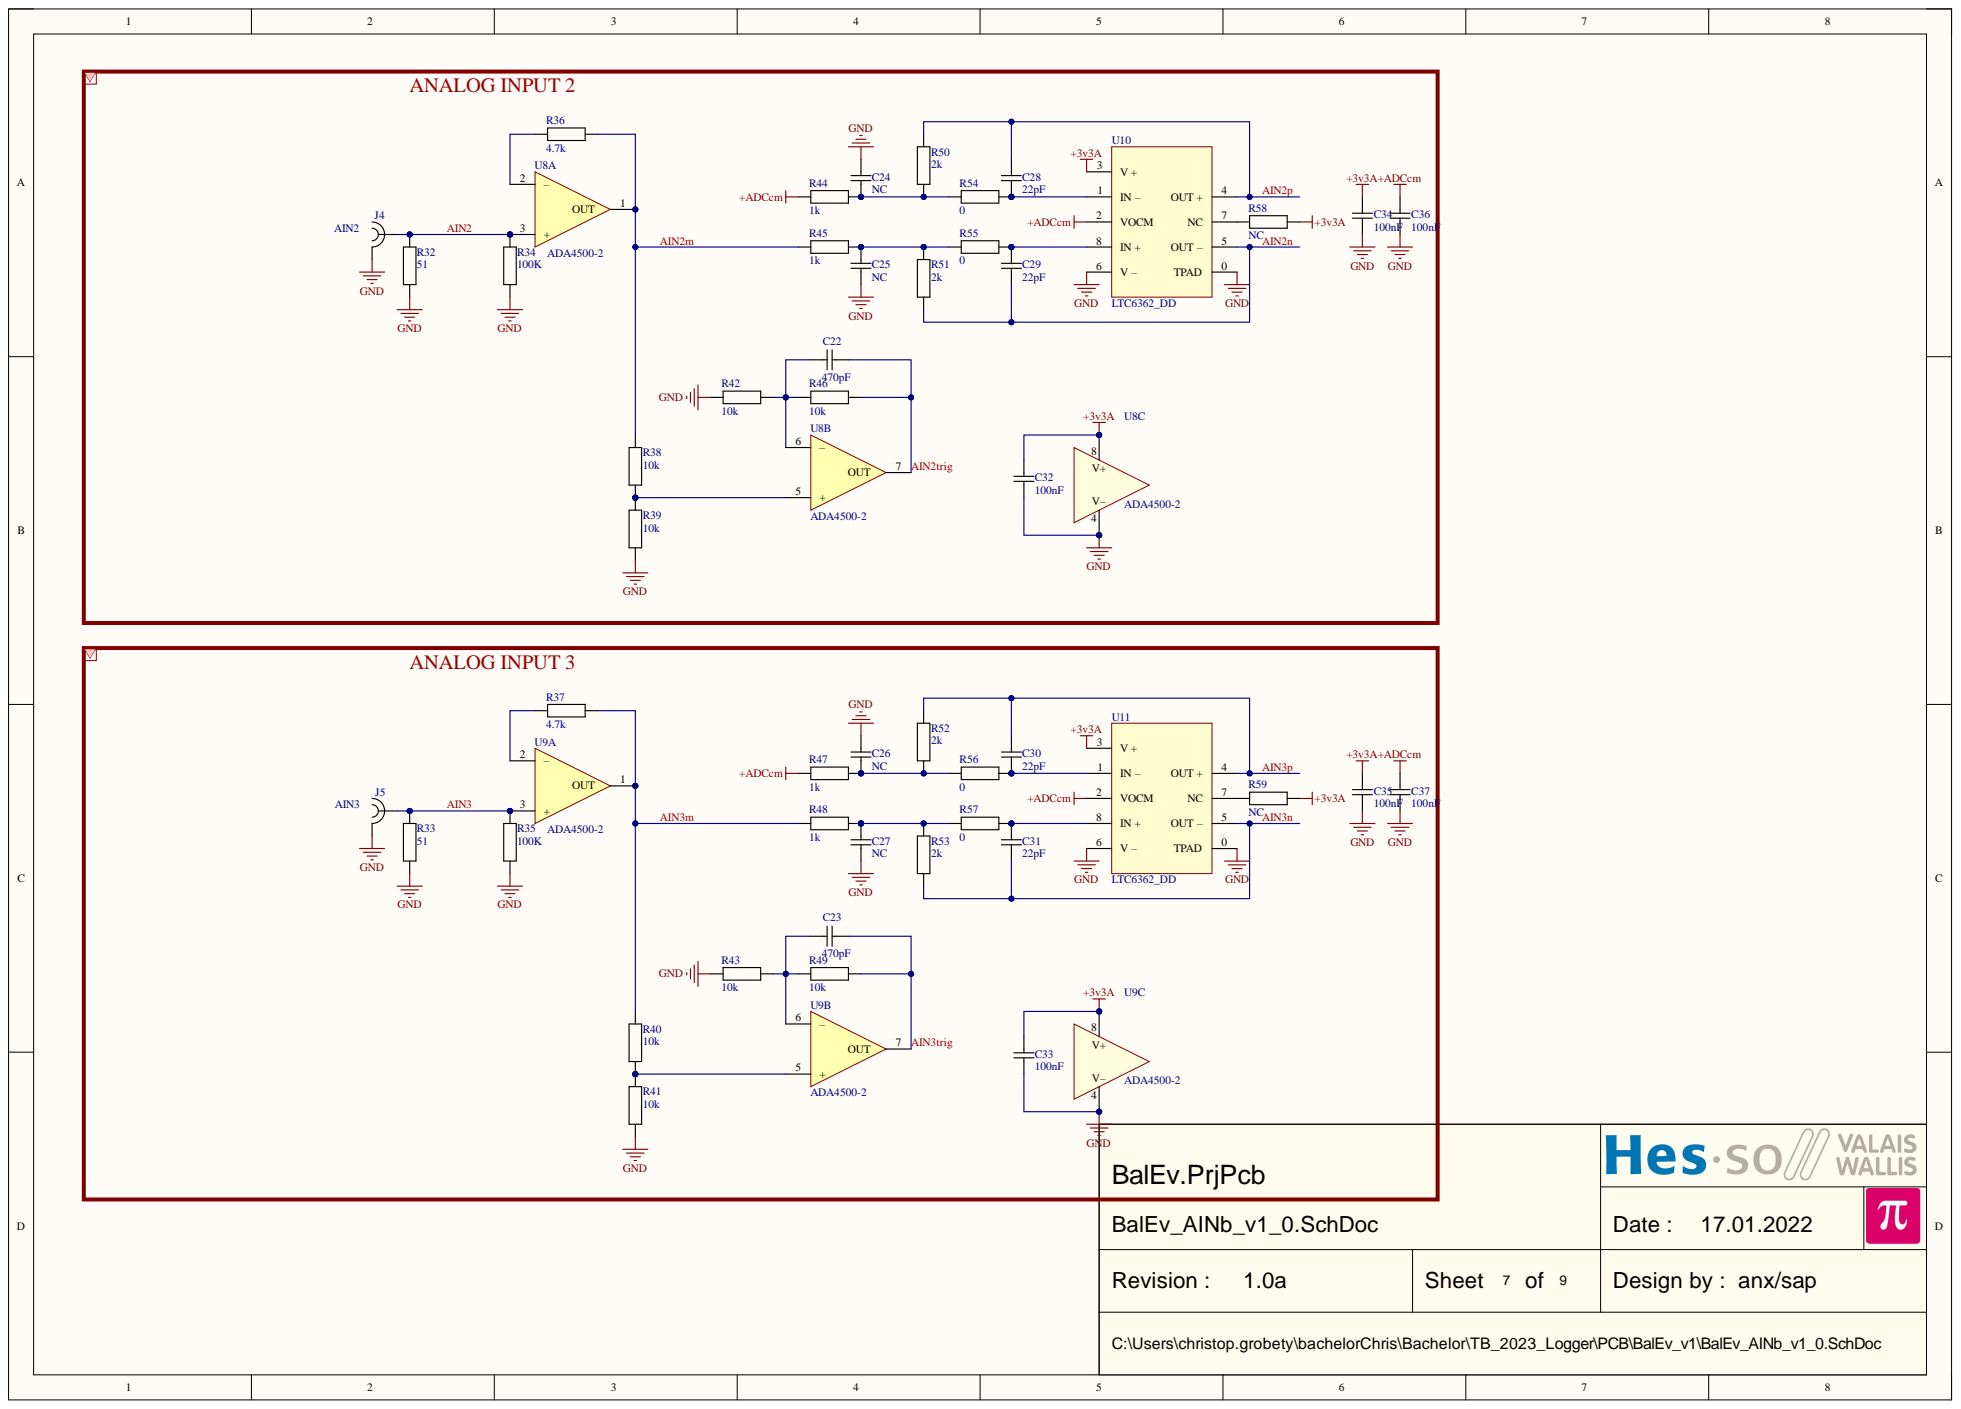
[picture p111: page 7]

Date : 17.01.2022

Revision : 1.0a | Sheet 7 of 9 | Design by : anx/sap

C:\Users\christop.grobety\bachelorChris\Bachelor\TB_2023_Logger\PCB\BalEv_v1\BalEv_AINb_v1_0.SchDoc

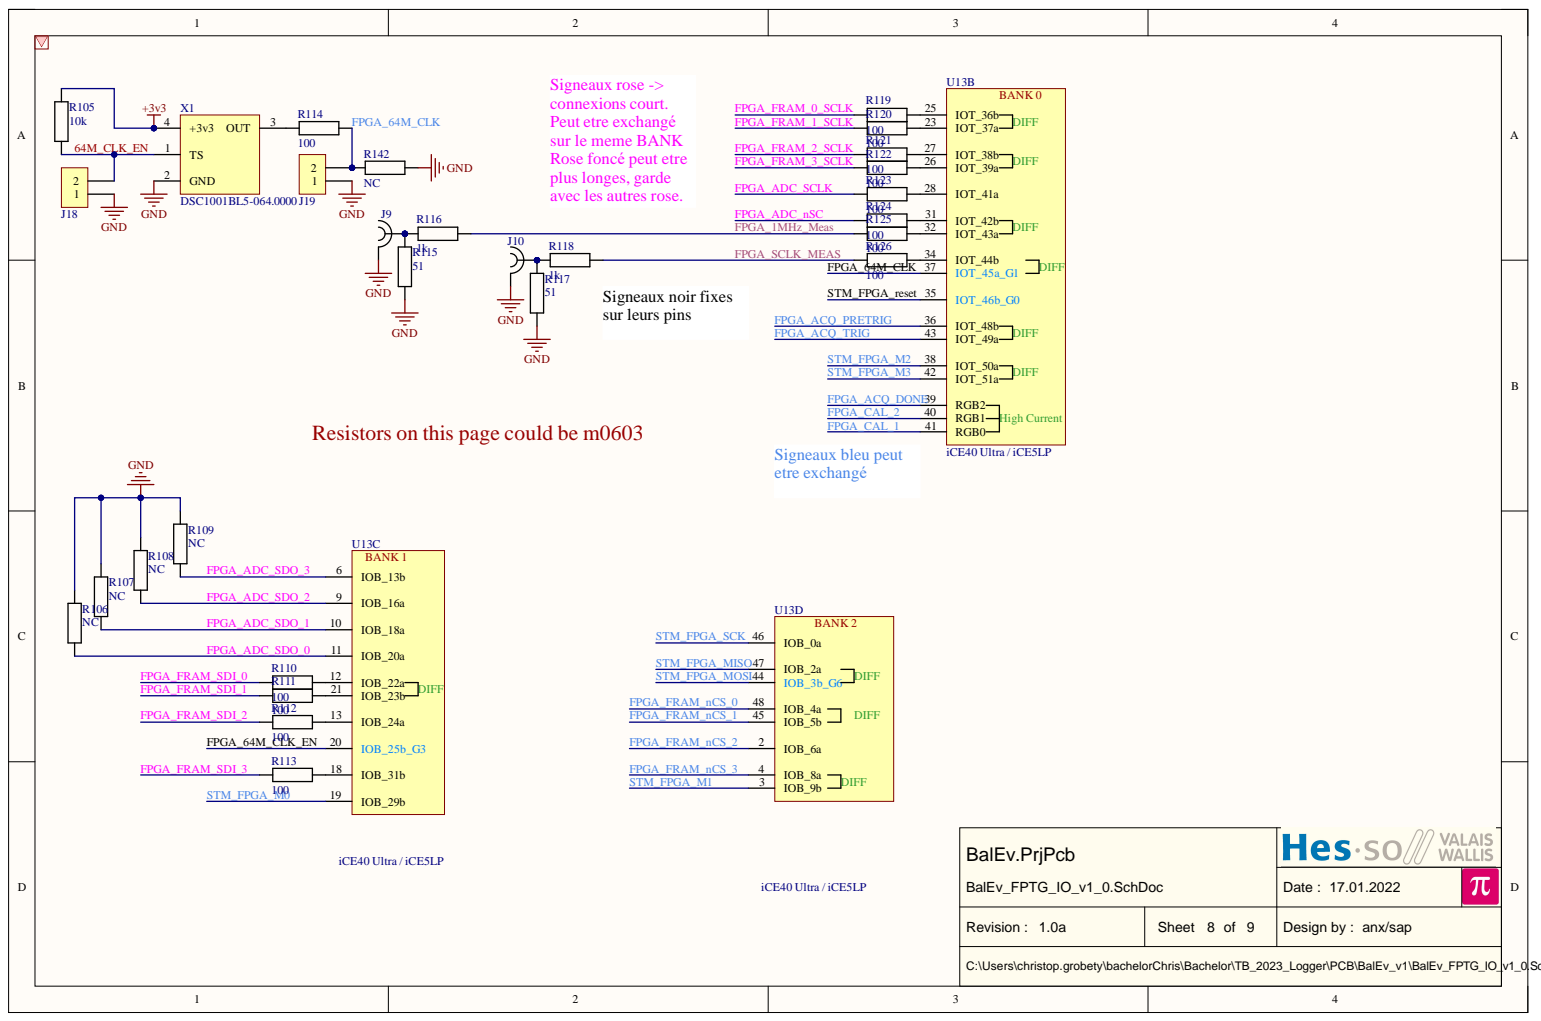
[picture p112: page 8]

Signeaux rose ->
connexions court.
Peut etre exchangé
sur le meme BANK
Rose foncé peut etre
plus longes, garde
avec les autres rose.

Resistors on this page could be m0603

BalEv.PrjPcb BalEv_FPTG_IO_v1_0.SchDoc

Date : 17.01.2022

Revision : 1.0a | Sheet 8 of 9 | Design by : anx/sap

C:\Users\christop.grobety\bachelorChris\Bachelor\TB_2023_Logger\PCB\BalEv_v1\BalEv_FPTG_IO_v1_0.SchDoc

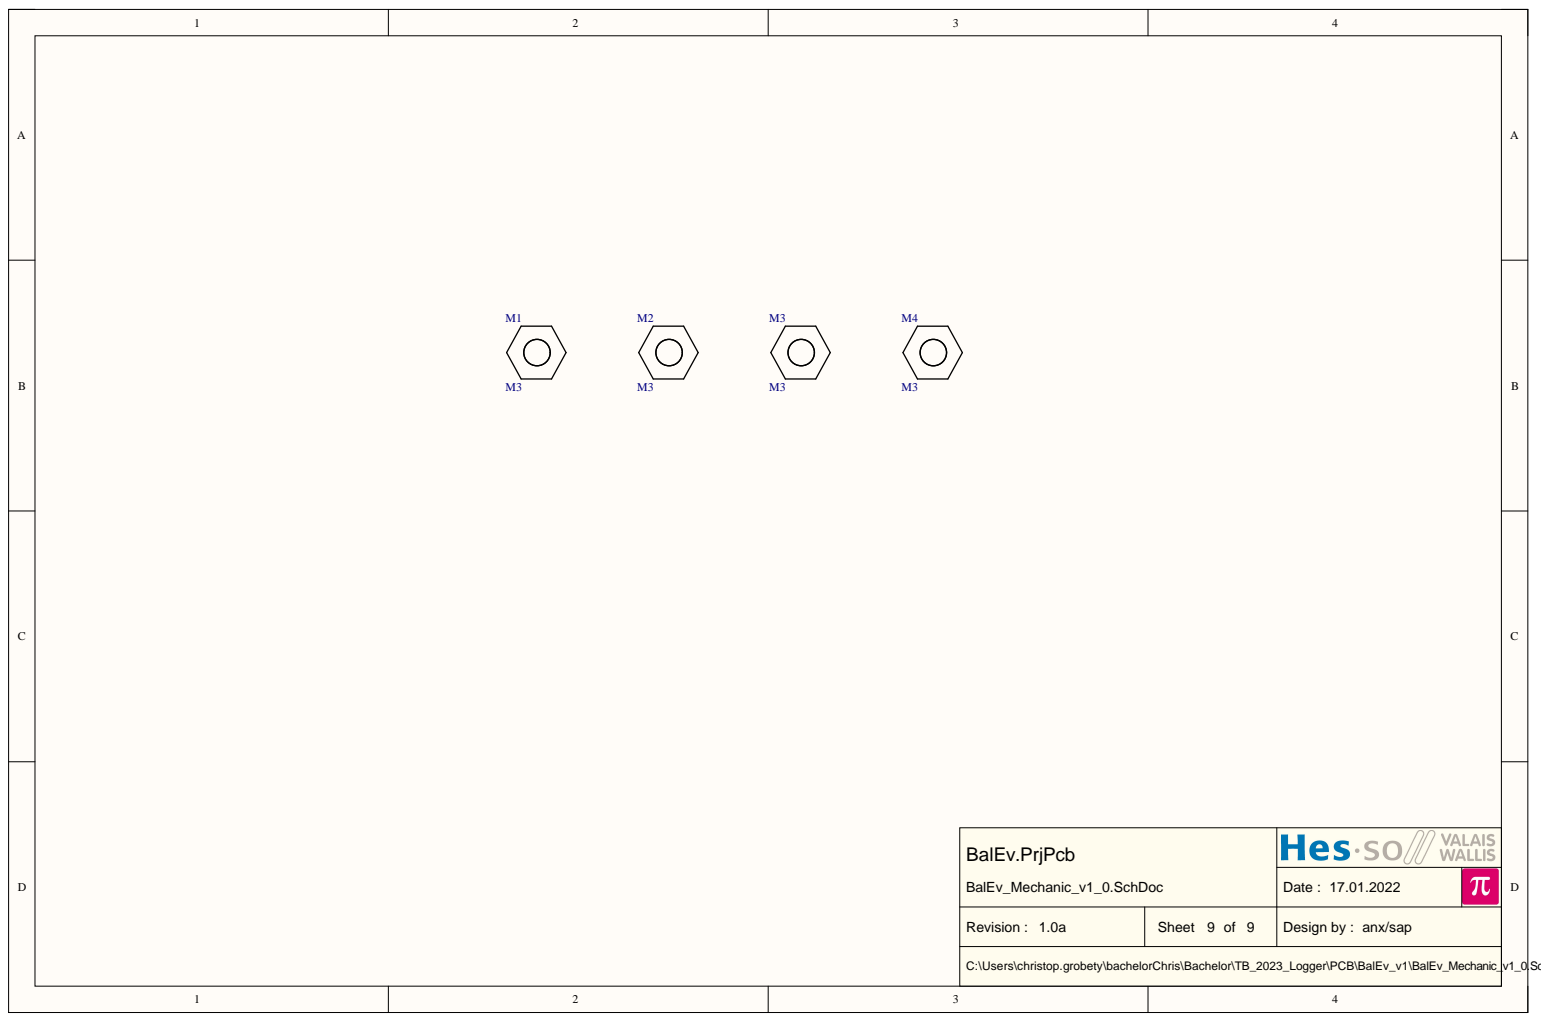
[picture p113: page 9]

BalEv.PrjPcb BalEv_Mechanic_v1_0.SchDoc

Date : 17.01.2022

Revision : 1.0a | Sheet 9 of 9 | Design by : anx/sap

C:\Users\christop.grobety\bachelorChris\Bachelor\TB_2023_Logger\PCB\BalEv_v1\BalEv_Mechanic_v1_0.SchDoc

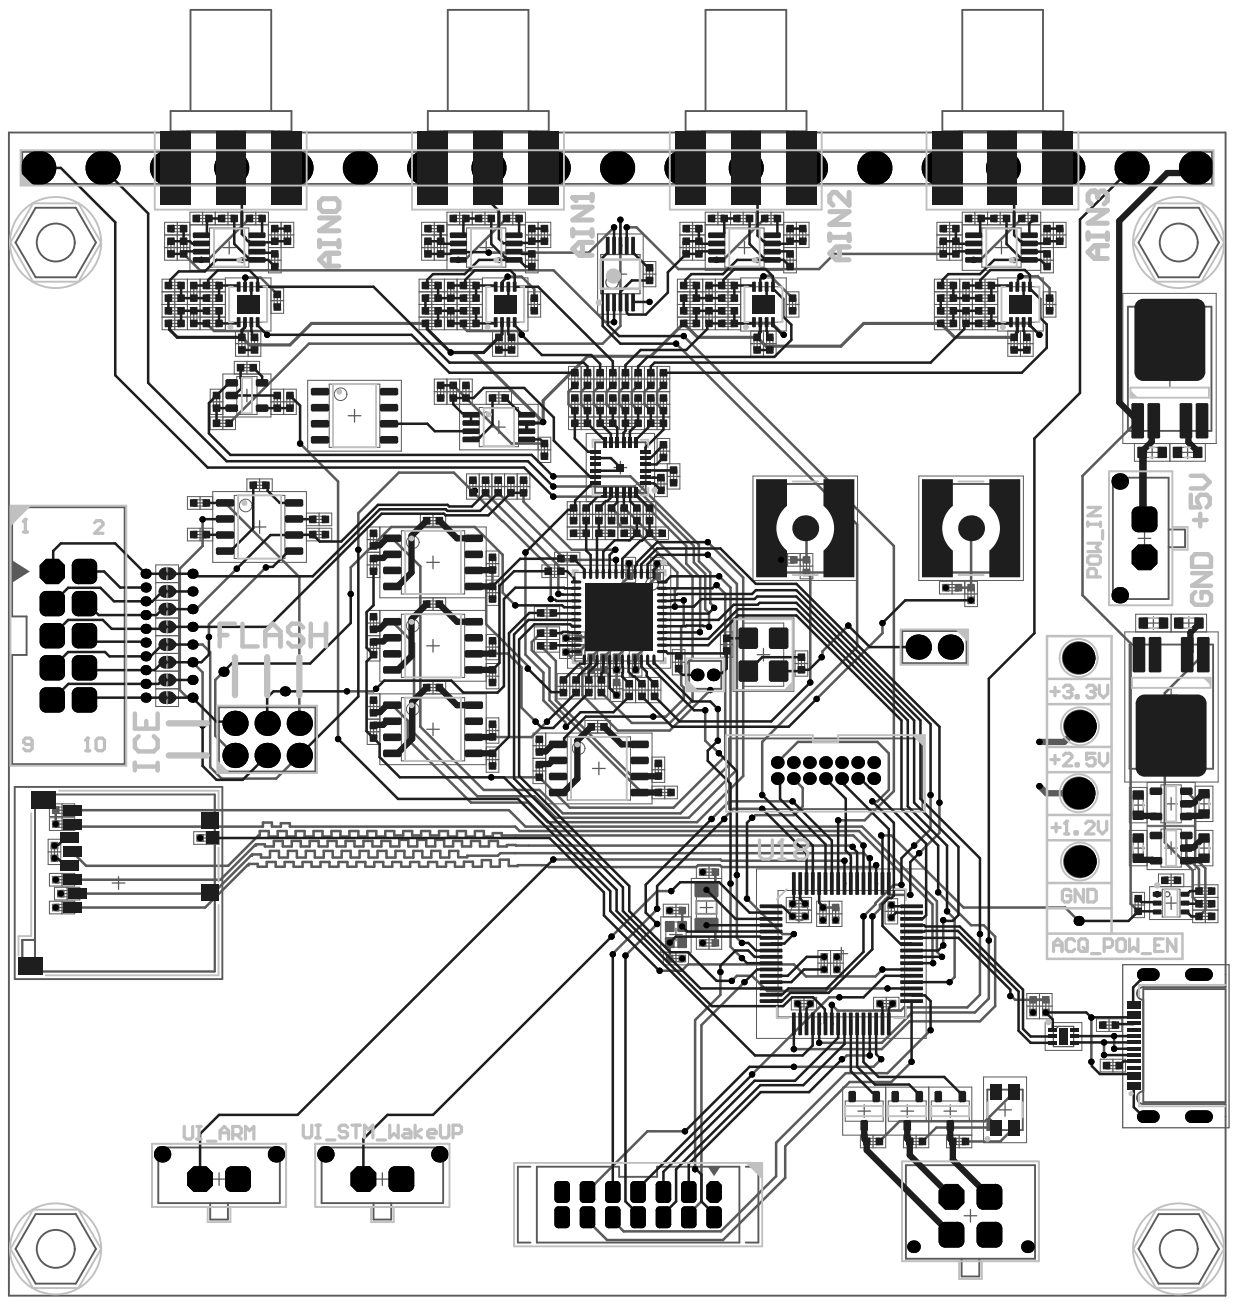
[picture p114: page 10]
