Drident/High_Speed_Data/DAILY_REPPORT/FPGA/code_test.pdf

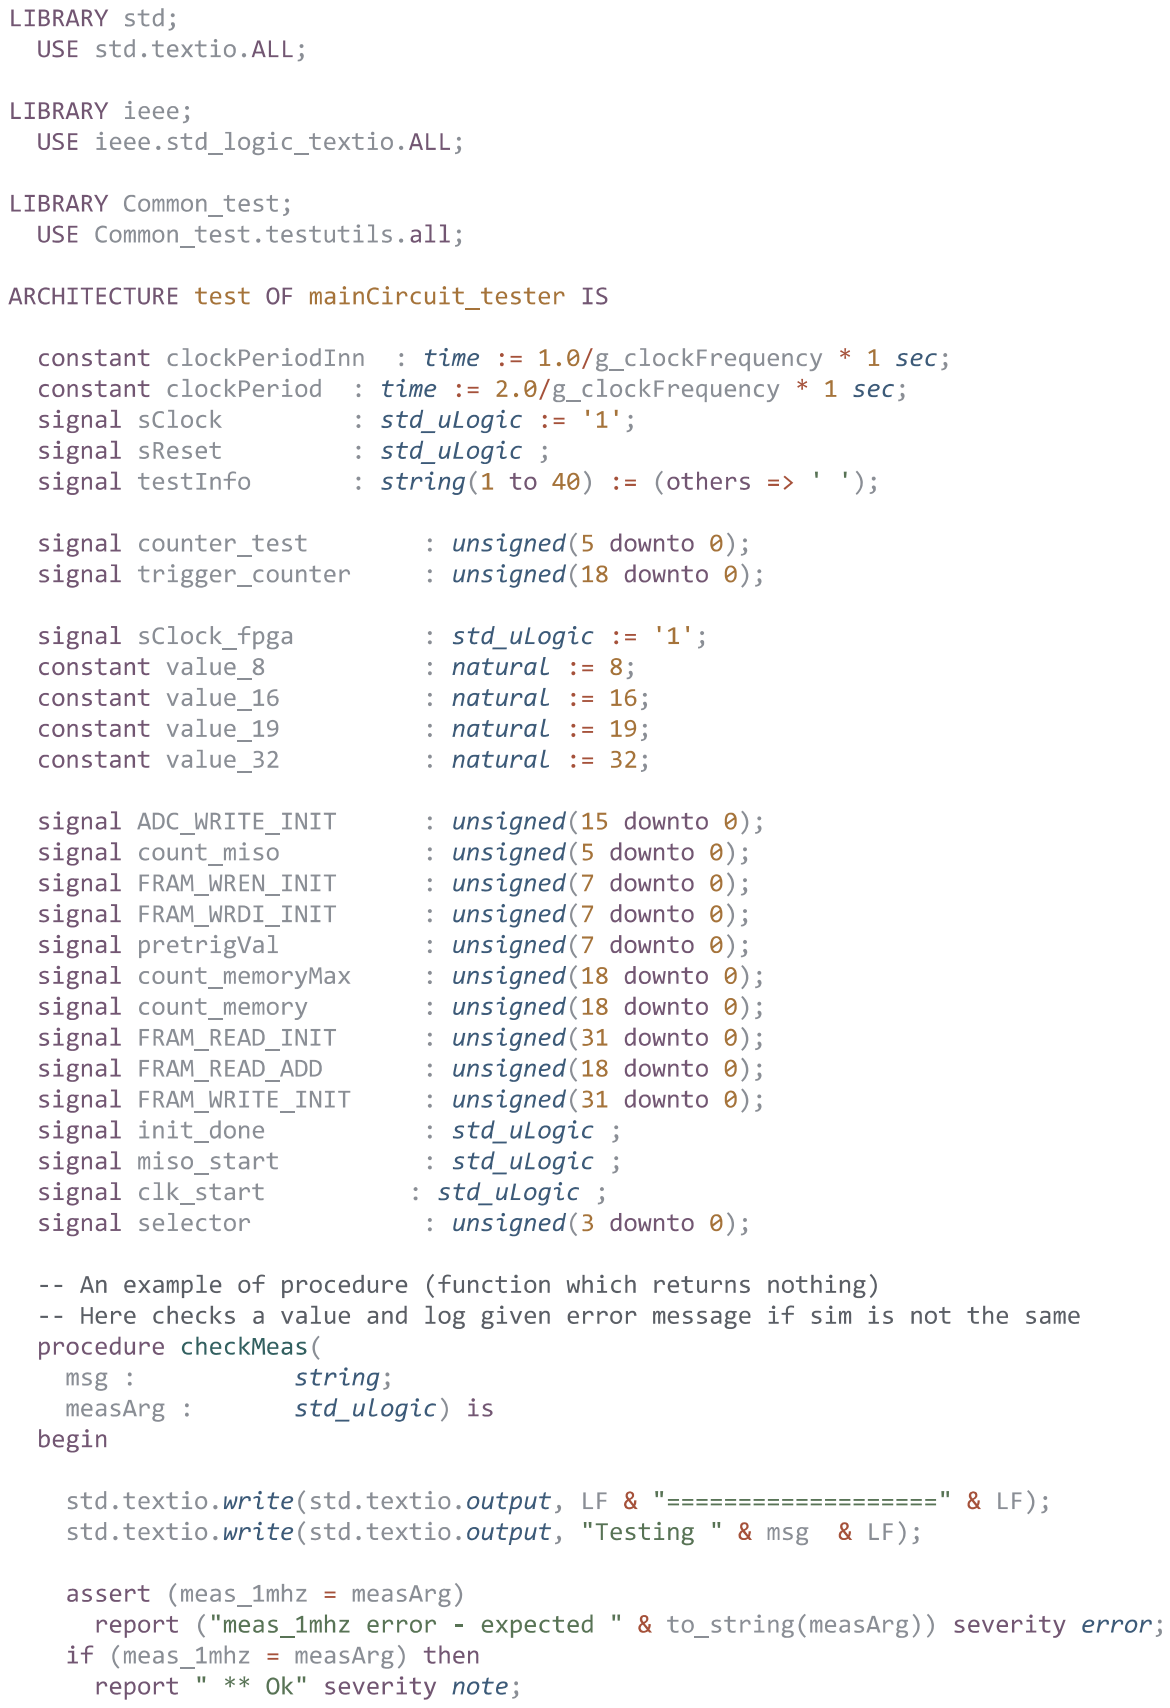
[picture p115: page 1]

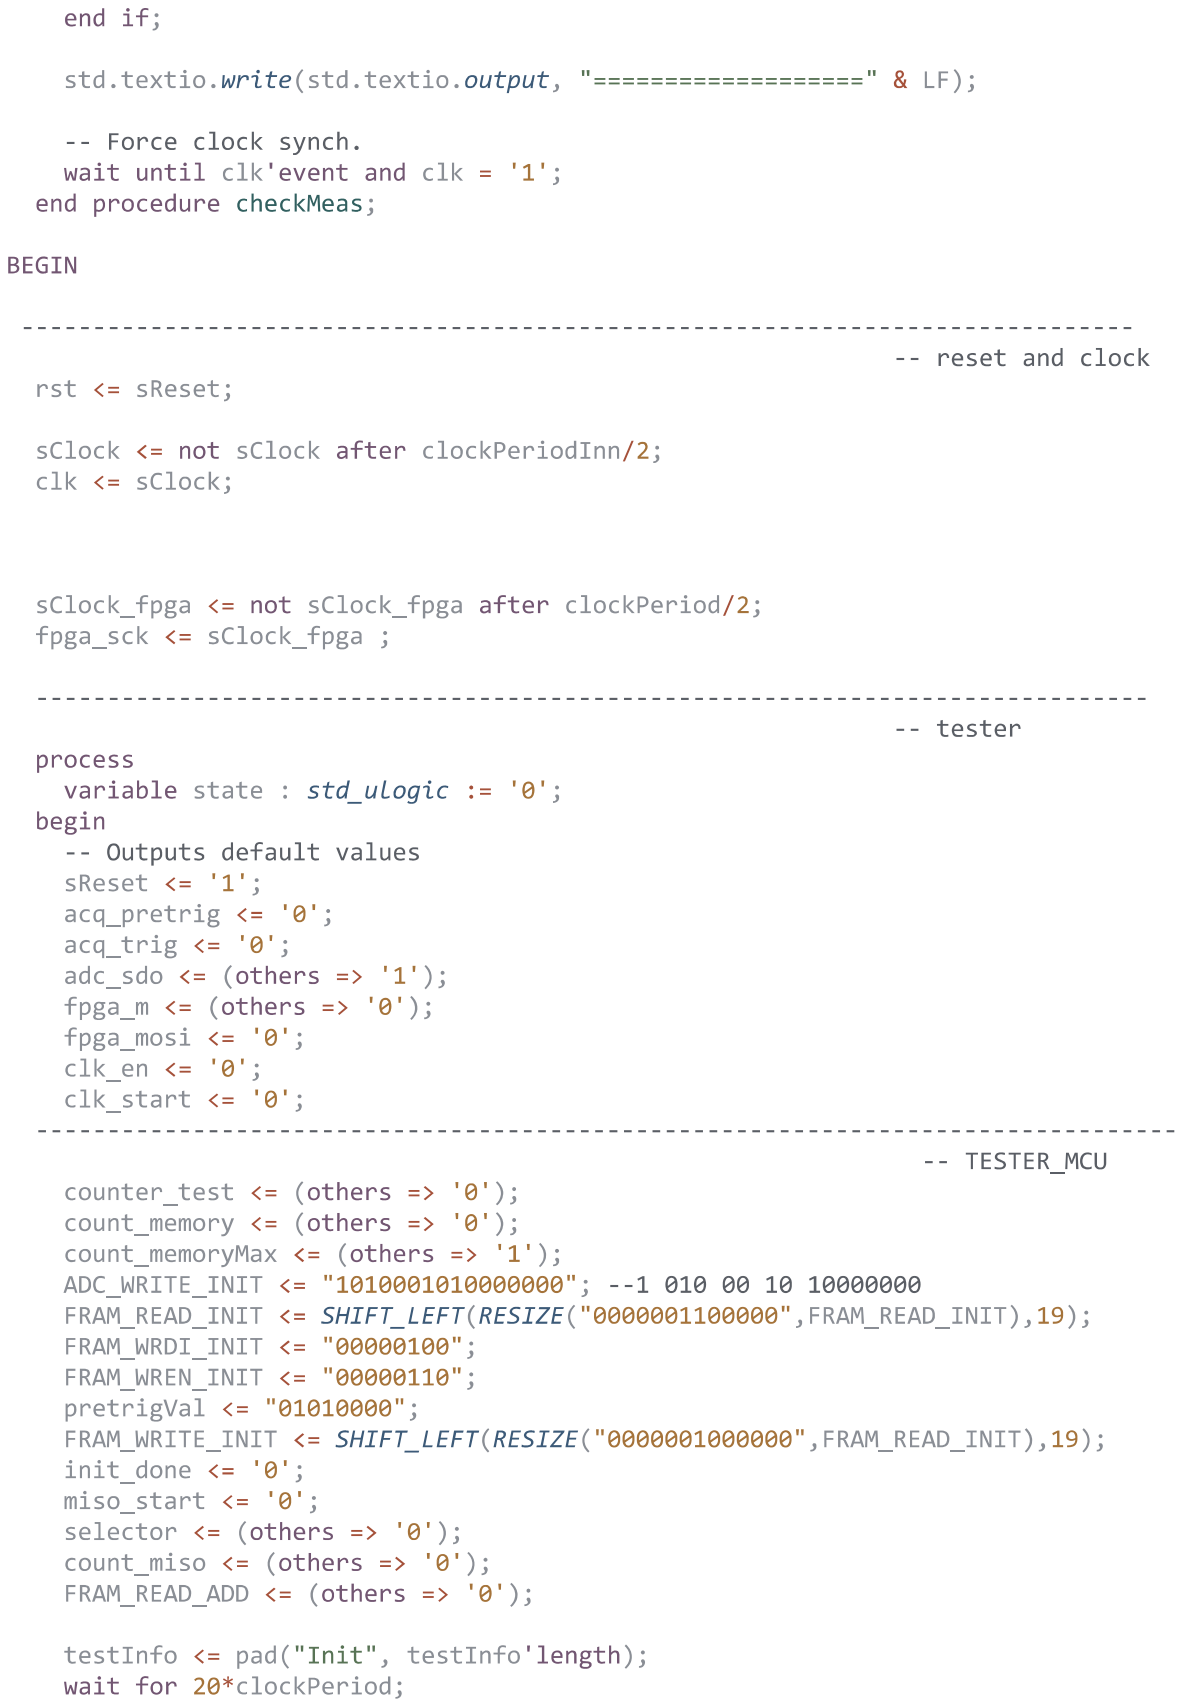
[picture p116: page 2]

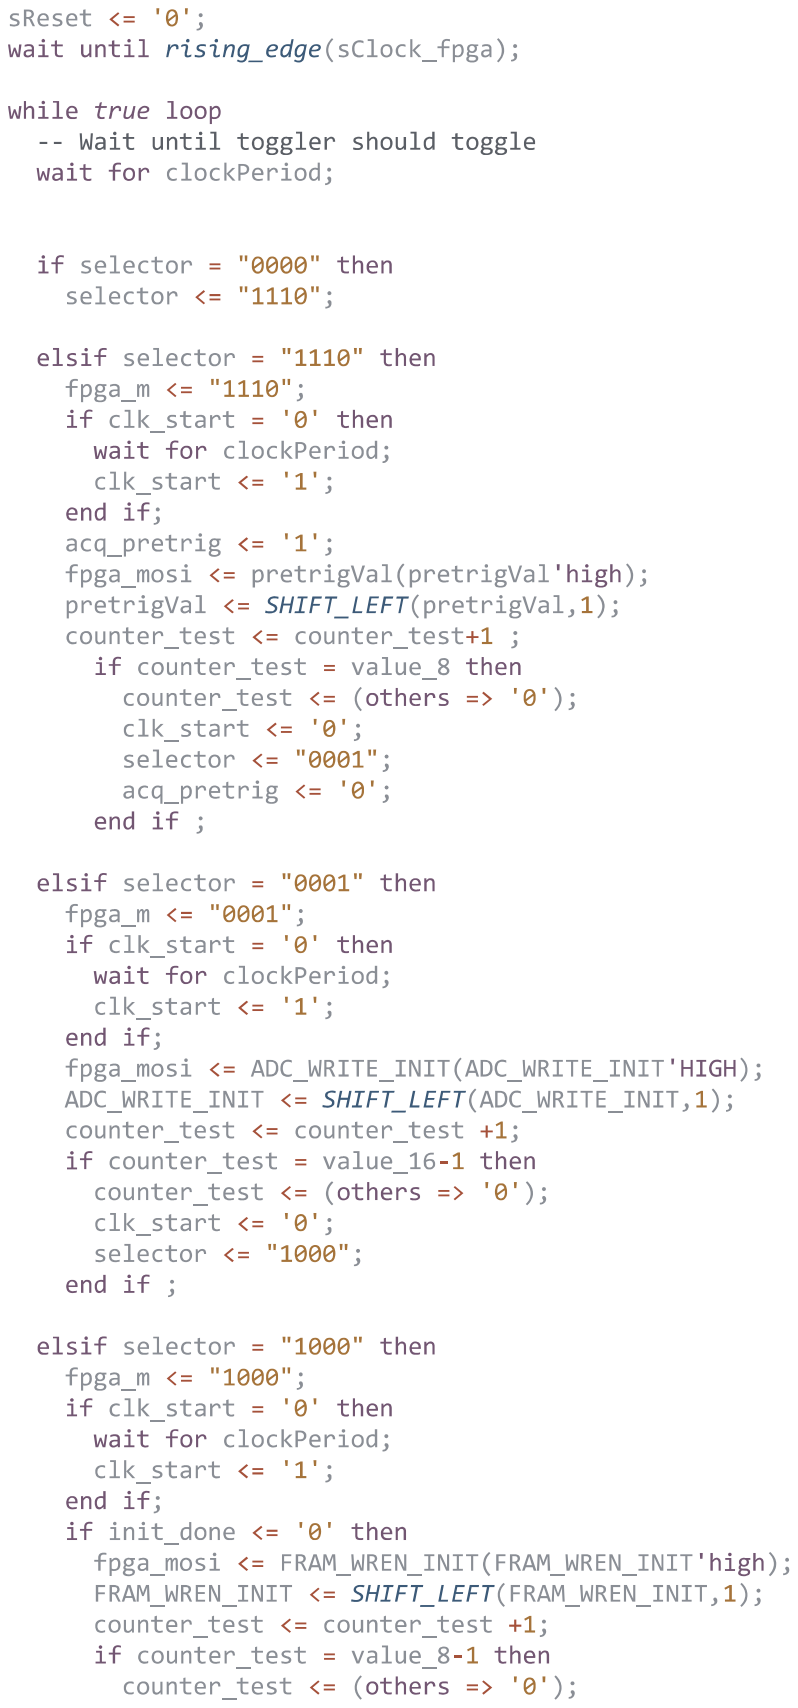
[picture p117: page 3]

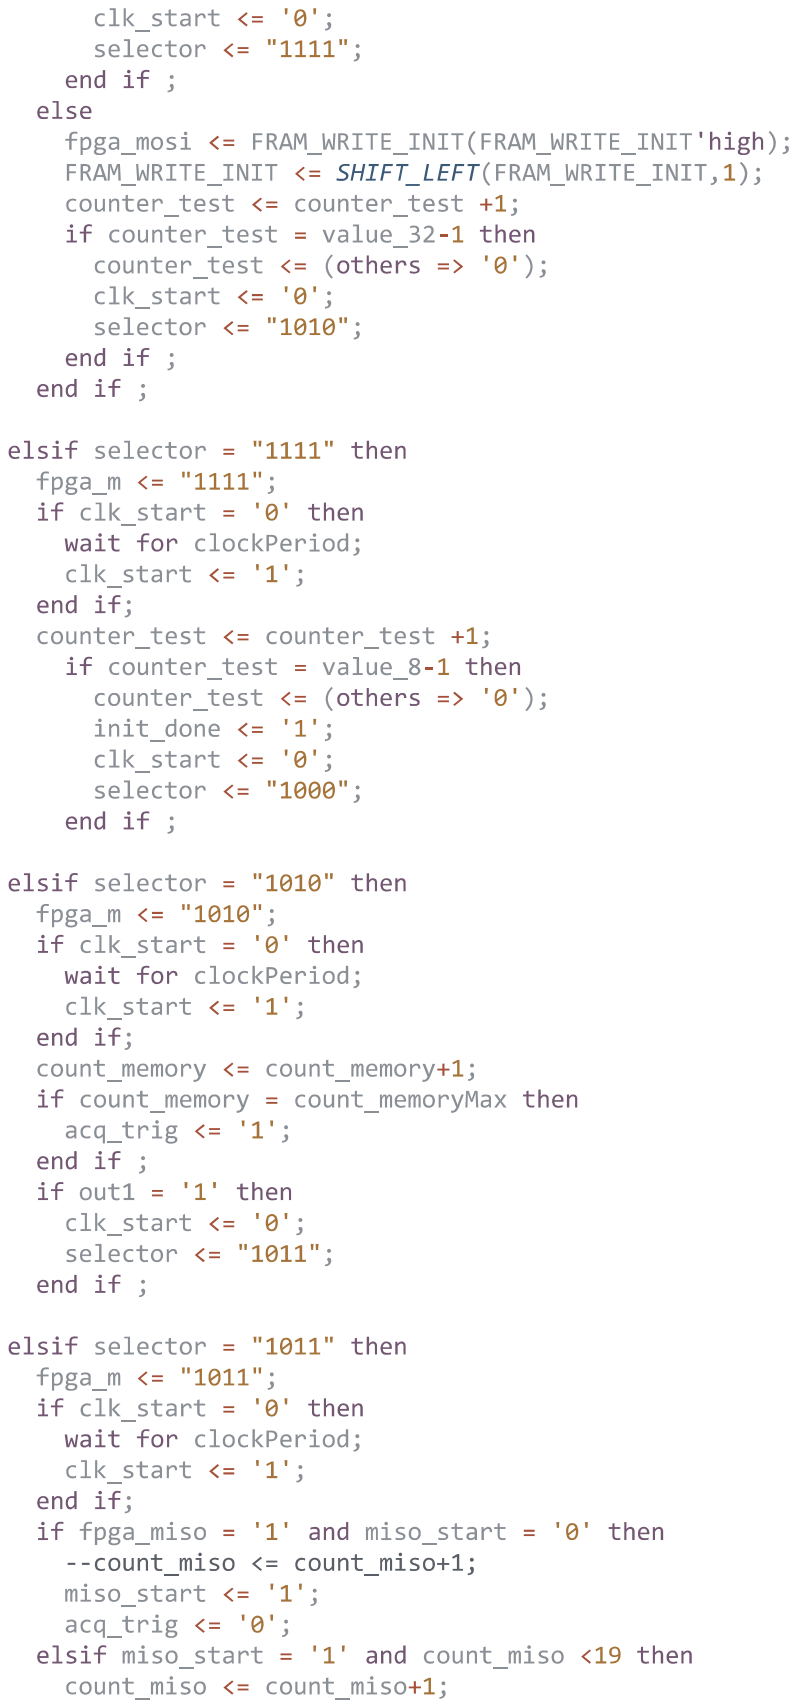
[picture p118: page 4]

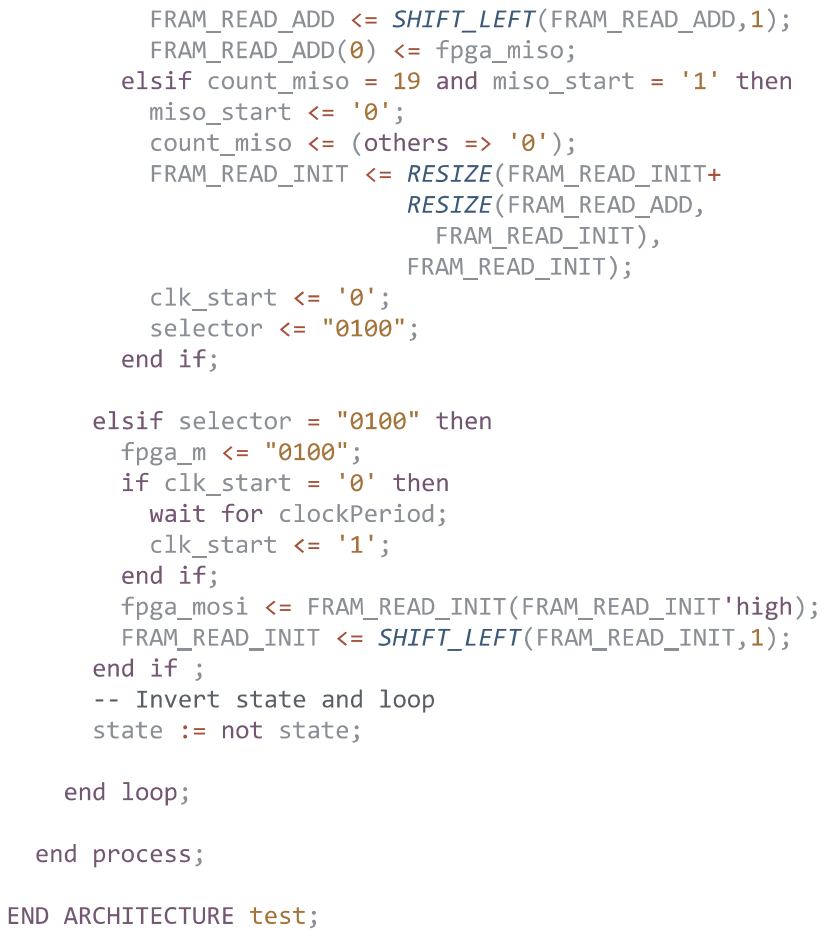
[picture p119: page 5]
