Drident/High_Speed_Data/DAILY_REPPORT/board_pdf/PCB.pdf

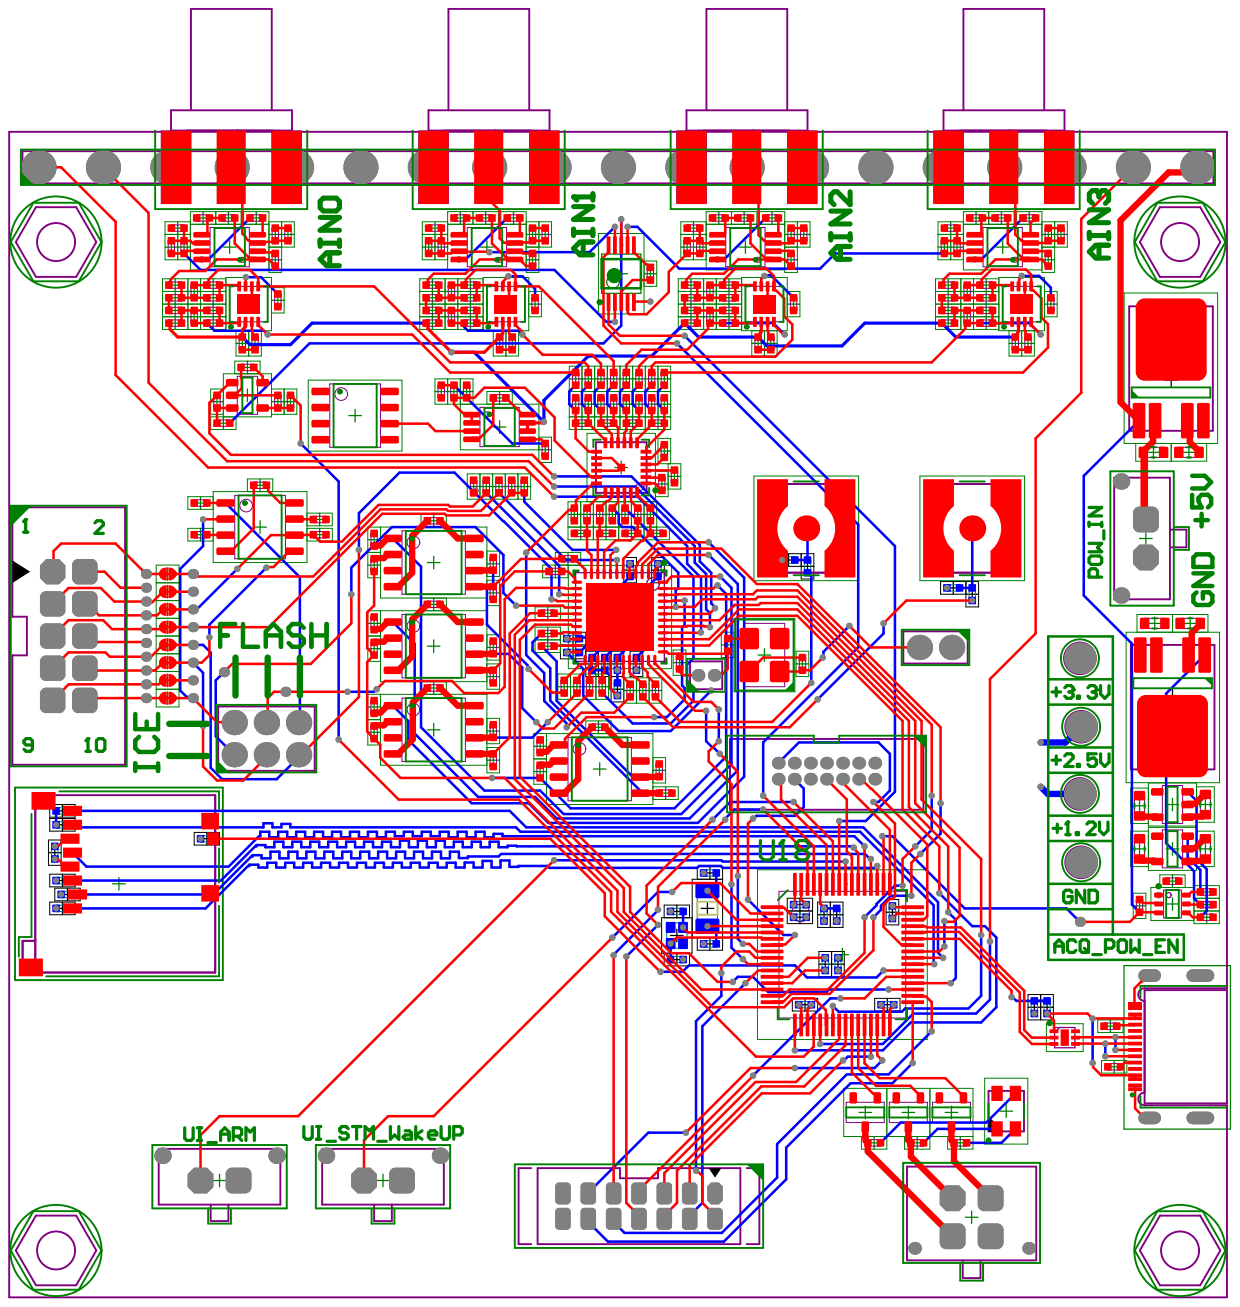
[picture p120: page 1]
