Drident/High_Speed_Data/DAILY_REPPORT/FPGA/adc_to_fpga.pdf

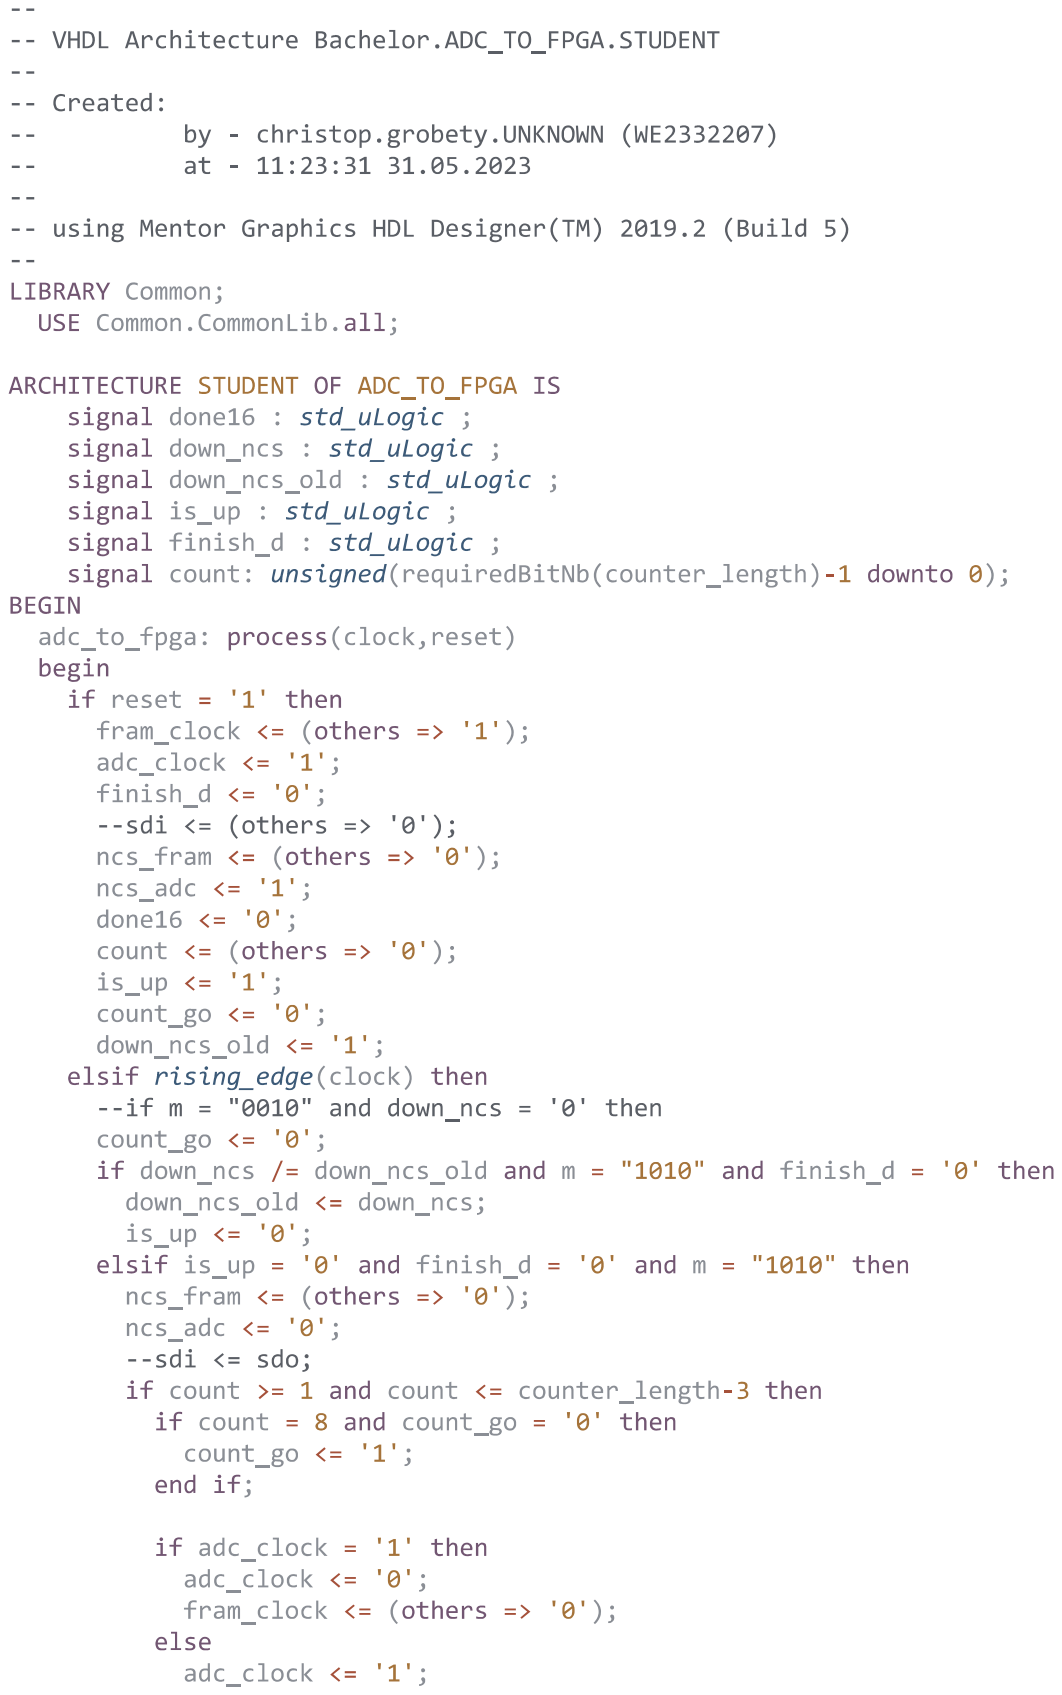
[picture p121: page 1]

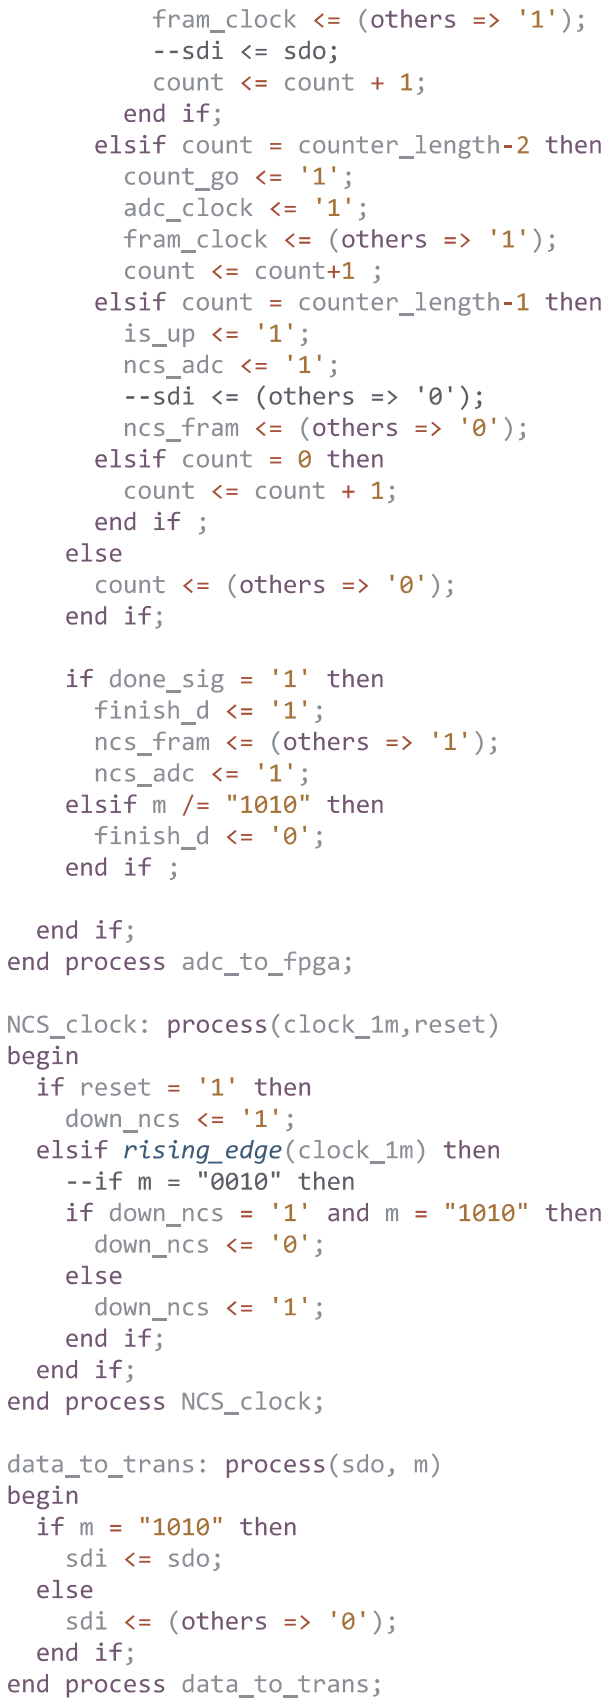
[picture p122: page 2]
