Drident/High_Speed_Data/DAILY_REPPORT/FPGA/adc_write.pdf

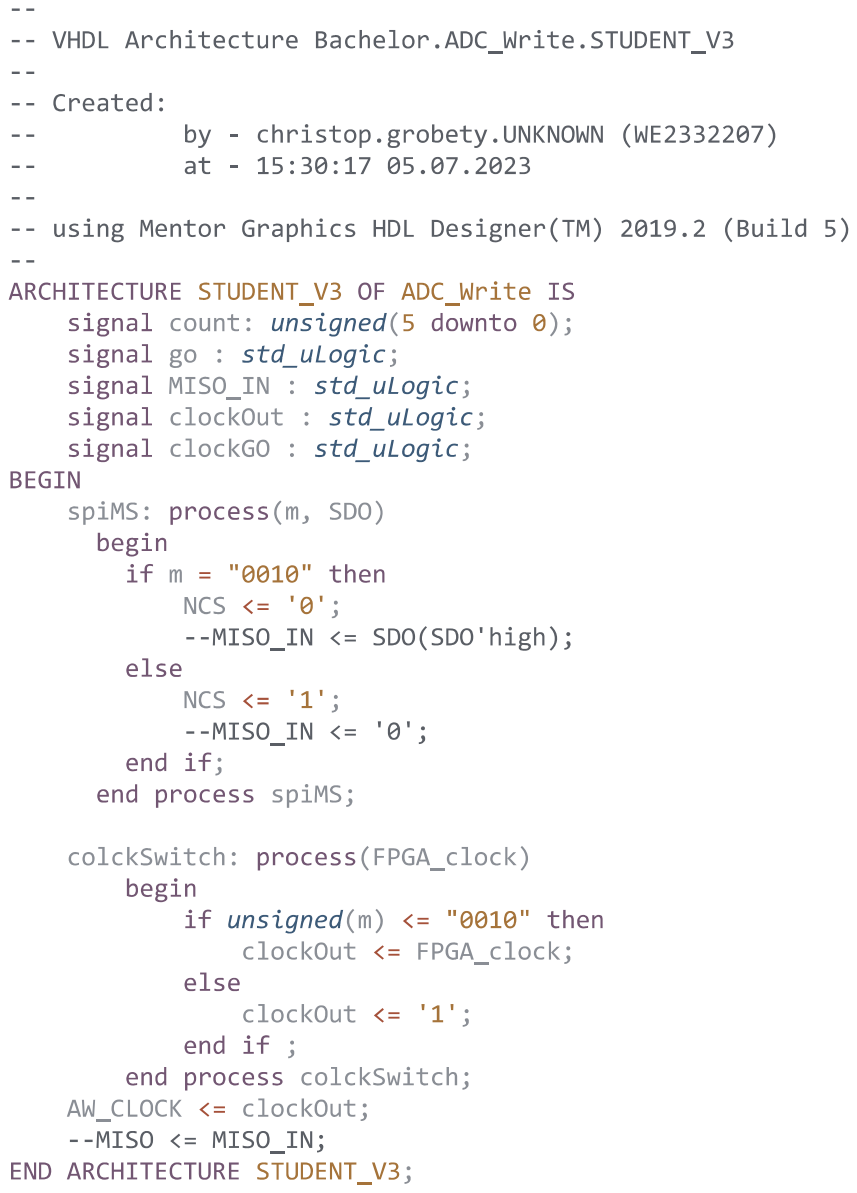
[picture p123: page 1]
