Drident/High_Speed_Data/DAILY_REPPORT/FPGA/bloc_principale.pdf

## Board/EC5LP/struct

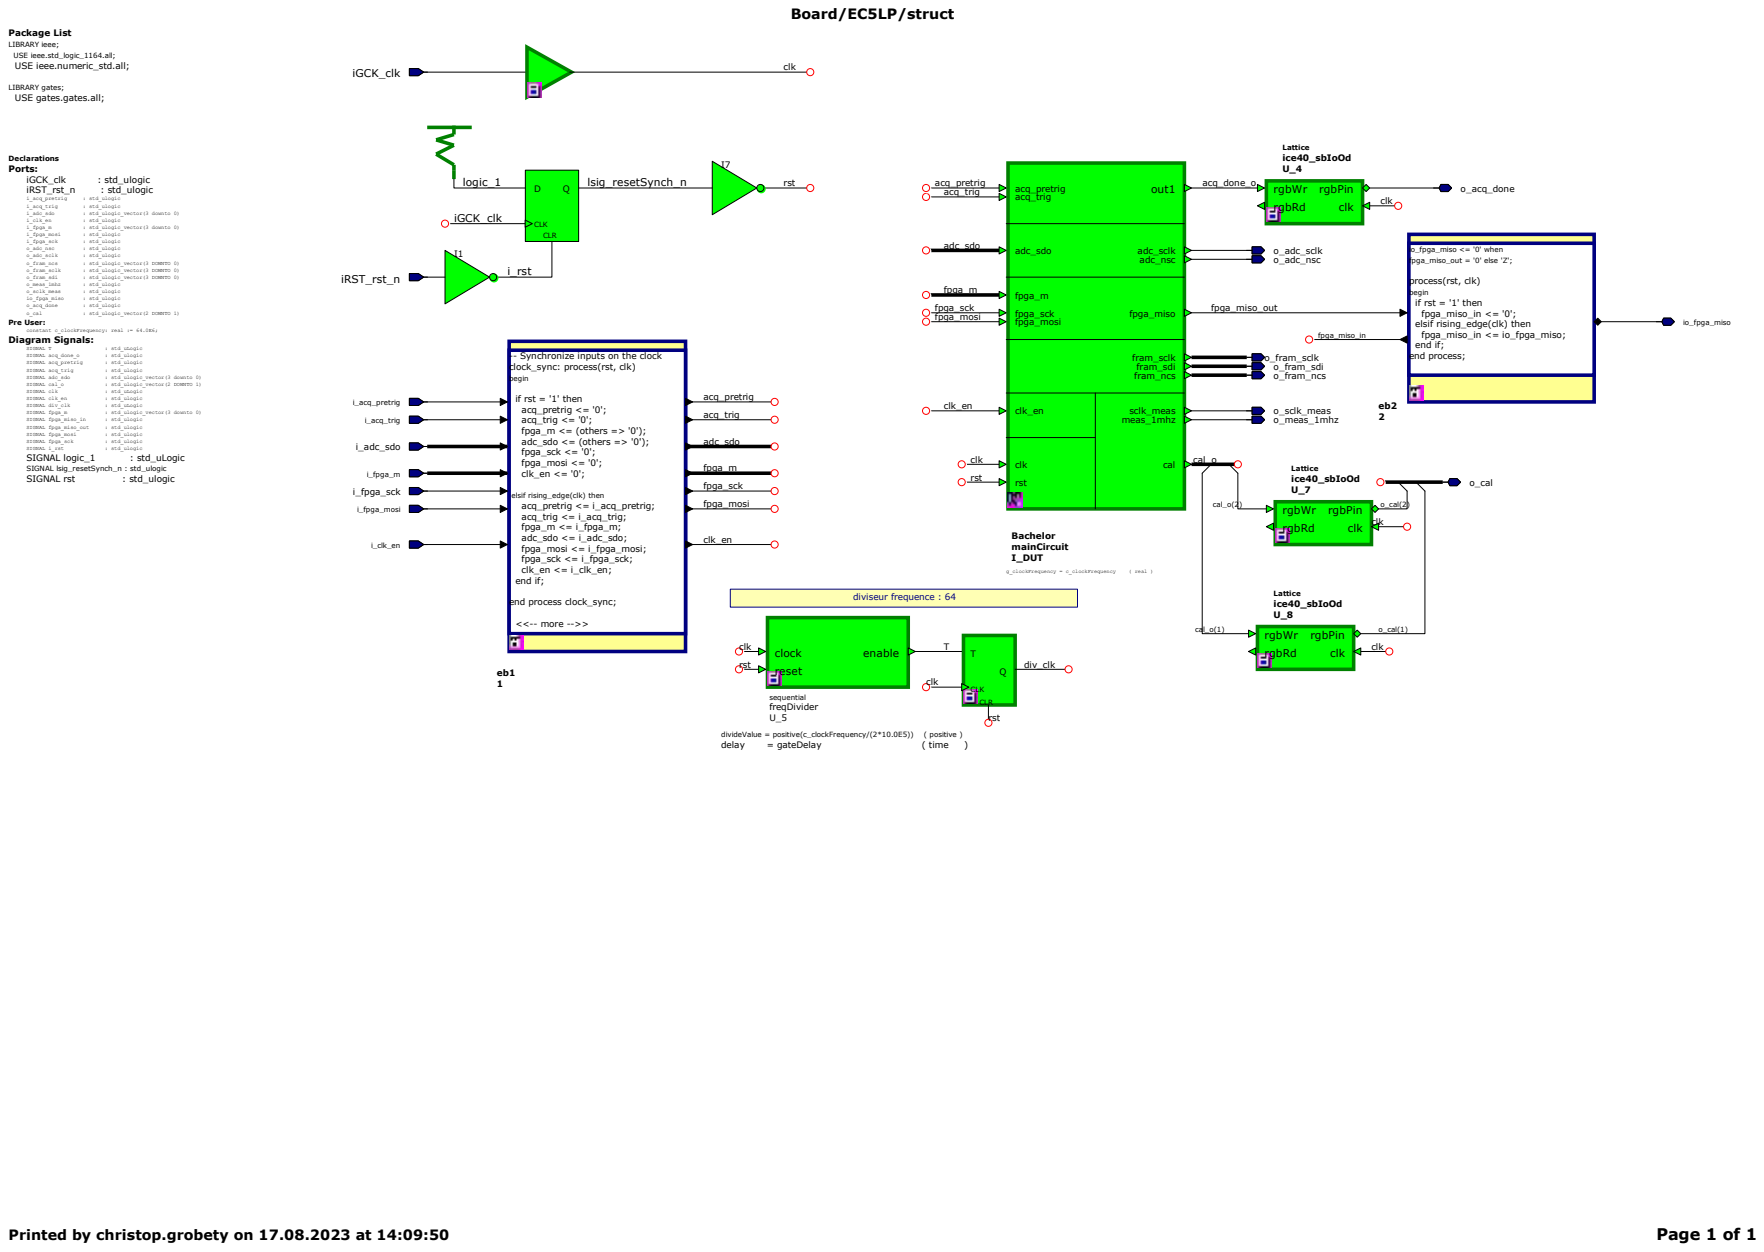
[picture p124: page 1]
reset; SIGNAL T; : std_uLogic; iGCK_clk; : std_ulogic; logic_1; lsig_resetSynch_n; rst; Declarations Ports:; clk; Pre User:; constant c_clockFrequency: real := 64.0E6; Diagram Signals:; iRST_rst_n; o_meas_1mhz; o_sclk_meas; o_fram_sclk; : std_ulogic_vector(3 DOWNTO 0); o_adc_sclk; o_adc_nsc; i_acq_pretrig; i_acq_trig; i_fpga_m; : std_ulogic_vector(3 downto 0); o_acq_done; o_cal; : std_ulogic_vector(2 DOWNTO 1); i_adc_sdo; o_fram_sdi; i_clk_en; i_fpga_sck; i_fpga_mosi; o_fram_ncs; io_fpga_miso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

Package List
LIBRARY ieee;
USE ieee.std_logic_1164.all;
USE ieee.numeric_std.all;

LIBRARY gates;
USE gates.gates.all;

io_fpga_miso <= '0' when
fpga_miso_out = '0' else 'Z';
process(rst, clk)
begin
if rst = '1' then
fpga_miso_in <= '0';
elsif rising_edge(clk) then
fpga_miso_in <= io_fpga_miso;
end if;
end process;

divideValue = positive(c_clockFrequency/(2*10.0E5)) ( positive )
