Drident/High_Speed_Data/DAILY_REPPORT/FPGA/bloc_second.pdf

## Bachelor/mainCircuit/struct

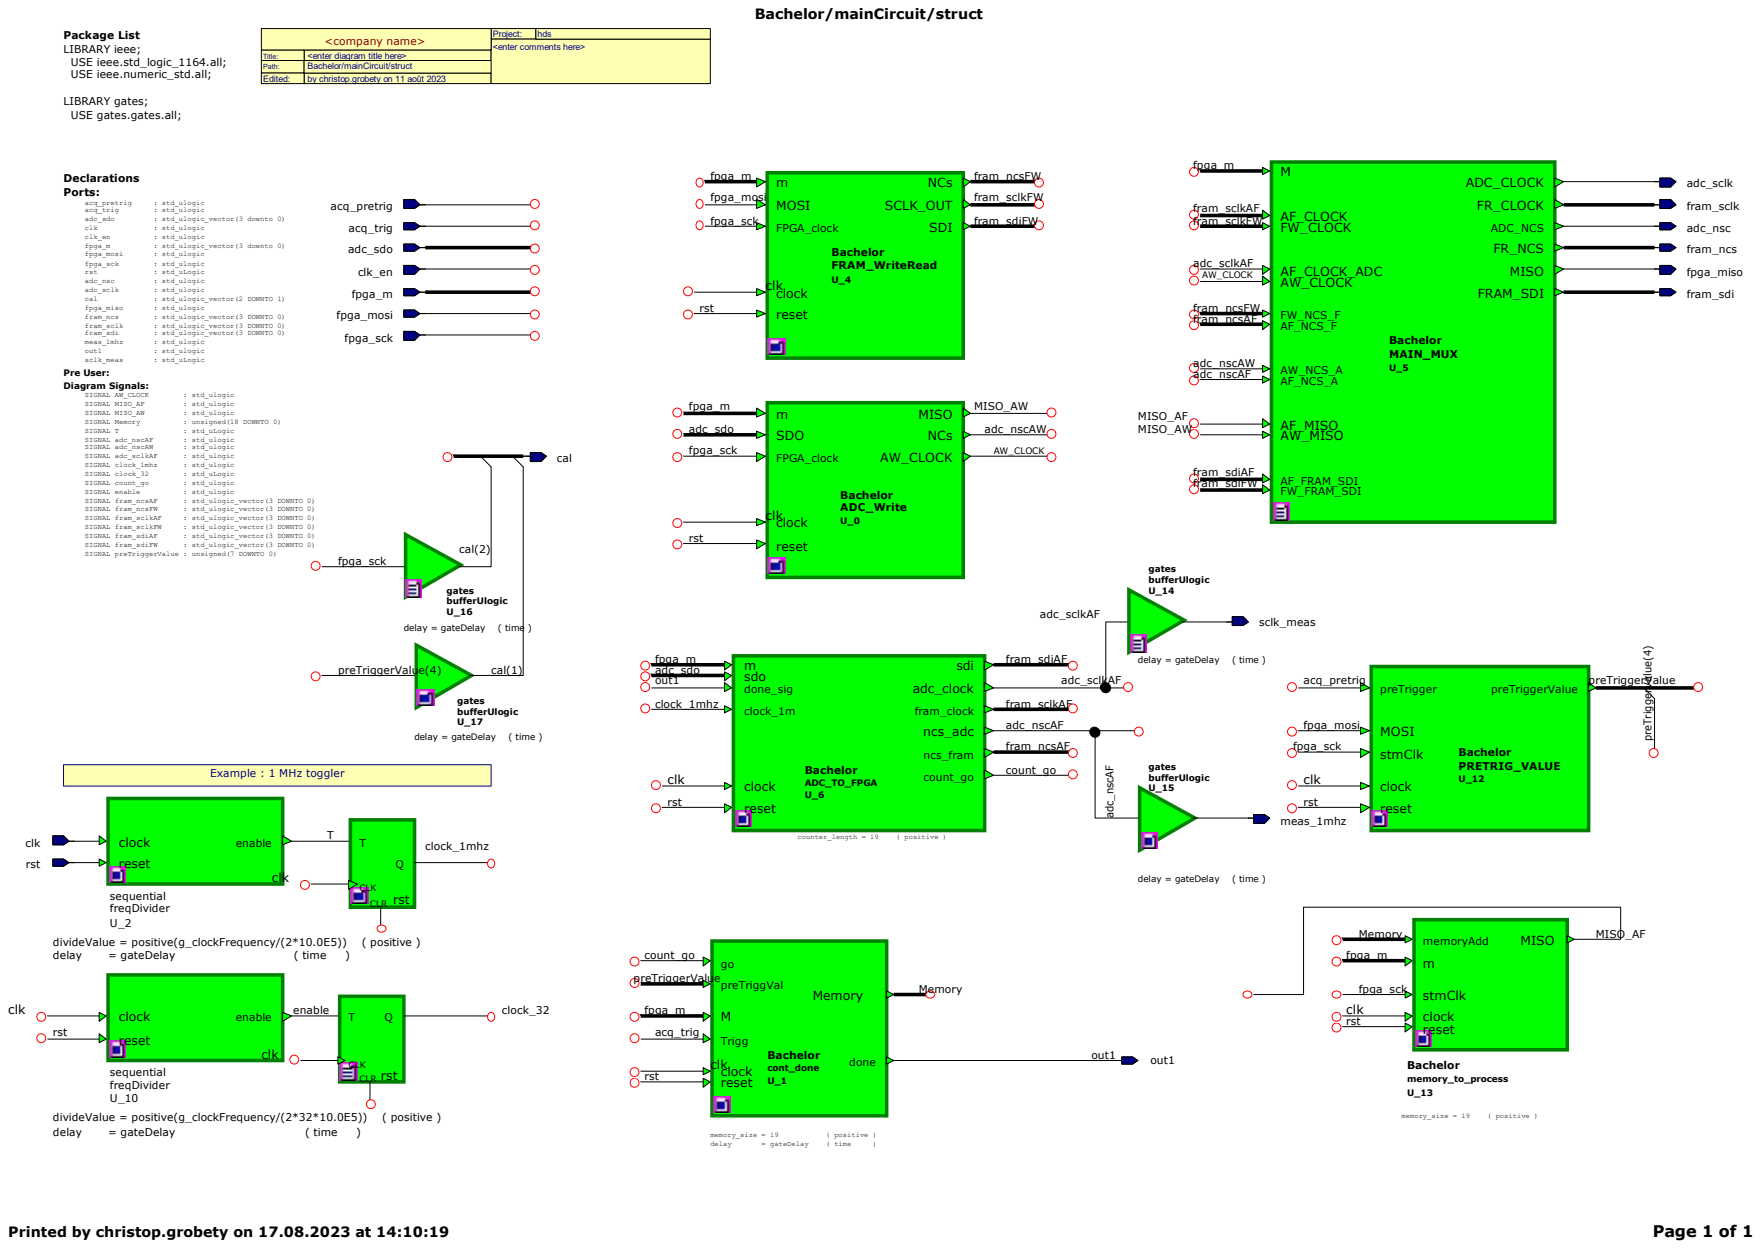
[picture p125: page 1]
clk; out1; gates bufferUlogic U_14; gates bufferUlogic U_15; MISO_AW; MISO_AF; adc_sdo; : std_ulogic_vector(3 downto 0); fpga_m; cal; : std_ulogic_vector(2 DOWNTO 1); fram_ncs; : std_ulogic_vector(3 DOWNTO 0); fram_sclk; fram_sdi; SIGNAL fram_sclkAF; SIGNAL fram_sclkFW; SIGNAL fram_sdiAF; SIGNAL fram_sdiFW; SIGNAL fram_ncsAF; SIGNAL adc_nscAW; : std_ulogic; SIGNAL fram_ncsFW; SIGNAL Memory; : unsigned(18 DOWNTO 0); Declarations Ports:; Pre User: Diagram Signals:; rst; : std_uLogic; acq_pretrig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

Package List
LIBRARY ieee;
USE ieee.std_logic_1164.all;
USE ieee.numeric_std.all;

hds <company name>

Project:
<enter comments here>

Title: | <enter diagram title here>
Path: | Bachelor/mainCircuit/struct
Edited: | by christop.grobety on 11 août 2023

LIBRARY gates;
USE gates.gates.all;

SIGNAL preTriggerValue : unsigned(7 DOWNTO 0)

delay = gateDelay ( time )

Example : 1 MHz toggler

divideValue = positive(g_clockFrequency/(2*10.0E5)) ( positive )

divideValue = positive(g_clockFrequency/(2*32*10.0E5)) ( positive )
