Drident/High_Speed_Data/DAILY_REPPORT/FPGA/CLock_divider.pdf

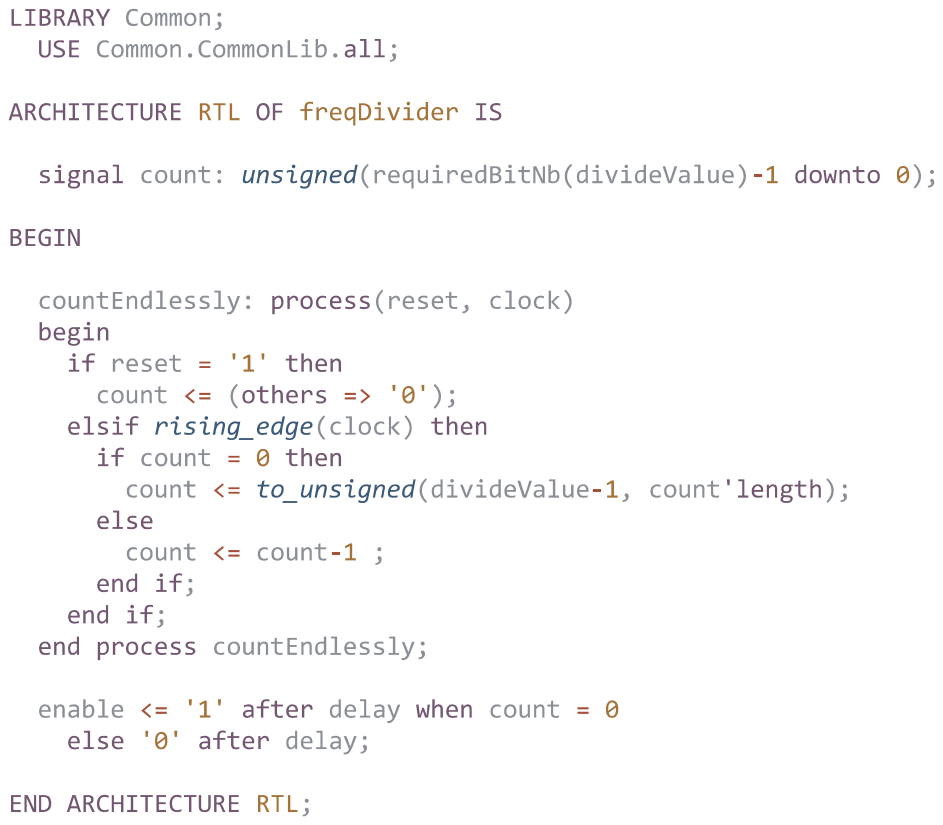
[picture p126: page 1]
