Drident/High_Speed_Data/DAILY_REPPORT/FPGA/count_done.pdf

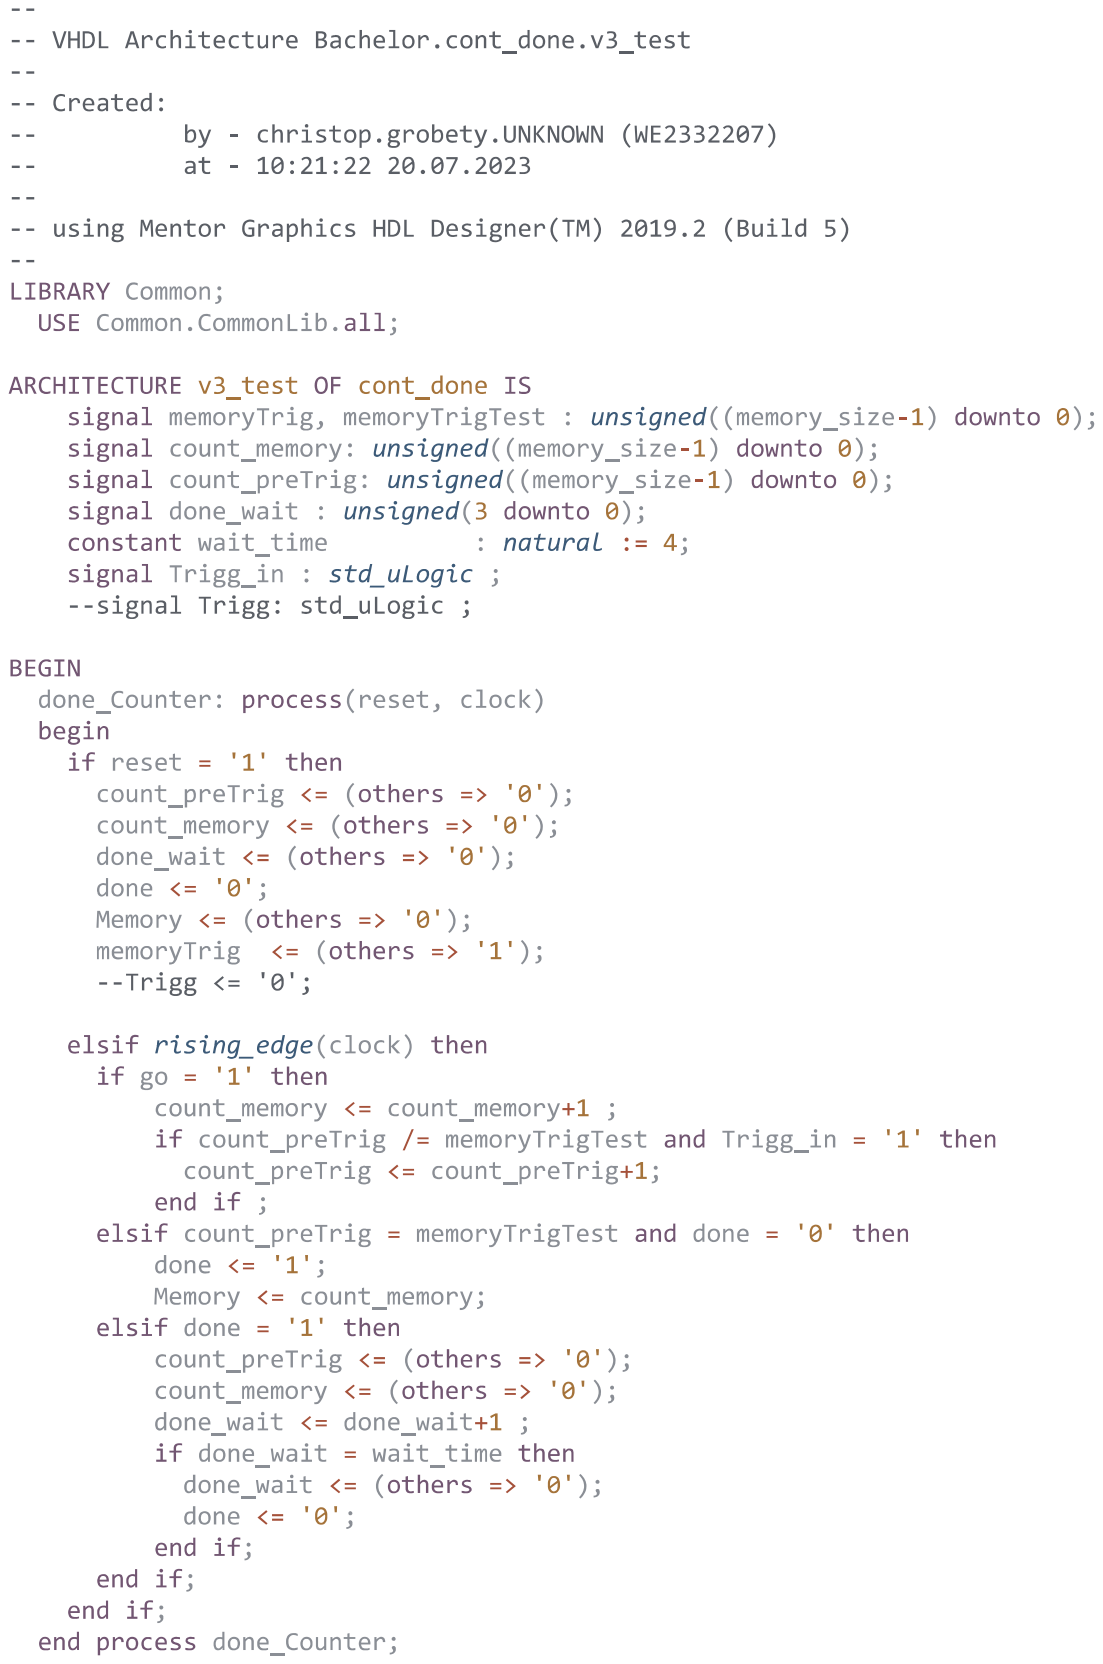
[picture p127: page 1]

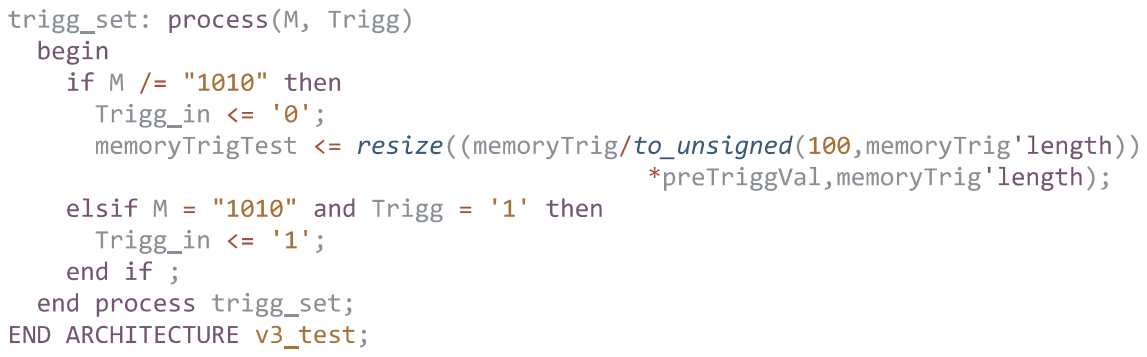
[picture p128: page 2]
