Drident/High_Speed_Data/DAILY_REPPORT/FPGA/fram_write.pdf

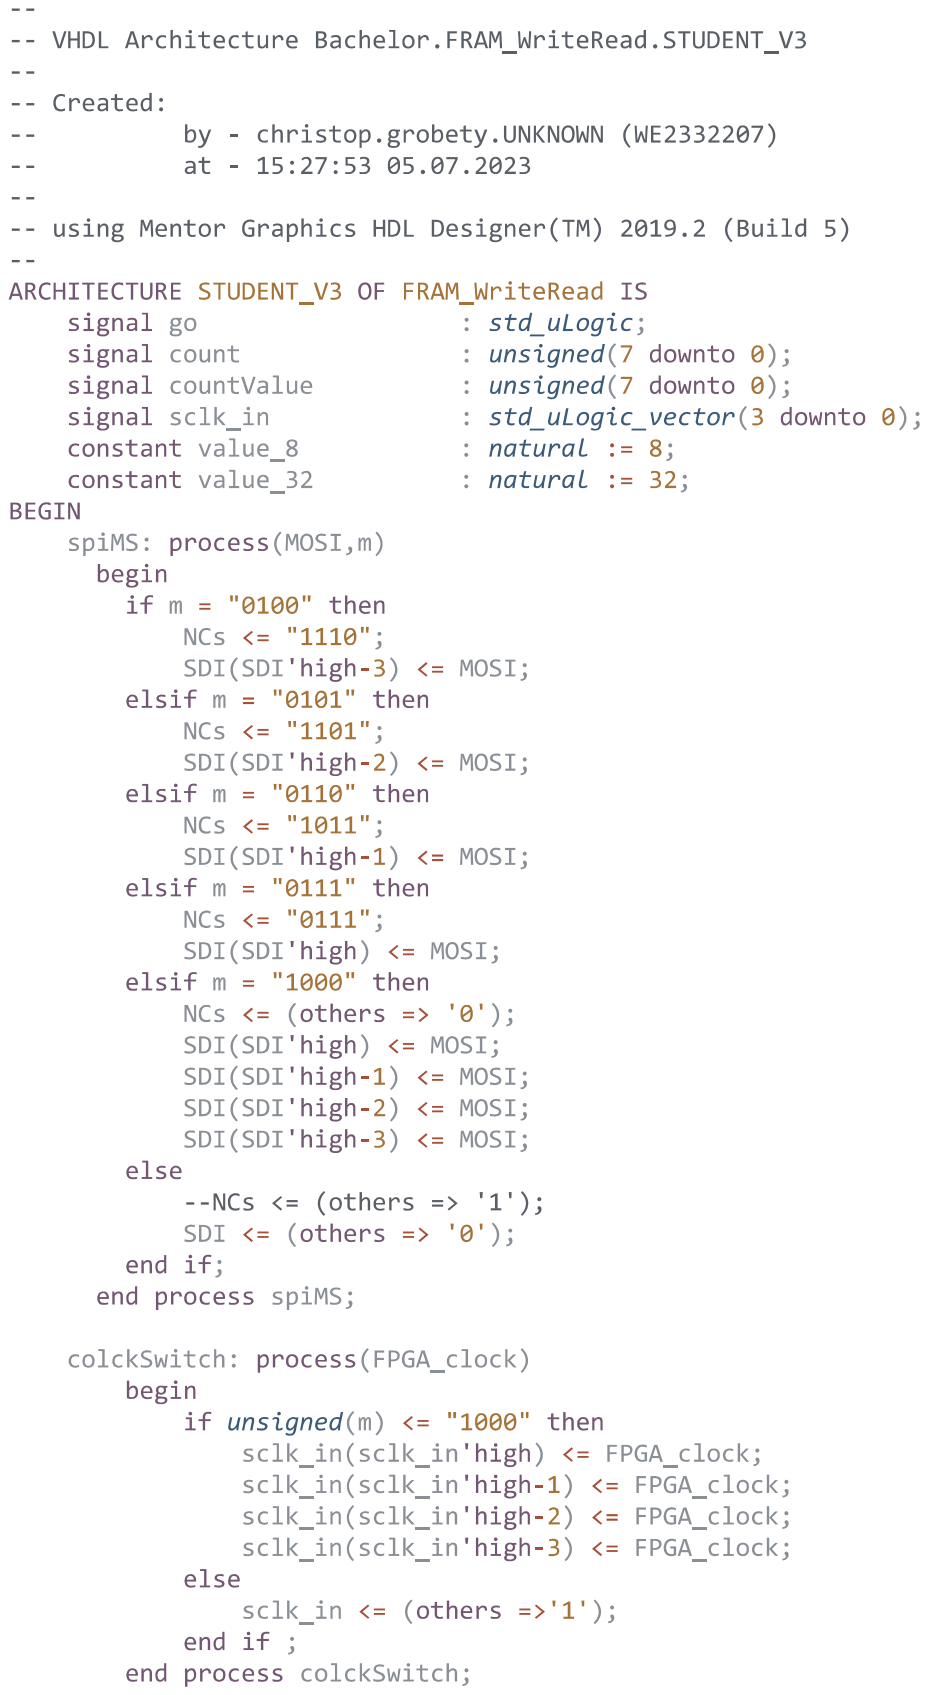
[picture p129: page 1]
