Drident/High_Speed_Data/DAILY_REPPORT/FPGA/memory_to_process.pdf

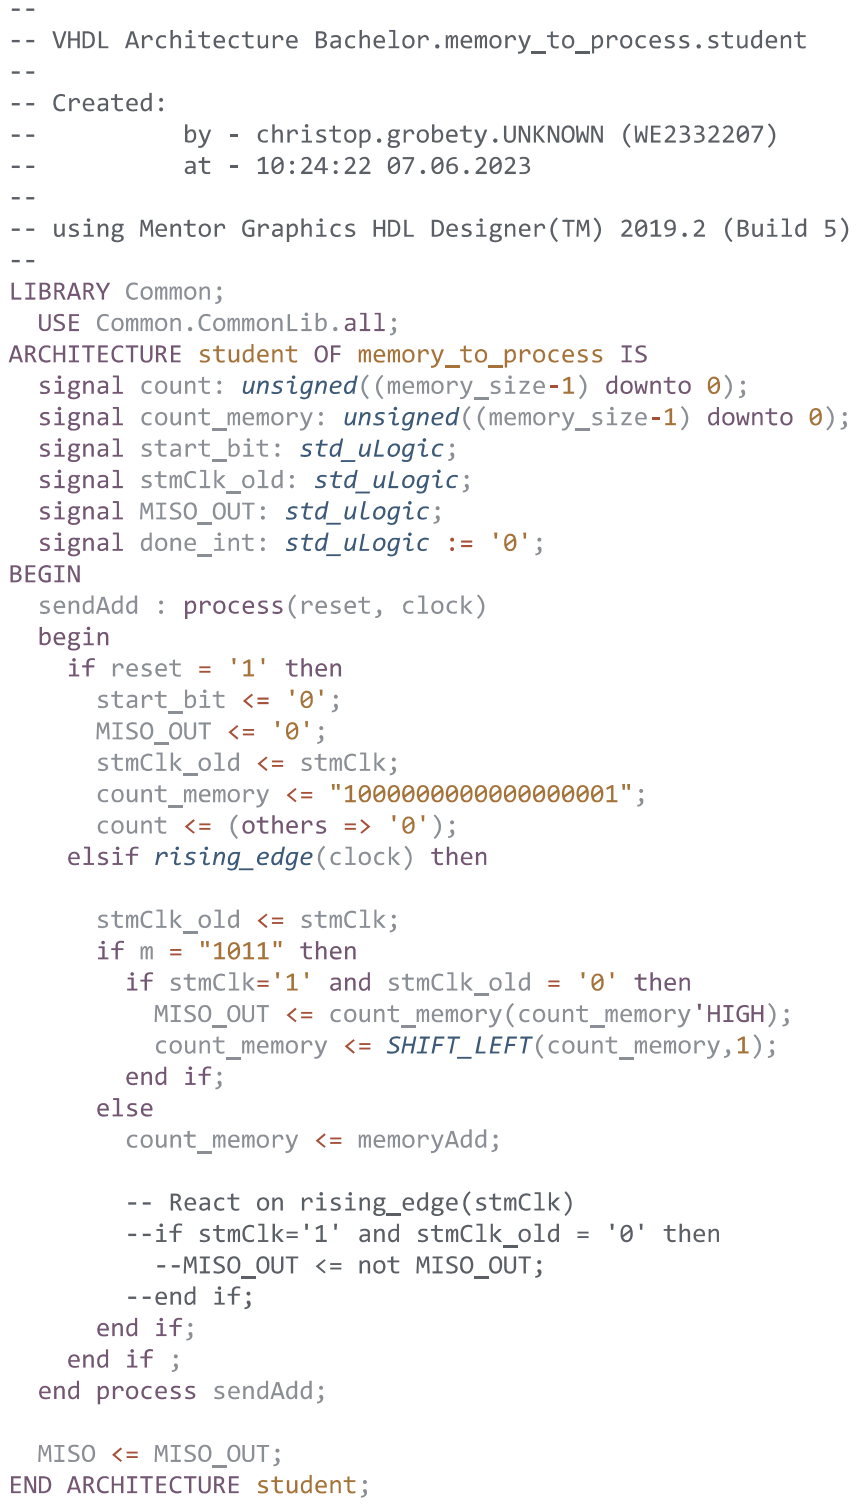
[picture p130: page 1]
