Drident/High_Speed_Data/DAILY_REPPORT/FPGA/mux.pdf

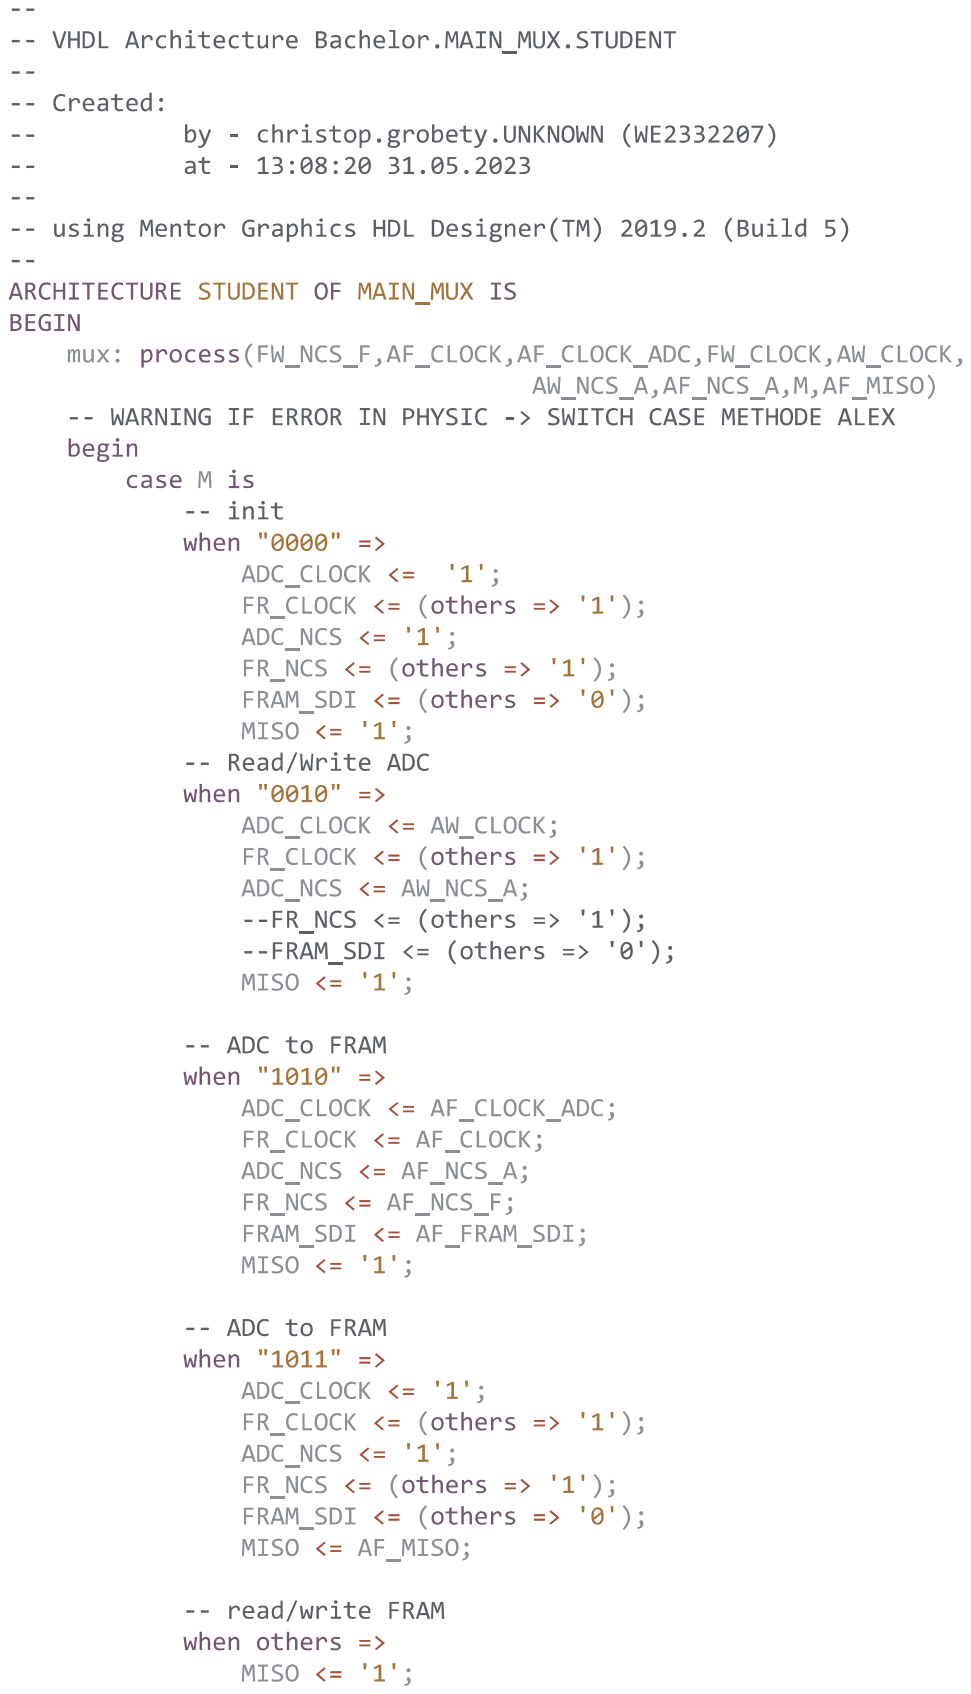
[picture p131: page 1]

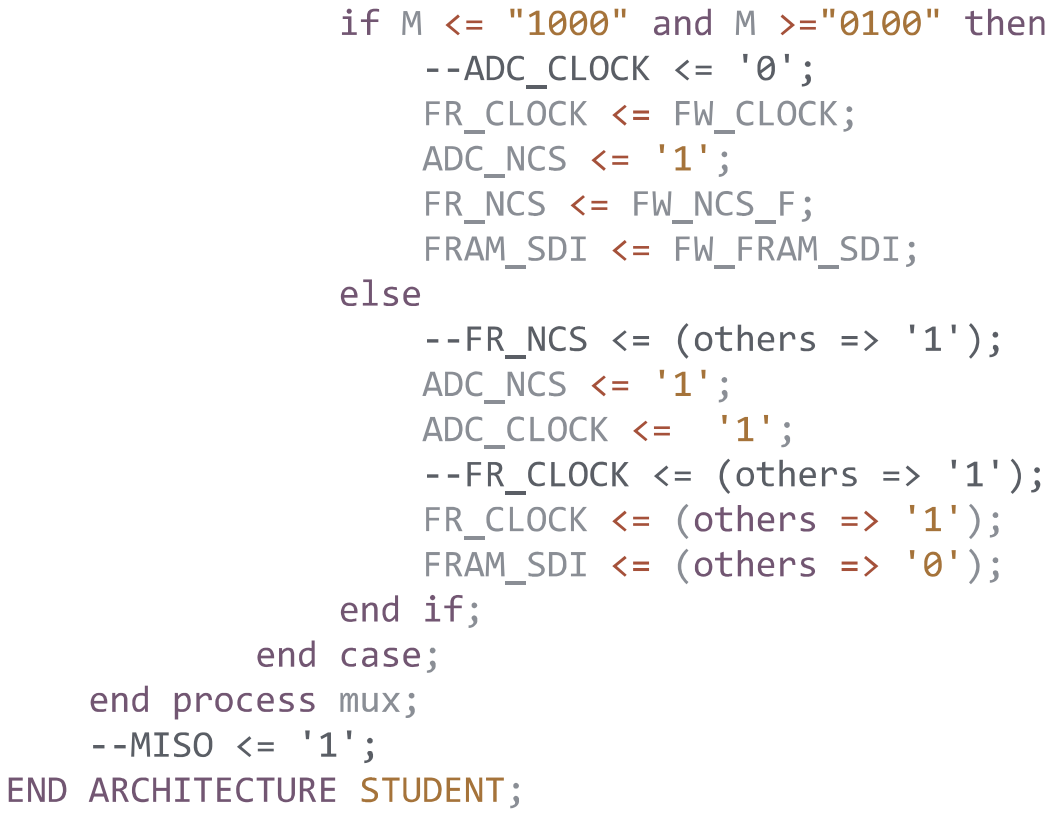
[picture p132: page 2]
