Drident/High_Speed_Data/DAILY_REPPORT/FPGA/pretrigg_value.pdf

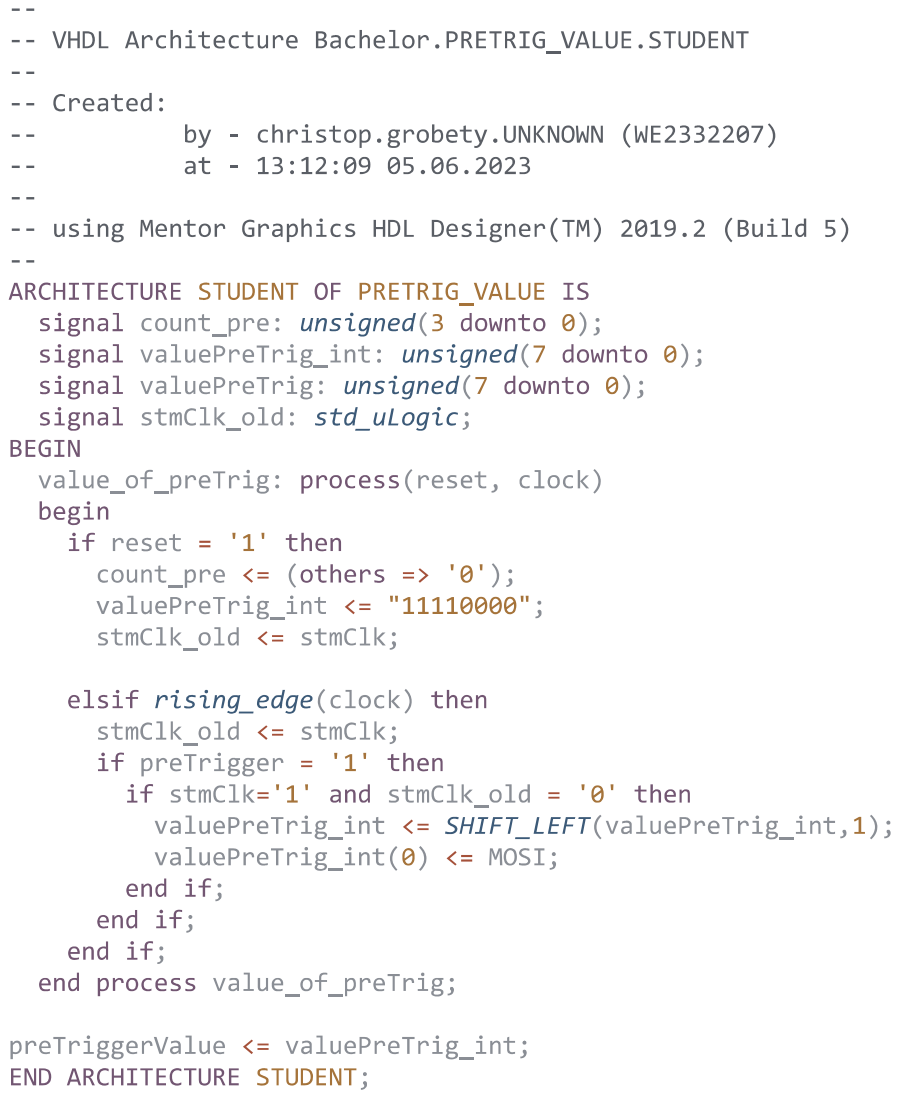
[picture p133: page 1]
