Drident/High_Speed_Data/TB_2023_Logger/LTspice/CurrentSource.asc

A1: ota; G=2e-3 Vhigh=24 Iout=10m
C1: cap; 10n
C2: cap; 10µ
M1: pmos; BSS84
M2: nmos; AO6408
R1: res; 10k
R2: res; 500
R3: res; 50
R4: res; 5k
R5: res; {100k*(1-t4)}
R6: res; {330k*(1-t6)}
R7: res; {100k*(1+t4)}
R8: res; {305.1k*(1+t6)}
R9: res; {12k*(1-t5)}
R10: res; {12.13k*(1+t5)}
R11: res; {RF}
R12: res; {RF}
R13: res; 100k
U1: UniversalOpamp2
V1: voltage; 28
V2: voltage; 3.3
V3: voltage; PULSE(0 3.3 0 1 1 1 3)
V4: voltage; 0; AC 1
V5: voltage; 1m
Named nets: 0, Vx, Vy, Vdd, Vctrl, Vout
.tran 1000m
.param RF=1Meg
;ac dec 1000 0.01 100k
.step param t2 -0.001 0.001 0.002
.step param t1 -0.001 0.001 0.002
.step param t3 -0.001 0.001 0.002
.step param t4 -0.001 0.001 0.001
.step param t5 -0.001 0.001 0.001
.step param t6 -0.001 0.001 0.001
.meas TRAN err1 AVG {V(vctrl)*20mA/3.3V+Id(M1)}
.params t4=0 t5=0 t6=0
