Drident/High_Speed_Data/TB_2023_Logger/LTspice/Draft2.asc

C1: cap; 10µ
I1: current; PULSE(10m 10m 1m 1u 1u 100m 200m)
R1: res; 15
R2: res; 220k
R3: res; 1Meg
R4: res; 1Meg
R5: res; 27k
U1: LT1017
V1: voltage; PULSE(3.6 2.5 0 100 100 0 200)
V2: voltage; 2.5
Named nets: 0, Vbatt
.tran 200
