Drident/High_Speed_Data/TB_2023_Logger/LTspice/Draft3.asc

C1: cap; 1n
C2: cap; 1n
C3: cap; 1n
C4: cap; 1n
D1: schottky; RSX071VYM-30
D2: schottky; RSX071VYM-30
M1: pmos; AO6407
M2: pmos; AO6407
M3: nmos; AO6408
R1: res; 1
R2: res; 100k
R3: res; 1k
R4: res; 120k
R5: res; 120k
R6: res; 22m
R7: res; 100k
R8: res; 3.6Meg
R9: res; 1k
R10: res; 100k
R11: res; 100k
R16: res; 1k
R17: res; 120k
R18: res; 120k
R19: res; 1k
R20: res; 100k
R21: res; 100k
U1: UniversalOpamp2
U2: UniversalOpamp2
V1: voltage; 1.5
V2: voltage; 5
V3: voltage; 3.6
V5: voltage; 1.5
Named nets: 0, Vb1, Vb2, Vbatt
.tran 1 startup
