Drident/High_Speed_Data/TB_2023_Logger/LTspice/InputFilter.asc

C1: cap; {C5}
C2: cap; {C2}
C3: cap; {C5}
C4: cap; {C2}
C5: cap; {C5b}
C6: cap; {C2b}
C7: cap; 22µ
C8: cap; 68p
C9: cap; 68p
C10: cap; 68p
C22: cap; 470p
R1: res; {R3}
R2: res; {R4}
R3: res; {R1}
R4: res; {R3}
R5: res; {R4}
R6: res; {R1}
R7: res; {R3b}
R8: res; {R4b}
R9: res; {R1b}
R10: res; 33
R11: res; 33
R12: res; {R3b+R4b}
R15: res; {Rs}
R29: res; 10k
R30: res; 10k
R31: res; 10k
R32: res; 10k
U2: LTC6362
U3: ADA4807-1
U6: ADA4807-1
V1: voltage; 3.3
V2: voltage; 1.25
V3: voltage; PULSE(0 2.4 10m 165n 153n 250u 500u)
V4: voltage; 3.3
V5: voltage; -3.3
V6: voltage; PULSE(1.2 0 10m 153n 165n 10 10)
V8: voltage; SINE(0 1.2 10k); AC 1
Named nets: 0, Vcc2, Vcm, Vcc, Vp, Vn, Vee, V1, V2, TrigL, IN
.params R1=2439.860498 R3=4908.681976 R4=4879.720995 C2=4.700000e-10 C5=1.000000e-10
.params R1b=4375.658237 R3b=3783.601933 R4b=4375.658237 C2b=1.000000e-09 C5b=6.800000e-11
;ac dec 1000 0.03 10Meg
.tran 100m
;noise V(Vp,Vn) V3 dec 1000 1 10Meg
.param Rs=300
.step param Rs 1 400 399
.params RR1=3.3k RR2=3.3k
