Drident/High_Speed_Data/TB_2023_Logger/LTspice/InputFilter2.asc

C7: cap; 22µ
C22: cap; 470p
R2: res; 2k
R3: res; 1k
R5: res; 2k
R6: res; 1k
R8: res; 2k
R9: res; 2k
R10: res; 33
R11: res; 33
R12: res; 2k
R15: res; {Rs}
R29: res; 10k
R30: res; 10k
R31: res; 10k
R32: res; 10k
U2: LTC6362
U3: ADA4807-1
U6: ADA4807-1
V1: voltage; 3.3
V2: voltage; 1.25
V5: voltage; -3.3
V8: voltage; SINE(0 1.2 10k); AC 1
Named nets: Vcc, Vcm, 0, Vp, Vn, Vee, V1, V2, TrigL, IN
.tran 100m
;noise V(Vp,Vn) V3 dec 1000 1 10Meg
.param Rs=300
