Drident/High_Speed_Data/TB_2023_Logger/LTspice/InputFilter3.asc

C1: cap; 22p
C2: cap; 22p
C3: cap; 470pF
C7: cap; 22µ
R1: res; 1k
R2: res; 2k
R3: res; 1k
R4: res; 1
R5: res; 2k
R6: res; 1k
R7: res; 100k
R8: res; 1
R9: res; 10k
R10: res; 33
R11: res; 33
R12: res; 10k
R13: res; 10k
R14: res; 10k
R15: res; {Rs}
U1: ADA4500
U2: LTC6362
U3: ADA4500
V1: voltage; 3.3
V2: voltage; 1.25
V5: voltage; -3.3
V8: voltage; SINE(0 1.2 100k); AC 1
Named nets: Vcm, 0, Vcc, Vp, Vn, Vee, IN, V1, V2, Vtrig
.tran 100m
;noise V(Vp,Vn) V8 dec 1000 0.3 1Meg
.param Rs=300
;ac dec 1000 10m 10Meg
