Drident/High_Speed_Data/(list of files, drawings)

Other design files:
AltiumLibs/ECSlib.PcbLib
AltiumLibs/ECSlib.SchLib
AltiumLibs/SLM-107-01-G-S/SAMTEC_SLM-107-01-G-S.PcbLib
AltiumLibs/SLM-107-01-G-S/SLM-107-01-G-S.SchLib
AltiumLibs/TMS-107-01-L-S/SnapEDApcb.PcbLib
AltiumLibs/TMS-107-01-L-S/SnapEDAsch.SchLib
TB_2023_Logger/PCB/PCB/BalEv_v1.test/BalEv.PcbDoc
TB_2023_Logger/PCB/PCB/BalEv_v1.test/BalEv.PrjPcb
TB_2023_Logger/PCB/PCB/BalEv_v1.test/BalEv_ADC_v1_0.SchDoc
TB_2023_Logger/PCB/PCB/BalEv_v1.test/BalEv_AIN_v1_0.SchDoc
TB_2023_Logger/PCB/PCB/BalEv_v1.test/BalEv_AINa_v1_0.SchDoc
TB_2023_Logger/PCB/PCB/BalEv_v1.test/BalEv_AINb_v1_0.SchDoc
TB_2023_Logger/PCB/PCB/BalEv_v1.test/BalEv_FPTG_Bank0_v1_0.SchDoc
TB_2023_Logger/PCB/PCB/BalEv_v1.test/BalEv_FPTG_IO_v1_0.SchDoc
TB_2023_Logger/PCB/PCB/BalEv_v1.test/BalEv_FPTG_POW_COFIG_v1_0.SchDoc
TB_2023_Logger/PCB/PCB/BalEv_v1.test/BalEv_SD_card_v1_0.SchDoc
TB_2023_Logger/PCB/PCB/BalEv_v1.test/BalEv_STM_v1_0.SchDoc
TB_2023_Logger/PCB/PCB/BalEv_v1.test/BalEv_USB_v1_0.SchDoc
TB_2023_Logger/PCB/PCB/BalEv_v1/BalEv.PrjPcb
TB_2023_Logger/PCB/PCB/BalEv_v1/BalEv_ADC_v1_0.SchDoc
TB_2023_Logger/PCB/PCB/BalEv_v1/BalEv_AIN_v1_0.SchDoc
TB_2023_Logger/PCB/PCB/BalEv_v1/BalEv_AINa_v1_0.SchDoc
TB_2023_Logger/PCB/PCB/BalEv_v1/BalEv_AINb_v1_0.SchDoc
TB_2023_Logger/PCB/PCB/BalEv_v1/BalEv_FPTG_Bank0_v1_0.SchDoc
TB_2023_Logger/PCB/PCB/BalEv_v1/BalEv_FPTG_IO_v1_0.SchDoc
TB_2023_Logger/PCB/PCB/BalEv_v1/BalEv_FPTG_POW_COFIG_v1_0.SchDoc
TB_2023_Logger/PCB/PCB/BalEv_v1/BalEv_Mechanic_v1_0.SchDoc
TB_2023_Logger/PCB/PCB/BalEv_v1/BalEv_SD_card_v1_0.SchDoc
TB_2023_Logger/PCB/PCB/BalEv_v1/BalEv_STM_v1_0.SchDoc
TB_2023_Logger/PCB/PCB/BalEv_v1/BalEv_USB_v1_0.SchDoc
TB_2023_Logger/PCB/PCB/FRAM_PCB/FRAM.PcbDoc
TB_2023_Logger/PCB/PCB/FRAM_PCB/FRAM.PrjPcb
TB_2023_Logger/PCB/PCB/FRAM_PCB/FRAM.SchDoc
TB_2023_Logger/PCB/PCB/test/BalEv.PrjPcb
TB_2023_Logger/PCB/PCB/test/BalEv_ADC_v1_0.SchDoc
TB_2023_Logger/PCB/PCB/test/BalEv_AIN_v1_0.SchDoc
TB_2023_Logger/PCB/PCB/test/BalEv_AINa_v1_0.SchDoc
TB_2023_Logger/PCB/PCB/test/BalEv_AINb_v1_0.SchDoc
TB_2023_Logger/PCB/PCB/test/BalEv_FPTG_Bank0_v1_0.SchDoc
TB_2023_Logger/PCB/PCB/test/BalEv_FPTG_IO_v1_0.SchDoc
TB_2023_Logger/PCB/PCB/test/BalEv_FPTG_POW_COFIG_v1_0.SchDoc
TB_2023_Logger/PCB/PCB/test/BalEv_Mechanic_v1_0.SchDoc
TB_2023_Logger/PCB/PCB/test/BalEv_SD_card_v1_0.SchDoc
TB_2023_Logger/PCB/PCB/test/BalEv_STM_v1_0.SchDoc
TB_2023_Logger/PCB/PCB/test/BalEv_USB_v1_0.SchDoc
