Drident/High_Speed_Data/TB_2023_Logger/Cube/work/STM32CubeIDE-high_speed/Core/Src/main.c

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
/* Includes ------------------------------------------------------------------*/
#include "main.h"
#include "fatfs.h"

/* USER CODE BEGIN Includes */

#include "fram_func.h"
#include "sd_card_func.h"
/* USER CODE END Includes */

/* USER CODE BEGIN PD */
//#define MEMORY_SIZE	524288
/* USER CODE END PD */

 DAC_HandleTypeDef hdac1;

I2C_HandleTypeDef hi2c1;
I2C_HandleTypeDef hi2c2;

SD_HandleTypeDef hsd1;

SPI_HandleTypeDef hspi1;
SPI_HandleTypeDef hspi2;
DMA_HandleTypeDef hdma_spi1_rx;
DMA_HandleTypeDef hdma_spi1_tx;

TIM_HandleTypeDef htim16;

UART_HandleTypeDef huart1;

HCD_HandleTypeDef hhcd_USB_OTG_FS;

void SystemClock_Config(void);
static void MX_GPIO_Init(void);
static void MX_DAC1_Init(void);
static void MX_SDMMC1_SD_Init(void);
static void MX_SPI1_Init(void);
static void MX_USART1_UART_Init(void);
static void MX_I2C1_Init(void);
static void MX_I2C2_Init(void);
static void MX_SPI2_Init(void);
static void MX_DMA_Init(void);
static void MX_USB_OTG_FS_HCD_Init(void);
static void MX_TIM16_Init(void);
/* USER CODE BEGIN 0 */
const uint32_t TAB_SIZE = (MEMORY_SIZE/16);
enum color_Led LED_STATE = OFF;
bool reset = true;
bool start = true;
bool acqu = true;
/* USER CODE END 0 */

/**
  * @brief  The application entry point.
  * @retval int
  */
int main(void)
{
  /* USER CODE BEGIN 1 */
	//FRESULT res; /* FatFs function common result code */
	TCHAR* fileName0 ;
	TCHAR* fileName1 ;
	TCHAR* fileName2 ;
	TCHAR* fileName3 ;
	TCHAR* file_Init = "INIT.txt";
	uint8_t	 TX_Data_ADC[2];
	uint8_t  TX_FRAM_TEST_R[10] ;
	uint16_t DATA_SD;
	uint16_t DATA_ind [TAB_SIZE/2];
	uint8_t pretrigValue = 100;


	//uint8_t  RX_DATA [524288];   -> TOO BIG

  /* USER CODE END 1 */

  /* MCU Configuration--------------------------------------------------------*/

  /* Reset of all peripherals, Initializes the Flash interface and the Systick. */
  HAL_Init();

  /* Configure the system clock */
  SystemClock_Config();

  /* Initialize all configured peripherals */
  MX_GPIO_Init();
  MX_DAC1_Init();
  MX_SDMMC1_SD_Init();
  MX_SPI1_Init();
  MX_USART1_UART_Init();
  MX_I2C1_Init();
  MX_I2C2_Init();
  MX_SPI2_Init();
  MX_DMA_Init();
  MX_USB_OTG_FS_HCD_Init();
  MX_FATFS_Init();
  MX_TIM16_Init();
  /* Infinite loop */
  /* USER CODE BEGIN WHILE */
   uint8_t start_Add[4] ;
   uint32_t start_Add_tot = 0 ;
   uint32_t Add_= 0;
   uint8_t TX_32 = 0;
   uint16_t boucle = 0;
   uint8_t wtext_0 [100] ;
   uint8_t wtext_1 [100] ;
   uint8_t wtext_2 [100] ;
   uint8_t wtext_3 [100] ;
   uint8_t* receive;
   uint8_t chann;
   double* dataInit_;
   double triggDacValue;
   PIN_reset();
   //FRAM_device(hspi1);
  while (1)
  {
	acqu = true;
	TX_32 = 0;
	start = true;
	HAL_SuspendTick();
	__WFI();

	//--------------------------------------------------RESET FPGA----------------------------------------
	HAL_GPIO_WritePin(FPGA_RESET_GPIO_Port, FPGA_RESET_Pin, GPIO_PIN_RESET);
	HAL_Delay(100);
	HAL_GPIO_WritePin(FPGA_RESET_GPIO_Port, FPGA_RESET_Pin, GPIO_PIN_SET);
	//--------------------------------------------------RESET M---------------------------------------
	PIN_reset();
	//----------------------------------------------------------INIT-------------------------------------------
	//-------------------init file sd --------------------------------------
	sprintf((char*)wtext_0, "FRAM0_%d.bin",boucle);
	fileName0 = (TCHAR*)wtext_0;
	SD_create_file(SDFile, fileName0);
	sprintf((char*)wtext_1, "FRAM1_%d.bin",boucle);
	fileName1 = (TCHAR*)wtext_1;
	SD_create_file(SDFile, fileName1);
	sprintf((char*)wtext_2, "FRAM2_%d.bin",boucle);
	fileName2 = (TCHAR*)wtext_2;
	SD_create_file(SDFile, fileName2);
	sprintf((char*)wtext_3, "FRAM3_%d.bin",boucle);
	fileName3 = (TCHAR*)wtext_3;
	SD_create_file(SDFile, fileName3);

	//-------------------init value------------------------------------------------------------------------
	dataInit_ = initValue(SDFile, file_Init);

	chann = (uint8_t)dataInit_[0];
	if(chann >4){
		chann = 0;
	}
	triggDacValue = dataInit_[1]*(0.02)+1;
	if(triggDacValue <1 || triggDacValue>3.3){
		triggDacValue = 1;
	}
	pretrigValue = (uint8_t)dataInit_[2];
	if(pretrigValue >100){
		pretrigValue = 100;
	}
	//--------------------------------------------------LED CONTROL----------------------------------------
	if(LED_STATE != RED){
		LED_on(BLUE);
	}
	else{
		while(1){
			//reset the systeme
		}
	}

	//-------------------init trigg dc value--------------------------------
	uint32_t triggDac = (uint32_t)((triggDacValue/VREF_VOLTAGE)*DAC_MAX_VALUE);
	HAL_DAC_SetValue(&hdac1, DAC1_CHANNEL_2, DAC_ALIGN_12B_R, triggDac);
	HAL_DAC_Start(&hdac1, DAC1_CHANNEL_2);
	HAL_DAC_SetValue(&hdac1, DAC1_CHANNEL_1, DAC_ALIGN_12B_R, triggDac);
	HAL_DAC_Start(&hdac1, DAC1_CHANNEL_1);

	//-------------------init pretrigg value--------------------------------
	HAL_SPI_Transmit(&hspi1, (uint8_t*)&pretrigValue,1, 100);
	HAL_GPIO_WritePin(FPGA_PRETRIG_GPIO_Port, FPGA_PRETRIG_Pin, GPIO_PIN_SET);
	HAL_SPI_Transmit(&hspi1, (uint8_t*)&pretrigValue,1, 100);
	HAL_GPIO_WritePin(FPGA_PRETRIG_GPIO_Port, FPGA_PRETRIG_Pin, GPIO_PIN_RESET);

	//-------------------init trigg channel --------------------------------------
	setTriggChannel(chann);
	//--------------------------------------------------RESET FRAM REG----------------------------------------
	FRAM_reset_reg(hspi1);
	//--------------------------------------------------WRITE FRAM REG----------------------------------------
	FRAM_write_reg(hspi1);
	//--------------------------------------------------ADC WRITE REG-----------------------------------------
	TX_Data_ADC[0] = 0xA2;
	TX_Data_ADC[1] = 0x80;
	HAL_GPIO_WritePin(SELECTOR_M1_GPIO_Port, SELECTOR_M1_Pin, GPIO_PIN_SET);
	HAL_SPI_Transmit(&hspi1, (uint8_t*)TX_Data_ADC,2, 100);
	HAL_GPIO_WritePin(SELECTOR_M1_GPIO_Port, SELECTOR_M1_Pin, GPIO_PIN_RESET);
	HAL_Delay(100);

	//---------------------------------------------------WRITE FRAM-------------------------------------------
	PIN_reset();
	TX_FRAM_TEST_R[0] = 2;
	for(int i =1; i<5;i++){
	  TX_FRAM_TEST_R[i] = 0;
	}
	TX_FRAM_TEST_R[3] = 0;
	TX_FRAM_TEST_R[4] = 0;
	TX_FRAM_TEST_R[5] = 56;

	HAL_GPIO_WritePin(SELECTOR_M3_GPIO_Port, SELECTOR_M3_Pin, GPIO_PIN_SET);
	HAL_SPI_Transmit(&hspi1, (uint8_t*)TX_FRAM_TEST_R,6, 100);
	HAL_Delay(100);

	//---------------------------------------------------ADC TO FRAM--------------------------------------------
	HAL_GPIO_WritePin(SELECTOR_M1_GPIO_Port, SELECTOR_M1_Pin, GPIO_PIN_SET);
	//---------------------------------------------------SLEEP MODE--------------------------------------------
	//HAL_PWR_EnterSLEEPMode(PWR_LOWPOWERREGULATOR_ON, PWR_SLEEPENTRY_WFI);
	while(acqu){
		HAL_SuspendTick();
		__WFI();
	}
	//HAL_PWR_ENTER
	PIN_reset();
	while(TX_32 <16) {
		  if(TX_32 == 0){
			  PIN_reset();
			  HAL_GPIO_WritePin(SELECTOR_M0_GPIO_Port, SELECTOR_M0_Pin, GPIO_PIN_SET);
			  HAL_GPIO_WritePin(SELECTOR_M1_GPIO_Port, SELECTOR_M1_Pin, GPIO_PIN_SET);
			  HAL_GPIO_WritePin(SELECTOR_M3_GPIO_Port, SELECTOR_M3_Pin, GPIO_PIN_SET);
			  HAL_SPI_Receive(&hspi1, (uint8_t*)start_Add,4, 100);
			  HAL_Delay(100);
			  start_Add_tot = (((uint32_t)start_Add[0])<<24)+(((uint32_t)start_Add[1])<<16)
										+(((uint32_t)start_Add[2])<<8)+((uint32_t)start_Add[3]);
			  PIN_reset();
			  start_Add_tot = start_Add_tot>>12;
			  //start_Add_tot = 0;
			  HAL_TIM_Base_Start_IT(&htim16);
		  }
		 //---------------------------------------------------READ FRAM 0--------------------------------------------
		 for(uint32_t i = 0; i<(TAB_SIZE/2) ; i++){
			  Add_ = i*2+TAB_SIZE*TX_32+(MEMORY_SIZE);
			  if(Add_> MEMORY_SIZE){
				  Add_ = Add_ - MEMORY_SIZE;
			  }
			  //receive = FRAM_read(FRAM_0,i*2+TAB_SIZE*TX_32, hspi1, 2);
			 receive = FRAM_read(FRAM_0, Add_, hspi1, 2);
			 DATA_SD = (((uint16_t)receive[0])<<8)+(uint16_t)(receive[1]);
			 // DATA_SD = (((uint16_t)RX_FAST[i*2])<<8)+(uint16_t)(RX_FAST[i*2+1]);
			  DATA_ind[i] = DATA_SD;
		  }
		  SD_write_data(SDFile, fileName0, DATA_ind);
		  //---------------------------------------------------READ FRAM 1--------------------------------------------
		  for(uint32_t i = 0; i<(TAB_SIZE/2) ; i++){
			  Add_ = i*2+TAB_SIZE*TX_32+(MEMORY_SIZE);
			  if(Add_> MEMORY_SIZE){
				  Add_ = Add_ - MEMORY_SIZE;
			  }
			  receive = FRAM_read(FRAM_1, Add_, hspi1, 2);
			  DATA_SD = (((uint16_t)receive[0])<<8)+(uint16_t)(receive[1]);
			  //DATA_SD = (short)DATA_SD;
			  DATA_ind[i] = DATA_SD;
		  }
		  SD_write_data(SDFile, fileName1, DATA_ind);
		  //---------------------------------------------------READ FRAM 2--------------------------------------------
		  for(uint32_t i = 0; i<TAB_SIZE/2 ; i++){
			  Add_ = i*2+TAB_SIZE*TX_32+(MEMORY_SIZE-start_Add_tot);
			  if(Add_> MEMORY_SIZE){
				  Add_ = Add_ - MEMORY_SIZE;
			  }
			  receive = FRAM_read(FRAM_2,Add_, hspi1, 2);
			  DATA_SD = (((uint16_t)receive[0])<<8)+(uint16_t)(receive[1]);
			  //DATA_SD = (short)DATA_SD;
			  DATA_ind[i] = DATA_SD;
		  }
		  SD_write_data(SDFile, fileName2, DATA_ind);
		  //---------------------------------------------------READ FRAM 3--------------------------------------------
		  for(uint32_t i = 0; i<TAB_SIZE/2 ; i++){
			  Add_ = i*2+TAB_SIZE*TX_32+(MEMORY_SIZE-start_Add_tot);
			  if(Add_> MEMORY_SIZE){
				  Add_ = Add_ - MEMORY_SIZE;
			  }
			  receive = FRAM_read(FRAM_3,Add_, hspi1, 2);
			  DATA_SD = (((uint16_t)receive[0])<<8)+(uint16_t)(receive[1]);
			  //DATA_SD = (short)DATA_SD;
			  DATA_ind[i] = DATA_SD;
		  }
		  SD_write_data(SDFile, fileName3, DATA_ind);
		  TX_32++;
		  //receive = FRAM_read(FRAM_3, TX_32, hspi1, 2);
		  //DATA_SD = (((uint16_t)receive[0])<<8)+(uint16_t)(receive[1]);
		  //DATA_SD = (short)DATA_SD;
		  //SD_write_data(SDFile, fileName3, DATA_SD);
	  }
	  if(TX_32==16){
		  HAL_TIM_Base_Stop(&htim16);
		  if(LED_STATE != RED){
			  LED_off();
		  	  LED_on(GREEN); //6
		  }
		  else{
			  LED_off();
			  LED_on(RED);
		  }
	  }
	  boucle++;
    /* USER CODE END WHILE */

    /* USER CODE BEGIN 3 */
  }
  /* USER CODE END 3 */
}

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
/* USER CODE BEGIN 4 */
#ifdef __GNUC__
  /* With GCC, small printf (option LD Linker->Libraries->Small printf
     set to 'Yes') calls __io_putchar() */
int __io_putchar(int ch)
#else
int fputc(int ch, FILE *f)
#endif /* __GNUC__ */
{
  /* Place your implementation of fputc here */
  /* e.g. write a character to the UART3 and Loop until the end of transmission */
  HAL_UART_Transmit(&huart1, (uint8_t *)&ch, 1, HAL_MAX_DELAY);
  return ch;
}
void HAL_TIM_PeriodElapsedCallback(TIM_HandleTypeDef *htim){
	if(htim== &htim16){
		HAL_GPIO_TogglePin(UI_LED_B_GPIO_Port, UI_LED_B_Pin);
	}
}
/* USER CODE END 4 */
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
