Drident/High_Speed_Data/TB_2023_Logger/Cube/Cube.ioc

Mcu.UserName=STM32L496RGTx
PA0.GPIO_Label=SELECTOR_M0
PA0.Signal=GPIO_Output
PA1.GPIO_Label=STM_FPGA_SCK
PA1.Signal=SPI1_SCK
PA10.GPIO_Label=USB_VBUS_INT
PA10.Signal=GPXTI10
PA11.Signal=USB_OTG_FS_DM
PA12.Signal=USB_OTG_FS_DP
PA2.GPIO_Label=SELECTOR_M1
PA2.Signal=GPIO_Output
PA3.GPIO_Label=SELECTOR_M2
PA3.Signal=GPIO_Output
PA4.Signal=COMP_DAC11_group
PA5.Signal=COMP_DAC12_group
PA6.GPIO_Label=STM_FPGA_MISO
PA6.Signal=SPI1_MISO
PA7.GPIO_Label=STM_FPGA_MOSI
PA7.Signal=SPI1_MOSI
PA8.GPIO_Label=SELECTOR_M3
PA8.Signal=GPIO_Output
PA9.Signal=USART1_TX
PB0.GPIO_Label=UI_LED_G
PB0.Signal=GPIO_Output
PB1.GPIO_Label=UI_LED_R
PB1.Signal=GPIO_Output
PB10.GPIO_Label=STM_UI_SCK
PB10.Signal=SPI2_SCK
PB11.Signal=I2C2_SDA
PB13.Signal=I2C2_SCL
PB2.GPIO_Label=UI_LED_B
PB2.Signal=GPIO_Output
PB6.Signal=I2C1_SCL
PB7.Signal=USART1_RX
PB9.Signal=I2C1_SDA
PC1.GPIO_Label=STM_UI_MOSI
PC1.Signal=SPI2_MOSI
PC10.Signal=SDMMC1_D2
PC11.Signal=SDMMC1_D3
PC12.Signal=SDMMC1_CK
PC7.GPIO_Label=SD_Detect_INT
PC7.Signal=GPXTI7
PC8.Signal=SDMMC1_D0
PC9.Signal=SDMMC1_D1
PD2.Signal=SDMMC1_CMD
