Drident/High_Speed_Data/TB_2023_Logger/Cube/work/STM32CubeIDE-high_speed/Core/Inc/main.h

#define WAKE_UP_Pin GPIO_PIN_13
#define WAKE_UP_GPIO_Port GPIOC
#define WAKE_UP_EXTI_IRQn EXTI15_10_IRQn
#define FPGA_RESET_Pin GPIO_PIN_0
#define FPGA_RESET_GPIO_Port GPIOC
#define STM_UI_MOSI_Pin GPIO_PIN_1
#define STM_UI_MOSI_GPIO_Port GPIOC
#define FPGA_PRETRIG_Pin GPIO_PIN_2
#define FPGA_PRETRIG_GPIO_Port GPIOC
#define SELECTOR_M0_Pin GPIO_PIN_0
#define SELECTOR_M0_GPIO_Port GPIOA
#define STM_FPGA_SCK_Pin GPIO_PIN_1
#define STM_FPGA_SCK_GPIO_Port GPIOA
#define SELECTOR_M1_Pin GPIO_PIN_2
#define SELECTOR_M1_GPIO_Port GPIOA
#define SELECTOR_M2_Pin GPIO_PIN_3
#define SELECTOR_M2_GPIO_Port GPIOA
#define STM_FPGA_MISO_Pin GPIO_PIN_6
#define STM_FPGA_MISO_GPIO_Port GPIOA
#define STM_FPGA_MOSI_Pin GPIO_PIN_7
#define STM_FPGA_MOSI_GPIO_Port GPIOA
#define UI_LED_G_Pin GPIO_PIN_0
#define UI_LED_G_GPIO_Port GPIOB
#define UI_LED_R_Pin GPIO_PIN_1
#define UI_LED_R_GPIO_Port GPIOB
#define UI_LED_B_Pin GPIO_PIN_2
#define UI_LED_B_GPIO_Port GPIOB
#define STM_UI_SCK_Pin GPIO_PIN_10
#define STM_UI_SCK_GPIO_Port GPIOB
#define FPGA_DONE_Pin GPIO_PIN_15
#define FPGA_DONE_GPIO_Port GPIOB
#define FPGA_DONE_EXTI_IRQn EXTI15_10_IRQn
#define SD_DETECT_INT_Pin GPIO_PIN_7
#define SD_DETECT_INT_GPIO_Port GPIOC
#define SELECTOR_M3_Pin GPIO_PIN_8
#define SELECTOR_M3_GPIO_Port GPIOA
#define USB_VBUS_INT_Pin GPIO_PIN_10
#define USB_VBUS_INT_GPIO_Port GPIOA
#define USB_VBUS_INT_EXTI_IRQn EXTI15_10_IRQn
#define ARM_BUTTON_Pin GPIO_PIN_4
#define ARM_BUTTON_GPIO_Port GPIOB
#define ARM_BUTTON_EXTI_IRQn EXTI4_IRQn
#define TRIG_SRC0_Pin GPIO_PIN_5
#define TRIG_SRC0_GPIO_Port GPIOB
#define TRIG_SRC1_Pin GPIO_PIN_8
#define TRIG_SRC1_GPIO_Port GPIOB
#define MEMORY_SIZE 524288
#define DAC_MAX_VALUE 4096
#define VREF_VOLTAGE 3.3
