Drident/High_Speed_Data/TB_2023_Logger/forget_code/spi_exemple.cpp

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

/* Includes ------------------------------------------------------------------*/
#include "main.h"

/* USER CODE BEGIN Includes */
#include <stdio.h>
/* USER CODE END Includes */

SPI_HandleTypeDef hspi1;

UART_HandleTypeDef huart2;

/* USER CODE BEGIN PV */

// 25AA040A instructions
const uint8_t EEPROM_READ = 0b00000011;
const uint8_t EEPROM_WRITE = 0b00000010;
const uint8_t EEPROM_WRDI = 0b00000100;
const uint8_t EEPROM_WREN = 0b00000110;
const uint8_t EEPROM_RDSR = 0b00000101;
const uint8_t EEPROM_WRSR = 0b00000001;

/* USER CODE END PV */

void SystemClock_Config(void);
static void MX_GPIO_Init(void);
static void MX_SPI1_Init(void);
static void MX_USART2_UART_Init(void);
/**
  * @brief  The application entry point.
  * @retval int
  */
int main(void)
{
  /* USER CODE BEGIN 1 */
  char uart_buf[50];
  int uart_buf_len;
  char spi_buf[20];
  uint8_t addr;
  uint8_t wip;

  /* USER CODE END 1 */

  /* MCU Configuration--------------------------------------------------------*/

  /* Reset of all peripherals, Initializes the Flash interface and the Systick. */
  HAL_Init();

  /* Configure the system clock */
  SystemClock_Config();

  /* Initialize all configured peripherals */
  MX_GPIO_Init();
  MX_SPI1_Init();
  MX_USART2_UART_Init();
  /* USER CODE BEGIN 2 */

  // CS pin should default high
  HAL_GPIO_WritePin(GPIOB, GPIO_PIN_6, GPIO_PIN_SET);

  // Say something
  uart_buf_len = sprintf(uart_buf, "SPI Test\r\n");
  HAL_UART_Transmit(&huart2, (uint8_t *)uart_buf, uart_buf_len, 100);

  // Enable write enable latch (allow write operations)
  HAL_GPIO_WritePin(GPIOB, GPIO_PIN_6, GPIO_PIN_RESET);
  HAL_SPI_Transmit(&hspi1, (uint8_t *)&EEPROM_WREN, 1, 100);
  HAL_GPIO_WritePin(GPIOB, GPIO_PIN_6, GPIO_PIN_SET);

  // Read status register
  HAL_GPIO_WritePin(GPIOB, GPIO_PIN_6, GPIO_PIN_RESET);
  HAL_SPI_Transmit(&hspi1, (uint8_t *)&EEPROM_RDSR, 1, 100);
  HAL_SPI_Receive(&hspi1, (uint8_t *)spi_buf, 1, 100);
  HAL_GPIO_WritePin(GPIOB, GPIO_PIN_6, GPIO_PIN_SET);

  // Print out status register
  uart_buf_len = sprintf(uart_buf,
                          "Status: 0xx\r\n",
                          (unsigned int)spi_buf[0]);
  HAL_UART_Transmit(&huart2, (uint8_t *)uart_buf, uart_buf_len, 100);

  // Test bytes to write to EEPROM
  spi_buf[0] = 0xAB;
  spi_buf[1] = 0xCD;
  spi_buf[2] = 0xEF;

  // Set starting address
  addr = 0x05;

  // Write 3 bytes starting at given address
  HAL_GPIO_WritePin(GPIOB, GPIO_PIN_6, GPIO_PIN_RESET);
  HAL_SPI_Transmit(&hspi1, (uint8_t *)&EEPROM_WRITE, 1, 100);
  HAL_SPI_Transmit(&hspi1, (uint8_t *)&addr, 1, 100);
  HAL_SPI_Transmit(&hspi1, (uint8_t *)spi_buf, 3, 100);
  HAL_GPIO_WritePin(GPIOB, GPIO_PIN_6, GPIO_PIN_SET);

  // Clear buffer
  spi_buf[0] = 0;
  spi_buf[1] = 0;
  spi_buf[2] = 0;

  // Wait until WIP bit is cleared
  wip = 1;
  while (wip)
  {
    // Read status register
    HAL_GPIO_WritePin(GPIOB, GPIO_PIN_6, GPIO_PIN_RESET);
    HAL_SPI_Transmit(&hspi1, (uint8_t *)&EEPROM_RDSR, 1, 100);
    HAL_SPI_Receive(&hspi1, (uint8_t *)spi_buf, 1, 100);
    HAL_GPIO_WritePin(GPIOB, GPIO_PIN_6, GPIO_PIN_SET);

    // Mask out WIP bit
    wip = spi_buf[0] & 0b00000001;
  }

  // Read the 3 bytes back
  HAL_GPIO_WritePin(GPIOB, GPIO_PIN_6, GPIO_PIN_RESET);
  HAL_SPI_Transmit(&hspi1, (uint8_t *)&EEPROM_READ, 1, 100);
  HAL_SPI_Transmit(&hspi1, (uint8_t *)&addr, 1, 100);
  HAL_SPI_Receive(&hspi1, (uint8_t *)spi_buf, 3, 100);
  HAL_GPIO_WritePin(GPIOB, GPIO_PIN_6, GPIO_PIN_SET);

  // Print out bytes read
  uart_buf_len = sprintf(uart_buf,
                          "0xx 0xx 0xx\r\n",
                          (unsigned int)spi_buf[0],
                          (unsigned int)spi_buf[1],
                          (unsigned int)spi_buf[2]);
  HAL_UART_Transmit(&huart2, (uint8_t *)uart_buf, uart_buf_len, 100);

  // Read status register
  HAL_GPIO_WritePin(GPIOB, GPIO_PIN_6, GPIO_PIN_RESET);
  HAL_SPI_Transmit(&hspi1, (uint8_t *)&EEPROM_RDSR, 1, 100);
  HAL_SPI_Receive(&hspi1, (uint8_t *)spi_buf, 1, 100);
  HAL_GPIO_WritePin(GPIOB, GPIO_PIN_6, GPIO_PIN_SET);

  // Print out status register
  uart_buf_len = sprintf(uart_buf,
                          "Status: 0xx\r\n",
                          (unsigned int)spi_buf[0]);
  HAL_UART_Transmit(&huart2, (uint8_t *)uart_buf, uart_buf_len, 100);

  /* USER CODE END 2 */

  /* Infinite loop */
  /* USER CODE BEGIN WHILE */
  while (1)
  {
    /* USER CODE END WHILE */

    /* USER CODE BEGIN 3 */
  }
  /* USER CODE END 3 */
}

/***
 * REST OF MAIN.C
 * ...
 */
