Drident/High_Speed_Data/Bachelor/bachelor/hdl/cont_done_test.vhd

--
-- VHDL Architecture Bachelor.cont_done.test
--
-- Created:
--          by - christop.grobety.UNKNOWN (WE2332207)
--          at - 15:10:10 30.05.2023
--
-- using Mentor Graphics HDL Designer(TM) 2019.2 (Build 5)
--
LIBRARY Common;
  USE Common.CommonLib.all;

ARCHITECTURE test OF cont_done IS
    signal memoryTrig : unsigned((memory_size-1) downto 0);
    signal count_memory: unsigned((memory_size-1) downto 0);
    signal count_preTrig: unsigned((memory_size-1) downto 0);
    signal done_wait : unsigned(3 downto 0);
    constant wait_time          : natural := 4;
BEGIN
  done_Counter: process(reset, clock)
  begin
    if reset = '1' then
      memoryTrig <= (others => '1');
      count_preTrig <= (others => '0');
      count_memory <= (others => '0');
      done_wait <= (others => '0');
      done <= '0';
      Memory <= (others => '0');
    elsif rising_edge(clock) then
      if go = '1' then
        if Trigg = '0' and count_preTrig = 0  then 
          count_memory <= count_memory+1 ;
        elsif Trigg = '1' and count_preTrig = 0 then
          memoryTrig <= resize((memoryTrig/to_unsigned(100,memoryTrig'length))
                                             *preTriggVal,memoryTrig'length);
          if count_preTrig /= memoryTrig then
            count_memory <= count_memory+1 ;  
            count_preTrig <= count_preTrig+1;
          end if ;
        elsif count_preTrig >0 then
            if count_preTrig /= memoryTrig then
              count_memory <= count_memory+1 ;  
              count_preTrig <= count_preTrig+1;
          end if ;
        end if;

      elsif count_preTrig = memoryTrig and done = '0' then
          done <= '1';
          Memory <= count_memory;
      elsif done = '1' then
          count_preTrig <= (others => '0');
          count_memory <= (others => '0');
          done_wait <= done_wait+1 ;
          if done_wait = wait_time then
            done_wait <= (others => '0');
            done <= '0';
          end if;
      end if;
    end if;
  end process done_Counter;

END ARCHITECTURE test;
