Drident/High_Speed_Data/(notices)

Notices in the files:
TB_2023_Logger/forget_code/spi_exemple.cpp:
© Copyright (c) 2020 STMicroelectronics.
All rights reserved.
This software component is licensed by ST under BSD 3-Clause license,
the "License"; You may not use this file except in compliance with the
License. You may obtain a copy of the License at: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
AltiumLibs/SMS-107-02-G-S.stp:
author */ ('License CC BY-ND 4.0'),
